TDX33029/BTCMinerControl/Miner/ST/PINOUT_DIAGRAM.html

# STM32F107VCT6 + BM1366 Miner Bridge

BTCMinerControl Pinout Diagram — Corrections applied 2026-07-12

Function | Pin | Dir | Connection | Config
ETH ETH MDC | PC1 | OUT | DP83848 MDC (pin 30) | AF Push-Pull
ETH ETH MDIO | PA2 | I/O | DP83848 MDIO (pin 31, 1.5k pull-up) | AF Push-Pull
ETH ETH REF_CLK | PA1 | IN | DP83848 X1/REF_CLK (50MHz) | Input Floating
ETH ETH CRS_DV | PA7 | IN | DP83848 CRS_DV (pin 40) | Input Floating
ETH ETH RXD0 | PC4 | IN | DP83848 RXD_0 (pin 43) | Input Floating
ETH ETH RXD1 | PC5 | IN | DP83848 RXD_1 (pin 44) | Input Floating
ETH ETH TX_EN | PB11 | OUT | DP83848 TX_EN (pin 2) | AF Push-Pull
ETH ETH TXD0 | PB12 | OUT | DP83848 TXD_0 (pin 3) | AF Push-Pull
ETH ETH TXD1 | PB13 | OUT | DP83848 TXD_1 (pin 4) | AF Push-Pull
ETH ETH RST# | PD2 | OUT | DP83848 RESET_N (pin 29) | Push-Pull
ASIC ASIC TX | PA9 | OUT | BM1366 RX (chain head) | AF Push-Pull
ASIC ASIC RX | PA10 | IN | BM1366 TX | Input Floating
ASIC ASIC RST | PB0 | OUT | BM1366 hardware reset | Push-Pull
ASIC ASIC BOOT | PB1 | OUT | BM1366 BOOT (optional) | Push-Pull
ASIC ASIC CTRL | PB14 | OUT | BM1366 CTRL (optional) | Push-Pull
LED LED STATUS | PC13 | OUT | Onboard LED (low=on) | Push-Pull
LED LED LINK | PD12 | OUT | ETH link indicator | Push-Pull
LED LED ACT | PD13 | OUT | ETH activity indicator | Push-Pull
DBG SWDIO | PA13 | I/O | Debug data | SWD
DBG SWCLK | PA14 | IN | Debug clock | SWD

? Fixes applied (2026-07-12):

1. Clock: PLLMul=9?14, SYSCLK now 70MHz (was 45MHz). SysTick reload fixed.
2. ETH PREDIV2: Added RCC_PREDIV2Config(Div5) ? PLL2 was running at 250MHz instead of 50MHz!
3. RMII mode: AFIO->MAPR MII_RMII_SEL bit was not set ? MAC was in MII mode with wrong pinout.
4. AHB clock: Added RCC_AHBPeriphClockCmd for ETH_MAC/Tx/Rx ? missing entirely.
5. LEDs: PD12 (LINK) and PD13 (ACT) added ? were documented but never initialized.
6. RCC_APB2Periph_ETH: Removed ? not defined in library V3.5; replaced with direct reg access.
