TDX33029/BTCMinerControl/Miner/BM1397-master/BM1397-master/images/Untitled 1.png

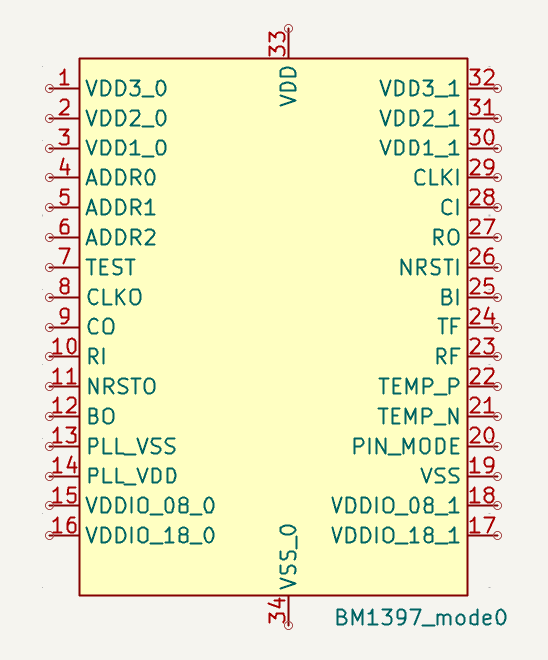
Miner/BM1397-master/BM1397-master/images/Untitled 1.png
