TDX33029/BTCMinerControl/PCB/Original/bitaxeUltra-ultra-205/bitaxeUltra-ultra-205/doc/back.png

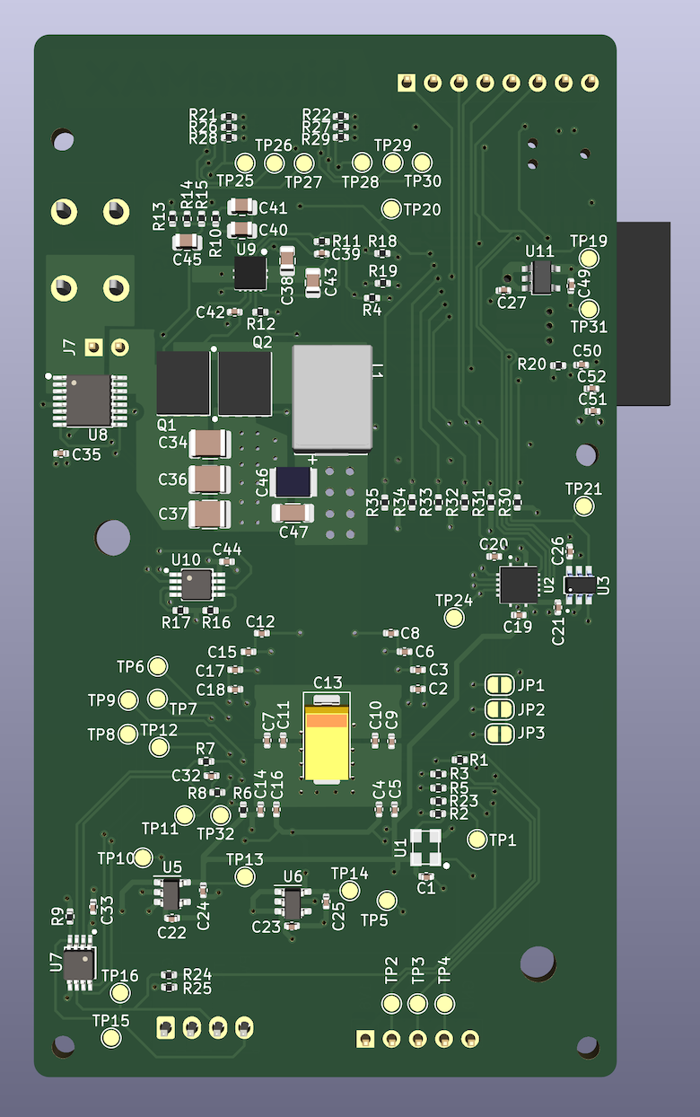
PCB/Original/bitaxeUltra-ultra-205/bitaxeUltra-ultra-205/doc/back.png
