TDX33029/BTCMinerControl/PCB/Original/bitaxeUltra-ultra-205/bitaxeUltra-ultra-205/doc/bitaxe_204.jpg

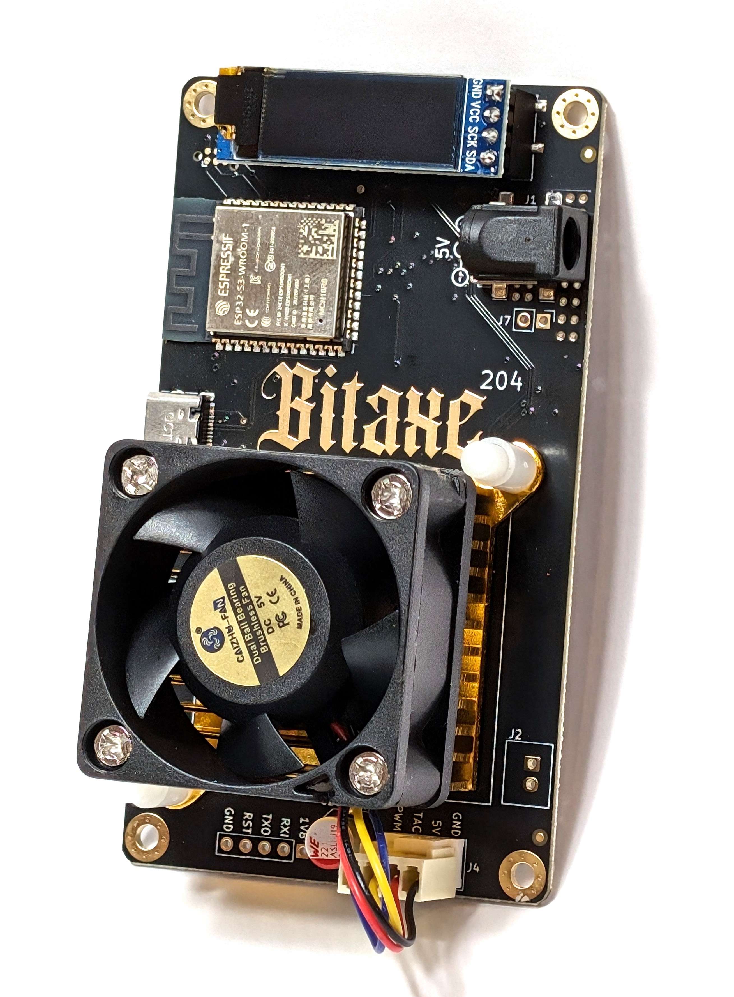
PCB/Original/bitaxeUltra-ultra-205/bitaxeUltra-ultra-205/doc/bitaxe_204.jpg
