TDX33029/BTCMinerControl/PCB/Original/bitaxeUltra-ultra-205/bitaxeUltra-ultra-205/doc/bitaxe_v2.jpg

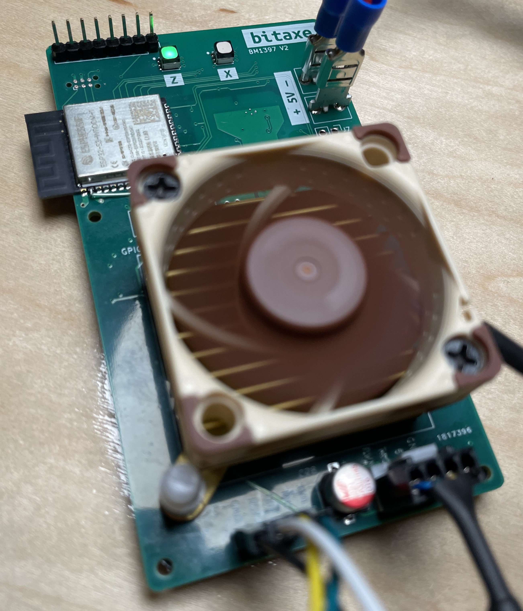
PCB/Original/bitaxeUltra-ultra-205/bitaxeUltra-ultra-205/doc/bitaxe_v2.jpg
