TDX33029/BTCMinerControl/PCB/Original/bitaxeUltra-ultra-205/bitaxeUltra-ultra-205/doc/bm1387.png

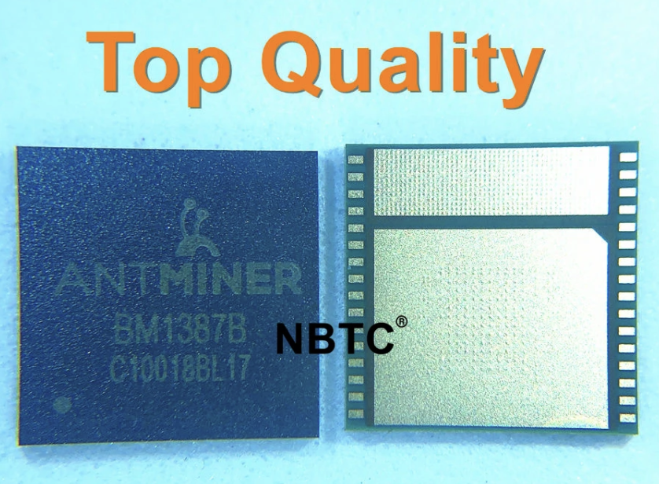
PCB/Original/bitaxeUltra-ultra-205/bitaxeUltra-ultra-205/doc/bm1387.png
