TDX33029/BTCMinerControl/PCB/Original/bitaxeUltra-ultra-205/bitaxeUltra-ultra-205/doc/BM1397.png

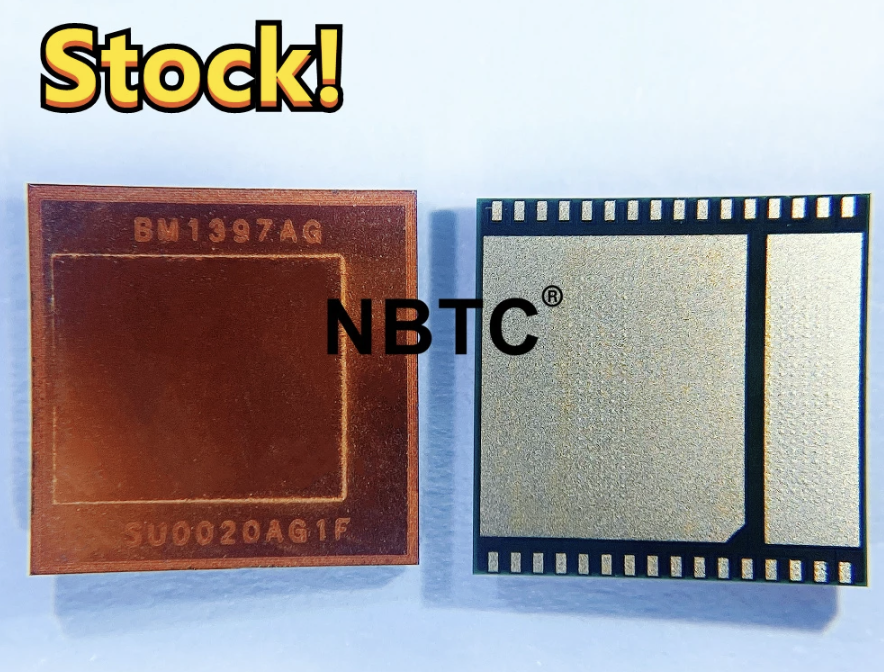
PCB/Original/bitaxeUltra-ultra-205/bitaxeUltra-ultra-205/doc/BM1397.png
