TDX33029/BTCMinerControl/PCB/Original/bitaxeUltra-ultra-205/bitaxeUltra-ultra-205/doc/built.png

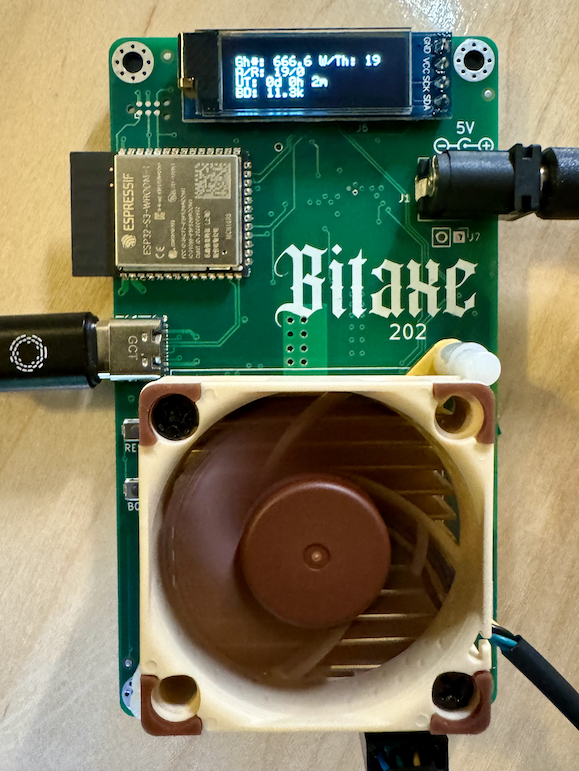
PCB/Original/bitaxeUltra-ultra-205/bitaxeUltra-ultra-205/doc/built.png
