TDX33029/BTCMinerControl/PCB/Original/bitaxeUltra-ultra-205/bitaxeUltra-ultra-205/doc/fan.png

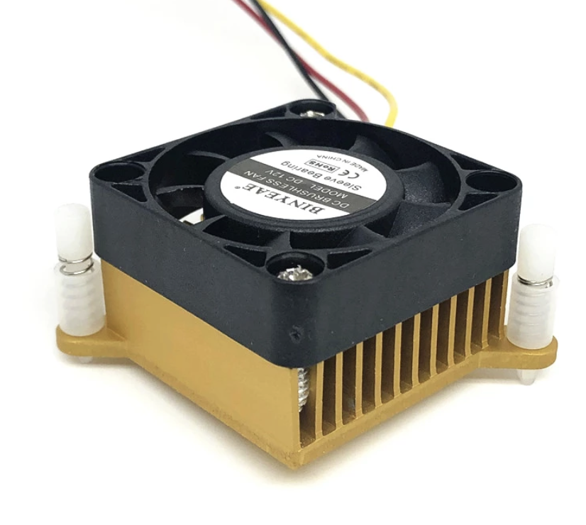
PCB/Original/bitaxeUltra-ultra-205/bitaxeUltra-ultra-205/doc/fan.png
