TDX33029/BTCMinerControl/PCB/Original/bitaxeUltra-ultra-205/bitaxeUltra-ultra-205/doc/front.png

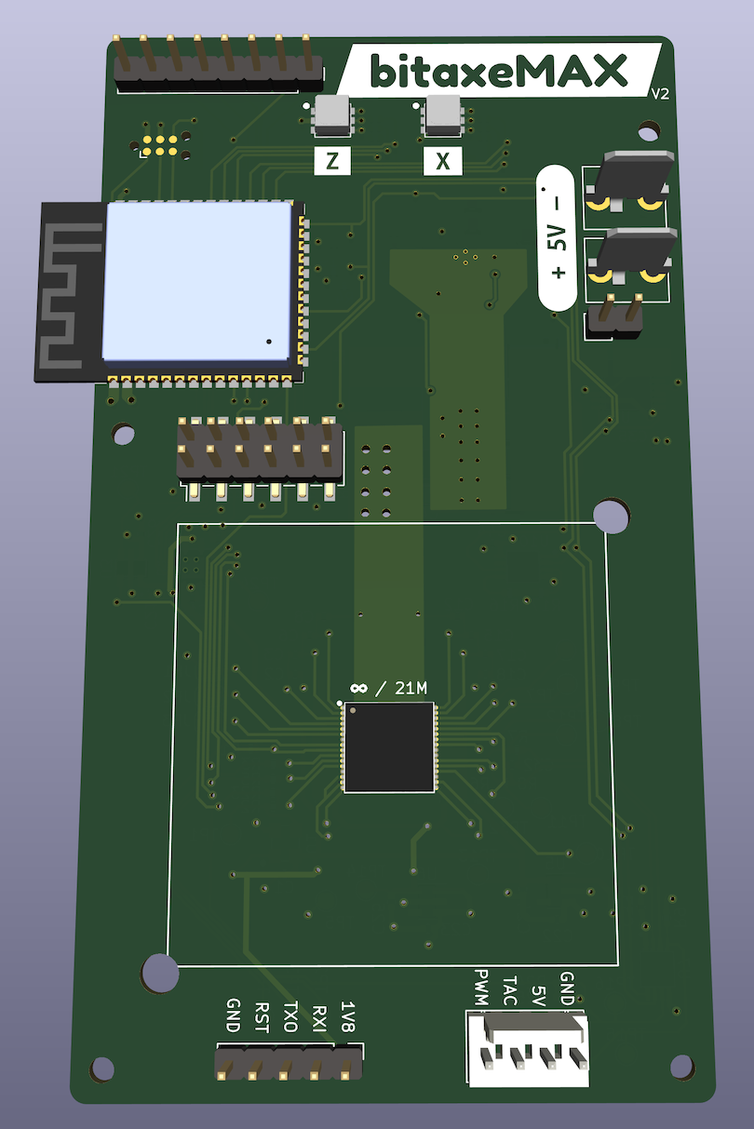
PCB/Original/bitaxeUltra-ultra-205/bitaxeUltra-ultra-205/doc/front.png
