TDX33029/BTCMinerControl/PCB/Original/bitaxeUltra-ultra-205/bitaxeUltra-ultra-205/doc/render.png

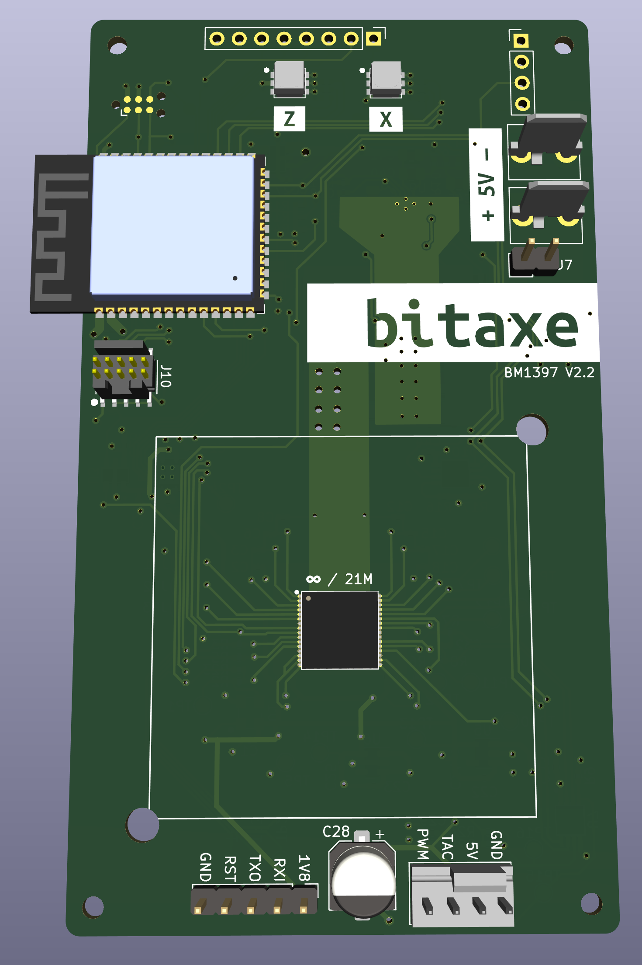
PCB/Original/bitaxeUltra-ultra-205/bitaxeUltra-ultra-205/doc/render.png
