TDX33029/BTCMinerControl/PCB/Original/bitaxeUltra-ultra-205/bitaxeUltra-ultra-205/doc/v2_both_sides.jpg

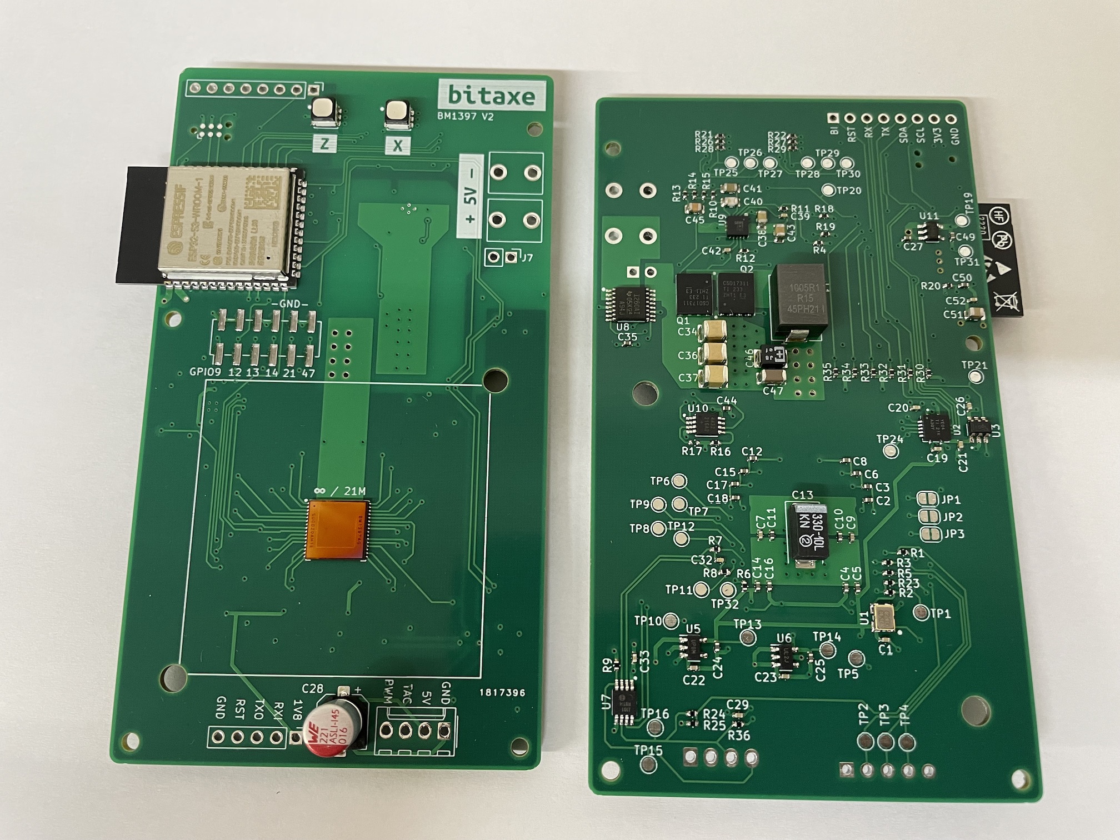
PCB/Original/bitaxeUltra-ultra-205/bitaxeUltra-ultra-205/doc/v2_both_sides.jpg
