TDX33029/BTCMinerControl/PCB/Original/ultraHex-master/ultraHex-master/_restore_backup_2026-07-17T15-32-36-407/doc/hex_render.jpg

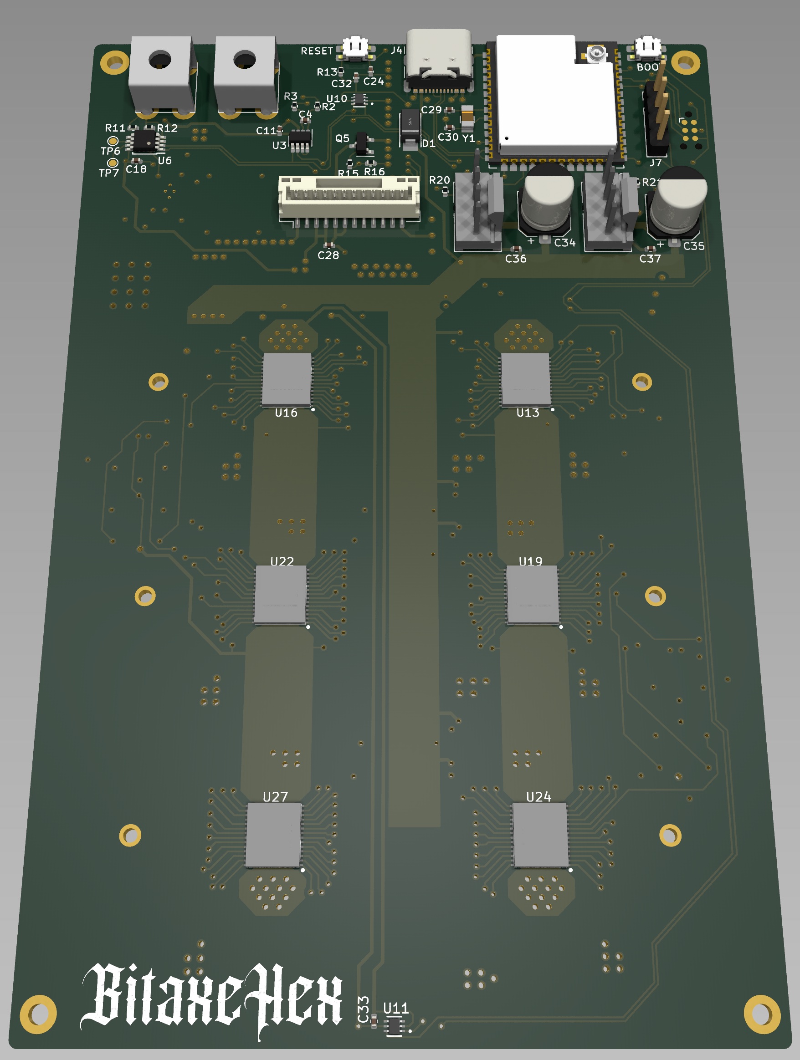
PCB/Original/ultraHex-master/ultraHex-master/_restore_backup_2026-07-17T15-32-36-407/doc/hex_render.jpg
