TDX33029/BTCMinerControl/PCB/v2-77582f2d4b02fbeb5f26dd9624d72930_1440w.webp

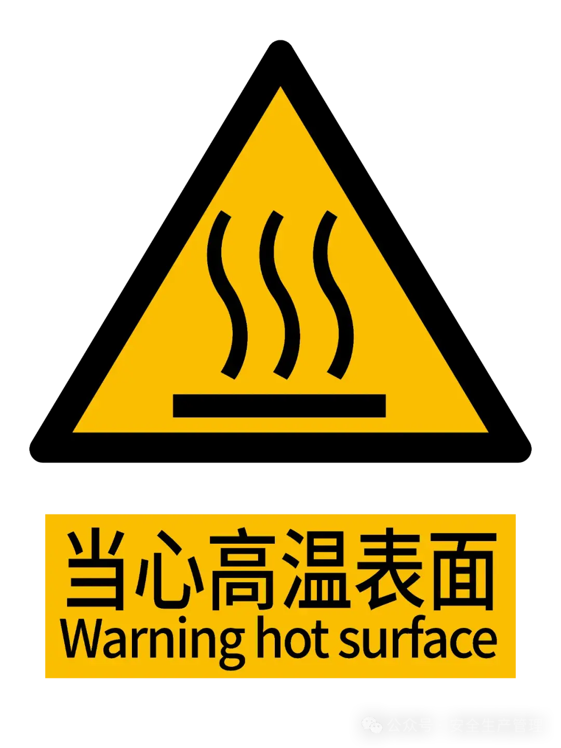
PCB/v2-77582f2d4b02fbeb5f26dd9624d72930_1440w.webp
