TDX33029/BTCMinerControl/PCB/Original/ultraHex-master/ultraHex-master/_restore_backup_2026-07-17T15-32-36-407/Manufacturing Files/bitaxeHex-301-BOM.xlsx

Qty | Reference(s) | Value | Footprint | DNP | DK | PARTNO | Value
4 | C1, C6, C9, C10 | 22uF | Capacitor_SMD:C_1210_3225Metric |  | 1276-3363-1-ND | CL32A106KBJNNNE | C
1 | C2 | 1uF | Capacitor_SMD:C_0805_2012Metric |  | 445-1419-1-ND | C2012X5R1E105K125AA | C
8 | C3, C23, C153, C154, C155, C156, C157, C159 | 10uF | Capacitor_SMD:C_0805_2012Metric |  | 490-18664-1-ND | GRM21BR61H106ME43L | C
1 | C4 | 1uF | Capacitor_SMD:C_0402_1005Metric | DNP |  |  | C
101 | C5, C11, C13, C16, C17, C18, C24, C38, C39, C40, C41, C42, C43, C46, C47, C48, C49, C50, C51, C52, C53, C54, C55, C56, C57, C58, C59, C60, C62, C63, C64, C65, C66, C67, C68, C69, C70, C71, C72, C73, C76, C77, C78, C79, C80, C81, C82, C83, C84, C85, C86, C87, C88, C89, C90, C92, C94, C95, C96, C97, C99, C100, C101, C103, C104, C105, C106, C107, C108, C109, C110, C111, C112, C115, C116, C117, C118, C119, C120, C121, C122, C123, C124, C125, C126, C127, C128, C129, C130, C131, C132, C133, C134, C135, C137, C138, C139, C143, C144, C148, C149 | 1uF | Capacitor_SMD:C_0402_1005Metric |  | 587-5514-1-ND | EMK105BJ105MV-F | C
1 | C7 | 1uF | Capacitor_SMD:C_0603_1608Metric |  | 445-12539-1-ND | CGA3E1X7R1C105K080A | C
1 | C8 | 220nF | Capacitor_SMD:C_0603_1608Metric |  | 445-12448-1-ND | CGA3E2X5R1C224M080AA | C
1 | C12 | 0.1uF | Capacitor_SMD:C_0603_1608Metric |  | 478-KGM15BR71H104KTCT-ND | KGM15BR71H104KT | C
1 | C14 | 27nF | Capacitor_SMD:C_0402_1005Metric |  | 399-C0402C273K9PAC7867CT-ND | C0402C273K9PAC7867 | C
1 | C19 | 1nF | Capacitor_SMD:C_0402_1005Metric |  | 490-3244-1-ND | GRM1555C1H102JA01D | C
1 | C20 | 120pF | Capacitor_SMD:C_0402_1005Metric |  | 13-CC0402JPNPO9BN121CT-ND | CC0402JPNPO9BN121 | C
1 | C21 | 100pF | Capacitor_SMD:C_0402_1005Metric |  | 13-CC0402JRX7R7BB101CT-ND | CC0402JRX7R7BB101 | C
1 | C22 | 220nF | Capacitor_SMD:C_0402_1005Metric |  | 311-1421-1-ND | CC0402KRX5R6BB224 | C
27 | C25, C26, C27, C28, C31, C32, C33, C36, C37, C44, C45, C61, C74, C75, C91, C93, C102, C113, C114, C136, C140, C141, C142, C146, C147, C151, C158 | 0.1uF | Capacitor_SMD:C_0402_1005Metric |  | 1292-1639-1-ND | 0402X104K100CT | 311-3342-1-ND
2 | C29, C30 | 6.8pF | Capacitor_SMD:C_0402_1005Metric |  | 399-C0402C689C5GAC7867CT-ND | C0402C689C5GAC7867 | C
2 | C34, C35 | 220uF | Capacitor_SMD:CP_Elec_6.3x7.7 |  | 732-8422-1-ND | 865080345012 | C_Polarized
3 | C98, C145, C150 | 330uF | Capacitor_Tantalum_SMD:CP_EIA-7343-31_Kemet-D_Pad2.25x2.55mm_HandSolder |  | 718-1028-1-ND | 293D337X9010E2TE3 | C_Polarized
1 | C152 | 150pF | Capacitor_SMD:C_0402_1005Metric |  | 13-CC0402JPNPO9BN151CT-ND | CC0402JPNPO9BN151 | C
1 | D1 | SS310 | Diode_SMD:D_SMA |  | SK310A-LTPMSCT-ND | SK310A-LTP | SS310_C85658
1 | D2 | XBS104S13R-G | Diode_SMD:D_SOD-323 |  | 893-1188-1-ND | XBS104S13R-G | SS310_C85658
1 | J1 | Screw Terminal | bitaxe:7771-screw-terminal |  | 36-7771-ND | 36-7771 | Conn_01x01
1 | J2 | Screw Terminal | bitaxe:7771-screw-terminal |  | 36-7771-ND | 36-7771 | Conn_01x01
1 | J4 | USB_C_Receptacle_USB2.0 | Connector_USB:USB_C_Receptacle_GCT_USB4105-xx-A_16P_TopMnt_Horizontal |  | 2073-USB4105-GF-ACT-ND | USB4105-GF-A | USB_C_Receptacle_USB2.0
2 | J5, J6 | Conn_01x04 | bitaxe:470531000 |  | WM4330-ND | 470531000 | Conn_01x04
1 | J8 | ST7789 176x320 | bitaxe:JST_GH_BM12B-GHS-TBT_1x12-1MP_P1.25mm_Vertical |  | 455-BM12B-GHS-TBTCT-ND | BM12B-GHS-TBT | ST7789 176x320
1 | L1 | 470nH | bitaxe:744373580047 |  | 732-7221-1-ND | 744373580047 | L
1 | L2 | 8.2 uH | bitaxe:74438357082 |  | 732-11745-1-ND | 78438357082 | L
1 | Q1 | CSD17303Q5 | bitaxe:SON-Q5-MOSFET |  | 296-27232-1-ND | CSD17303Q5 | Q_NMOS_CSD16340Q3
1 | Q2 | CSD17573Q5B | bitaxe:SON-Q5-MOSFET |  | 296-39836-1-ND | CSD17573Q5B | Q_NMOS_CSD17573Q5B
1 | Q5 | 2N7002K | Package_TO_SOT_SMD:SOT-323_SC-70 |  | 2N7002KWCT-ND | 2N7002KW | 2N7002K
1 | R1 | 2m | Resistor_SMD:R_1206_3216Metric |  | 13-PA1206FRE7W0R002ZCT-ND | PA1206FRE7W0R002Z | R_US
5 | R2, R3, R36, R43, R70 | 0R | Resistor_SMD:R_0402_1005Metric |  | 311-0.0JRCT-ND | RC0402JR-070RL | R_US
2 | R4, R114 | 11.8K | Resistor_SMD:R_0402_1005Metric |  | YAG2958CT-ND | RC0402FR-0711K8L | R_US
1 | R5 | 2.21R | Resistor_SMD:R_0402_1005Metric |  | 13-RC0402FR-072R21LCT-ND | RC0402FR-072R21L | R_US
1 | R6 | 3.83K | Resistor_SMD:R_0402_1005Metric |  | 311-3.83KLRCT-ND | RC0402FR-073K83L | R_US
21 | R7, R13, R16, R22, R45, R46, R52, R53, R64, R65, R73, R74, R76, R79, R80, R83, R84, R94, R95, R104, R105 | 10k | Resistor_SMD:R_0402_1005Metric |  | 311-10KJRCT-ND | RC0402JR-0710KL | R_US
1 | R8 | 887R | Resistor_SMD:R_0402_1005Metric |  | YAG3252CT-ND | RC0402FR-07887RL | R_US
3 | R9, R10, R85 | 7.87K | Resistor_SMD:R_0402_1005Metric |  | 311-7.87KLRCT-ND | RC0402FR-077K87L | R_US
1 | R11 | 80k | Resistor_SMD:R_0402_1005Metric |  | 311-80.6KLRCT-ND | RC0402FR-0780K6L | R_US
1 | R12 | DNP | Resistor_SMD:R_0402_1005Metric | DNP |  |  | R_US
2 | R14, R107 | 20K | Resistor_SMD:R_0402_1005Metric |  | 311-20.0KLRCT-ND | RC0402FR-0720KL | R_US
19 | R15, R44, R50, R51, R59, R63, R71, R72, R75, R77, R78, R81, R82, R88, R93, R102, R103, R106, R108 | 1k | Resistor_SMD:R_0402_1005Metric |  | 311-1.00KLRCT-ND | RC0402FR-071KL | R_US
20 | R17, R29, R30, R31, R33, R37, R39, R40, R47, R48, R49, R61, R66, R67, R69, R92, R96, R97, R101, R109 | 33R | Resistor_SMD:R_0402_1005Metric |  | 311-33.0LRCT-ND | RC0402FR-0733RL | R_US
6 | R23, R32, R38, R41, R42, R58 | 33R | Resistor_SMD:R_0402_1005Metric | DNP |  |  | R_US
2 | R18, R19 | 5.1k | Resistor_SMD:R_0402_1005Metric |  | 13-RC0402FR-135K1LCT-ND | RC0402FR-135K1L | R_US
2 | R20, R21 | 5.6k | Resistor_SMD:R_0402_1005Metric |  | 13-RC0402FR-135K6LCT-ND | RC0402FR-135K6L | R_US
10 | R24, R25, R27, R54, R55, R56, R86, R87, R89, R112 | 115K | Resistor_SMD:R_0402_1005Metric |  | YAG2956CT-ND | RC0402FR-07115KL | R_US
3 | R28, R57, R90 | 402K | Resistor_SMD:R_0402_1005Metric |  | YAG3015CT-ND | RC0402FR-07182KL | R_US
3 | R26, R60, R91 | 2k | Resistor_SMD:R_0402_1005Metric |  | YAG2303CT-ND | RT0402BRD072KL | R_US
6 | R34, R35, R62, R68, R98, R99 | 1R | Resistor_SMD:R_2512_6332Metric |  | CRM2512-JW-1R0ELFCT-ND | CRM2512-JW-1R0ELF | R_US
1 | R110 | 4.02K | Resistor_SMD:R_0402_1005Metric |  | 311-4.02KLRCT-ND | RC0402FR-074K02L | R_US
1 | R111 | 140R | Resistor_SMD:R_0402_1005Metric |  | 311-140LRCT-ND | RC0402FR-07140RL | R_US
2 | R100, R113 | 22.1K | Resistor_SMD:R_0402_1005Metric |  | 311-22.1KLRCT-ND | RC0402FR-0722K1L | R_US
2 | SW1, SW2 | EVQ-9P701P | bitaxe:EVQ9P701P-switch |  | P19095CT-ND | EVQ-9P701P | GT-TC029B-H025-L1N
1 | U1 | LMR54410 | Package_TO_SOT_SMD:SOT-23-6 |  | 296-LMR54410DBVRCT-ND | LMR54410FDBVR | LMR54410
1 | U2 | RT9080-33GJ5 | bitaxe:RT9080-33GJ5 |  | 1028-1509-1-ND | RT9080-33GJ5 | RT9080-33GJ5
1 | U3 | INA219AID | Package_TO_SOT_SMD:SOT-23-8 |  | 296-33291-5-ND | INA219AID | INA219AIDCNR
1 | U4 | LM27402 | Package_DFN_QFN:WQFN-16-1EP_4x4mm_P0.5mm_EP2.6x2.6mm_ThermalVias |  | LM27402SQ/NOPBCT-ND | LM27402SQ/NOPB | LM27402
1 | U5 | MIC5504 | Package_TO_SOT_SMD:SOT-23-5_HandSoldering |  | 576-4879-1-ND | MIC5504-1.8YM5-TR | MIC5504
1 | U6 | DS4432U+ | Package_SO:TSSOP-8_3x3mm_P0.65mm |  | DS4432U+-ND | DS4432U+ | DS4432U+
1 | U7 | SN74AVC4T774 | Package_SO:TSSOP-16_4.4x5mm_P0.65mm |  | 296-24739-1-ND | SN74AVC4T774PWR | SN74AVC4T774
3 | U8, U17, U28 | 25MHz | bitaxe:O 25,0-JO32-B-1V3-1-T1-LF |  | 1908-O250-JO32-B-1V3-1-T1-LFCT-ND | O 25,0-JO32-B-1V3-1-T1-LF | oscillator
1 | U9 | ESP32-S3-WROOM-1 | bitaxe:ESP32-S3-WROOM-1U |  | 1965-ESP32-S3-WROOM-1U-N16R8CT-ND | ESP32-S3-WROOM-1U-N16R8 | ESP32-S3-WROOM-1
1 | U10 | TMP1075 | bitaxe:SOT5X3-6_DRL_TEX |  | 296-TMP1075NDRLRCT-ND | TMP1075NDRLR | TMP1075
1 | U11 | TMP1075 | bitaxe:SOT5X3-6_DRL_TEX |  | 296-TMP1075NDRLRCT-ND | TMP1075NDRLR | TMP1075
1 | U12 | EMC2302 | Package_SO:MSOP-10_3x3mm_P0.5mm |  | EMC2302-2-AIZL-CT-ND | EMC2302-2-AIZL-TR | EMC2302-2-AIZL-TR
6 | U13, U16, U19, U22, U24, U27 | BM1366_mode1 | bitaxe:BM1366 |  |  |  | BM1366_mode1
6 | U14, U15, U20, U21, U25, U26 | AP7331 | Package_TO_SOT_SMD:TSOT-23-5 |  | AP7331-WG-7DICT-ND | AP7331-WG-7 | AP7331-WG-7
2 | U18, U23 | TLV3544 | Package_SO:TSSOP-14_4.4x5mm_P0.65mm |  | 296-45352-1-ND | TLV3544IPWR | TLV3544
1 | Y1 | 32.768kHz | bitaxe:SC32S-7PF20PPM |  | 728-1074-1-ND | SC32S-7PF20PPM | Crystal
