TDX33029/BTCMinerControl/PCB/Original/ultraHex-master/ultraHex-master/_restore_backup_2026-07-17T15-32-36-407/Manufacturing Files/bitaxeHex-302-BOM.xlsx

Sheet: bitaxeHex
Bitaxe Hex v302 BOM
Qty | Reference(s) | Value | Footprint | DK | PARTNO
1 | R1 | DNP | Resistor_SMD:R_0402_1005Metric
1 | R2 | 17.8K | Resistor_SMD:R_0402_1005Metric | RMCF0402FT17K8TR-ND | RMCF0402FT17K8TR
1 | R3 | DNP | Resistor_SMD:R_0402_1005Metric
1 | R4 | 17.8K | Resistor_SMD:R_0402_1005Metric | RMCF0402FT17K8TR-ND | RMCF0402FT17K8
1 | R5 | 10K | Resistor_SMD:R_0402_1005Metric | RMCF0402FT10K0TR-ND | RMCF0402FT10K0
1 | R6 | 31.6K | Resistor_SMD:R_0402_1005Metric | YAG3115TR-ND | RC0402FR-0731K6L
1 | R7 | DNP | Resistor_SMD:R_0402_1005Metric
1 | R10 | 26.1K | Resistor_SMD:R_0402_1005Metric | 311-26.1KLRTR-ND | RC0402FR-0726K1L
22 | R15, R18, R22, R28, R29, R30, R47, R48, R59, R60, R67, R68, R75, R76, R81, R82, R86, R87, R100, R101, R105, R106 | 10k | Resistor_SMD:R_0402_1005Metric | 311-10KJRCT-ND | RC0402JR-0710KL
1 | R8 | 12.7K | Resistor_SMD:R_0402_1005Metric | YAG2964CT-ND | RC0402FR-0712K7L
2 | R9, R17 | 1.37K | Resistor_SMD:R_0402_1005Metric | YAG3035CT-ND | RC0402FR-071K37L
10 | R11, R31, R32, R33, R54, R55, R57, R88, R89, R90 | 115k | Resistor_SMD:R_0402_1005Metric | YAG2956CT-ND | RC0402FR-07115KL
2 | R12, R20 | 22.1k | Resistor_SMD:R_0402_1005Metric | 311-22.1KLRCT-ND | RC0402FR-0722K1L
1 | R13 | 10R | Resistor_SMD:R_0402_1005Metric | 311-10.0LRCT-ND | RC0402FR-0710RL
1 | R14 | 1R | Resistor_SMD:R_1206_3216Metric | CSR1206FT1R00CT-ND | CSR1206FT1R00
1 | R16 | 49.9R | Resistor_SMD:R_0402_1005Metric | 311-49.9LRCT-ND | RC0402FR-0749R9L
1 | R19 | 7.87k | Resistor_SMD:R_0402_1005Metric | 311-7.87KLRCT-ND | RC0402FR-077K87L
1 | R21 | 20k | Resistor_SMD:R_0402_1005Metric | 311-20.0KLRCT-ND | RC0402FR-0720KL
19 | R23, R46, R52, R58, R62, R66, R71, R74, R77, R79, R80, R84, R85, R94, R99, R102, R104, R107, R108 | 1k | Resistor_SMD:R_0402_1005Metric | 311-1.00KLRCT-ND | RC0402FR-071KL
2 | R24, R25 | 5.1k | Resistor_SMD:R_0402_1005Metric | 13-RC0402FR-135K1LCT-ND | RC0402FR-135K1L
2 | R26, R27 | 5.6k | Resistor_SMD:R_0402_1005Metric | 13-RC0402FR-135K6LCT-ND | RC0402FR-135K6L
3 | R34, R56, R91 | 402K | Resistor_SMD:R_0402_1005Metric | YAG3151CT-ND | RC0402FR-07402KL
20 | R35, R36, R37, R41, R43, R44, R45, R49, R50, R51, R61, R69, R70, R72, R78, R83, R92, R93, R95, R103 | 33 | Resistor_SMD:R_0402_1005Metric | 311-33.0LRCT-ND | RC0402FR-0733RL
6 | R38, R39, R63, R65, R96, R98 | 1 | Resistor_SMD:R_2512_6332Metric | CRM2512-JW-1R0ELFCT-ND | CRM2512-JW-1R0ELF
3 | R40, R64, R97 | 2k | Resistor_SMD:R_0402_1005Metric | YAG2303CT-ND | RT0402BRD072KL
6 | R42, R53, R73, R109, R110, R111 | 0 | Resistor_SMD:R_0402_1005Metric | 311-0.0JRCT-ND | RC0402JR-070RL
1 | C1 | 4.7nF | Capacitor_SMD:C_0402_1005Metric | 490-1309-1-ND | GRM155R71E472KA01D
2 | C2, C29 | 180uF | Capacitor_SMD:CP_Elec_6.3x5.9 | P16479CT-ND | 16SVPF180M
5 | C3, C11, C19, C20, C30 | 10uF | Capacitor_SMD:C_0805_2012Metric | 490-18664-1-ND | GRM21BR61H106ME43L
4 | C4, C7, C8, C10 | 22uF | Capacitor_SMD:C_1210_3225Metric | 490-3889-1-ND | GRM32ER61E226KE15L
1 | C5 | 1uF | Capacitor_SMD:C_0603_1608Metric | 490-1550-1-ND | GRM188R60J105KA01D
1 | C6 | 0.1uF | Capacitor_SMD:C_0603_1608Metric | 478-KGM15BR71H104KTCT-ND | KGM15BR71H104KT
99 | C9, C17, C21, C24, C31, C45, C46, C47, C48, C51, C52, C53, C54, C55, C56, C57, C58, C59, C61, C63, C64, C65, C66, C67, C69, C70, C71, C72, C74, C75, C76, C77, C78, C79, C80, C81, C83, C85, C86, C87, C88, C89, C90, C91, C92, C93, C94, C96, C98, C99, C100, C101, C102, C104, C105, C106, C107, C108, C110, C111, C112, C113, C114, C116, C117, C118, C119, C120, C121, C122, C123, C124, C125, C128, C129, C130, C131, C132, C133, C134, C135, C137, C139, C140, C141, C142, C143, C144, C145, C146, C148, C150, C151, C152, C153, C154, C156, C157, C158 | 1uF | Capacitor_SMD:C_0402_1005Metric | 587-5514-1-ND | EMK105BJ105MV-F
27 | C12, C32, C33, C34, C35, C38, C39, C40, C43, C44, C49, C50, C60, C62, C73, C82, C84, C95, C97, C109, C115, C126, C127, C136, C138, C149, C155 | 0.1uF | Capacitor_SMD:C_0402_1005Metric | 478-KGM05AR71C104KHCT-ND | KGM05AR71C104KH
1 | C13 | 100nF | Capacitor_SMD:C_0402_1005Metric | 490-6321-1-ND | GRM155R71A104KA01D
2 | C14, C15 | 1uF | Capacitor_SMD:C_0805_2012Metric | 587-1291-1-ND | TMK212BJ105KG-T
2 | C16, C26 | 2.2nF | Capacitor_SMD:C_0402_1005Metric | 490-8257-1-ND | GRM155R61H222KA01D
1 | C18 | 4.7uF | Capacitor_SMD:C_0402_1005Metric | 490-14306-1-ND | GRM155R61A475MEAAD
1 | C22 | 1nF | Capacitor_SMD:C_0805_2012Metric | 311-1127-1-ND | CC0805KRX7R9BB102
1 | C23 | 100nF | Capacitor_SMD:C_0805_2012Metric | 478-KGM21NR71E104KTCT-ND | KGM21NR71E104KT
1 | C25 | 100pF | Capacitor_SMD:C_0402_1005Metric | 732-7431-1-ND | 885012005013
2 | C27, C28 | 47uF | Capacitor_SMD:C_1210_3225Metric | 490-6539-1-ND | GRM32ER61C476KE15L
2 | C41, C42 | 220uF | Capacitor_SMD:CP_Elec_6.3x7.7 | 732-8422-1-ND | 865080345012
3 | C68, C103, C147 | 330uF | Capacitor_Tantalum_SMD:CP_EIA-7343-31_Kemet-D_Pad2.25x2.55mm_HandSolder | 718-1028-1-ND | 293D337X9010E2TE3
1 | L1 | 8.2 uH | bitaxe:74438357082 | 732-11745-1-ND | 78438357082
1 | L2 | 680nH | Inductor_SMD:L_Coilcraft_XAL1010-XXX | 2457-XAL1010-681MED-ND | XAL1010-681MED
1 | Q1 | 2N7002K | Package_TO_SOT_SMD:SOT-323_SC-70 | 2N7002KWCT-ND | 2N7002KW
1 | D1 | SS310 | Diode_SMD:D_SMA | SK310A-LTPMSCT-ND | SK310A-LTP
1 | U1 | LMR54410 | Package_TO_SOT_SMD:SOT-23-6 | 296-LMR54410DBVRCT-ND | LMR54410FDBVR
1 | U2 | RT9080-33GJ5 | bitaxe:RT9080-33GJ5 | 1028-1509-1-ND | RT9080-33GJ5
1 | U3 | TPS546D24ARVFR | bitaxe:LQFN40-CLIP | 296-TPS546D24ARVFRCT-ND | TPS546D24ARVFR
1 | U4 | MIC5504 | Package_TO_SOT_SMD:SOT-23-5_HandSoldering | 576-4879-1-ND | MIC5504-1.8YM5-TR
1 | U5 | SN74AVC4T774 | Package_SO:TSSOP-16_4.4x5mm_P0.65mm | 296-24739-1-ND | SN74AVC4T774PWR
1 | U6 | ESP32-S3-WROOM-1 | bitaxe:ESP32-S3-WROOM-1U | 1965-ESP32-S3-WROOM-1U-N16R8CT-ND | ESP32-S3-WROOM-1U-N16R8
2 | U7, U8 | TMP1075 | bitaxe:SOT5X3-6_DRL_TEX | 296-TMP1075NDRLRCT-ND | TMP1075NDRLR
1 | U9 | EMC2302 | Package_SO:MSOP-10_3x3mm_P0.5mm | EMC2302-2-AIZL-CT-ND | EMC2302-2-AIZL-TR
6 | U10, U11, U16, U17, U23, U24 | AP7331 | Package_TO_SOT_SMD:TSOT-23-5 | AP7331-WG-7DICT-ND | AP7331-WG-7
6 | U12, U13, U18, U20, U22, U25 | BM1366 | bitaxe:BM1366
3 | U14, U19, U26 | 25MHz | bitaxe:O 25,0-JO32-B-1V3-1-T1-LF | 1908-O250-JO32-B-1V3-1-T1-LFCT-ND | O 25,0-JO32-B-1V3-1-T1-LF
2 | U15, U21 | TLV3544 | Package_SO:TSSOP-14_4.4x5mm_P0.65mm | 296-45352-1-ND | TLV3544IPWR
2 | SW1, SW2 | SWITCH-SPST | bitaxe:EVQ9P701P-switch | P19095CT-ND | EVQ-9P701P
2 | J1, J2 | Screw Terminal | bitaxe:7771-screw-terminal | 36-7771-ND | 36-7771
1 | J3 | Conn_02x05 | Connector_PinHeader_2.54mm:PinHeader_2x05_P2.54mm_Vertical
1 | J4 | Connector-12x1 | bitaxe:JST_GH_BM12B-GHS-TBT_1x12-1MP_P1.25mm_Vertical | 455-BM12B-GHS-TBTCT-ND | BM12B-GHS-TBT
1 | J7 | USB_C_Receptacle | Connector_USB:USB_C_Receptacle_GCT_USB4105-xx-A_16P_TopMnt_Horizontal | 2073-USB4105-GF-ACT-ND | USB4105-GF-A
2 | J8, J9 | Conn_01x04 | bitaxe:470531000 | WM4330-ND | 470531000

Sheet: Config
Config resistors
Pin |  |  | RefDes | Code | Rvalue
MSEL2 | Rmsel2t | top | R1
 | Rmsel2b | bottom | R5 |  | 0R
VSEL | Rvselt | top | R2 | 10 | 2.05K
 | Rvselb | bottom | R6 | 0 | 4.64K
ADRSEL | Radrt | top | R3 | 6 | 10K
 | Radrb | bottom | R7 | 4 | 10K
MSEL1 | Rmsel1t | top | R4 | 2 | 205.0K
 | Rmsel1b | bottom | R10 | 15 | 82.5K
