TDX33029/BTCMinerControl/PCB/Original/ultraHex-master/ultraHex-master/_restore_backup_2026-07-17T15-32-36-407/Manufacturing Files/bitaxeHex-300-BOM.xlsx

Sheet: BOM
Qty | Ref Des | Value | DK | Manufacturer | PARTNO | DNP
3 | C1, C2, C6 | 22uF | 445-1655-1-ND |  | CKG57NX5R1H226M500JH
1 | C3 | 0.33uF | 490-GRM155R61J334ME01JCT-ND |  | GRM155R61J334ME01J
1 | C4 | 1uF | 587-5514-1-ND |  | EMK105BJ105MV-F | DNP
101 | C5, C11, C13, C16, C17, C18, C24, C38, C39, C40, C41, C42, C43, C46, C47, C48, C49, C50, C51, C52, C53, C54, C55, C56, C57, C58, C59, C60, C62, C63, C64, C65, C66, C67, C68, C69, C70, C71, C72, C73, C76, C77, C78, C79, C80, C81, C82, C83, C84, C85, C86, C87, C88, C89, C90, C92, C94, C95, C96, C97, C99, C100, C101, C103, C104, C105, C106, C107, C108, C109, C110, C111, C112, C115, C116, C117, C118, C119, C120, C121, C122, C123, C124, C125, C126, C127, C128, C129, C130, C131, C132, C133, C134, C135, C137, C138, C139, C143, C144, C148, C149 | 1uF | 587-5514-1-ND |  | EMK105BJ105MV-F
1 | C7 | 270pF | 399-C0805C271J5GAC7800CT-ND |  | C0805C271J5GAC7800
1 | C8 | 1uF | 1276-6471-1-ND |  | CL21B105KOFNNNG
1 | C9 | 5600pF | 445-6944-1-ND |  | CGA4C2C0G1H562J060AA
1 | C10 | 3300pF | 1276-1552-1-ND |  | CL05B332KB5NNNC
28 | C12, C14, C25, C26, C27, C28, C31, C32, C33, C36, C37, C44, C45, C61, C74, C75, C91, C93, C102, C113, C114, C136, C140, C141, C142, C146, C147, C151 | 0.1uF | 1292-1639-1-ND |  | 0402X104K100CT
1 | C15 | 4.7uF | 490-14466-1-ND |  | GRM21BR71C475KE51L
1 | C19 | 680pF | 311-1126-1-ND |  | CC0805KRX7R9BB681
3 | C20, C21, C22 | 10uF | 1276-6641-1-ND |  | CL31B106MOHNNNE
1 | C23 | 10uF | 1276-1096-1-ND |  | CL21A106KOQNNNE
2 | C29, C30 | 6.8pF | 399-C0402C689C5GAC7867CT-ND |  | C0402C689C5GAC7867
2 | C34, C35 | 220uF | 732-8422-1-ND |  | 865080345012
3 | C98, C145, C150 | 330uF | 718-1028-1-ND |  | 293D337X9010E2TE3
1 | D1 | SS310 | SK310A-LTPMSCT-ND |  | SK310A-LTP
1 | J1 | Screw Terminal | 36-7770-ND |  | 36-7770
1 | J2 | Conn_01x01 | A100886CT-ND |  | 63862-1
1 | J4 | USB_C_Receptacle_USB2.0 | 2073-USB4105-GF-ACT-ND |  | USB4105-GF-A
2 | J5, J6 | Conn_01x04 | WM4330-ND |  | 0470531000
1 | J8 | ST7789 176x320 | 455-BM12B-GHS-TBTCT-ND |  | BM12B-GHS-TBT
1 | L1 | 470nH | 732-7221-1-ND |  | 744373580047
2 | Q1, Q3 | NTMFS5C673NLT1G | NTMFS5C673NLT1GOSCT-ND |  | NTMFS5C673NLT1G
2 | Q2, Q4 | CSD17577Q5A | 296-39996-1-ND |  | CSD17577Q5A
1 | Q5 | BSS123 | 4530-BSS123CT-ND |  | BSS123
1 | Q6 | 2N7002K | 2N7002KWCT-ND |  | 2N7002KW
1 | R1 | 2m | 13-PA1206FRE7W0R002ZCT-ND |  | PA1206FRE7W0R002Z
5 | R2, R3, R36, R43, R70 | 0 | 311-0.0JRCT-ND |  | RC0402JR-070RL
1 | R4 | 1.33k | 311-1.33KLRCT-ND |  | RC0402FR-071K33L
1 | R5 | 100k | 311-100KJRCT-ND |  | RC0402JR-07100KL | DNP
1 | R6 | 6.49k | 311-6.49KLRCT-ND |  | RC0402FR-076K49L
20 | R7, R9, R13, R16, R22, R46, R52, R53, R64, R65, R73, R74, R79, R80, R83, R84, R94, R95, R104, R105 | 10k | 311-10KJRCT-ND |  | RC0402JR-0710KL
1 | R8 | 487 | YAG2373CT-ND |  | RC0402FR-07487RL
1 | R10 | 1.54k | YAG3040CT-ND |  | RC0402FR-071K54L
1 | R11 | 80k | 311-80.6KLRCT-ND |  | RC0402FR-0780K6L
1 | R12 | DNP |  |  |  | DNP
1 | R14 | 20K | 311-20.0KLRCT-ND |  | RC0402FR-0720KL
20 | R15, R44, R45, R50, R51, R59, R63, R71, R72, R75, R77, R78, R81, R82, R88, R93, R102, R103, R106, R108 | 1k | 311-1.00KLRCT-ND |  | RC0402FR-071KL
20 | R17, R29, R30, R31, R33, R37, R39, R40, R47, R48, R49, R61, R66, R67, R69, R92, R96, R97, R101, R109 | 33 | 311-33.0LRCT-ND |  | RC0402FR-0733RL
2 | R18, R19 | 5.1k | 13-RC0402FR-135K1LCT-ND |  | RC0402FR-135K1L
2 | R20, R21 | 5.6k | 13-RC0402FR-135K6LCT-ND |  | RC0402FR-135K6L
6 | R23, R32, R38, R41, R42, R58 | 33 | 311-33.0LRCT-ND |  | RC0402FR-0733RL | DNP
3 | R24, R54, R86 | 309k 1% | YAG3108CT-ND |  | RC0402FR-07309KL
3 | R25, R55, R87 | 69.8k 1% | YAG3216CT-ND |  | RC0402FR-0769K8L
3 | R26, R60, R91 | 2k | YAG2303CT-ND |  | RT0402BRD072KL
6 | R27, R28, R56, R57, R89, R90 | 182k 1% | YAG3015CT-ND |  | RC0402FR-07182KL
6 | R34, R35, R62, R68, R98, R99 | 1R 2W | CRM2512-JW-1R0ELFCT-ND |  | CRM2512-JW-1R0ELF
2 | SW1, SW2 | EVQ-9P701P | P19095CT-ND | G-Switch(品赞) | EVQ-9P701P
1 | U1 | uA7805 | 296-20796-1-ND |  | UA7805CKTTR
1 | U2 | RT9080-33GJ5 | 1028-1509-1-ND |  | RT9080-33GJ5
1 | U3 | INA219AID | 296-33291-5-ND | TI(德州仪器) | INA219AID
1 | U4 | TPS40305 | 296-37445-1-ND |  | TPS40305DRCR
1 | U5 | MIC5504 | 576-4879-1-ND |  | MIC5504-1.8YM5-TR
1 | U6 | DS4432U+ | DS4432U+-ND |  | DS4432U+
1 | U7 | SN74AVC4T774 | 296-24739-1-ND |  | SN74AVC4T774PWR
3 | U8, U17, U28 | 25MHz | 1908-O250-JO32-B-1V3-1-T1-LFCT-ND |  | O 25,0-JO32-B-1V3-1-T1-LF
1 | U9 | ESP32-S3-WROOM-1 | 1965-ESP32-S3-WROOM-1U-N16R8CT-ND |  | ESP32-S3-WROOM-1U-N16R8
1 | U10 | TMP1075 | 296-TMP1075NDRLRCT-ND |  | TMP1075NDRLR
1 | U11 | TMP1075 | 296-TMP1075NDRLRCT-ND |  | TMP1075NDRLR
1 | U12 | EMC2302 | EMC2302-2-AIZL-CT-ND |  | EMC2302-2-AIZL-TR
2 | U13, U24 | BM1366_mode1
6 | U14, U15, U20, U21, U25, U26 | ADP171AUJ-R7 | 505-ADP171AUJZ-R7CT-ND |  | ADP171AUJZ-R7
2 | U16, U27 | BM1366_mode1
2 | U18, U23 | TLV3544 | 296-45352-1-ND |  | TLV3544IPWR
1 | U19 | BM1366_mode0
1 | U22 | BM1366_mode0
1 | Y1 | 32.768kHz | 728-1074-1-ND |  | SC32S-7PF20PPM

Sheet: DK Order
Qty | Ref Des | DK
3 | C1, C2, C6 | 445-1655-1-ND
1 | C3 | 490-GRM155R61J334ME01JCT-ND
101 | C5, C11, C13, C16, C17, C18, C24, C38, C39, C40, C41, C42, C43, C46, C47, C48, C49, C50, C51, C52, C53, C54, C55, C56, C57, C58, C59, C60, C62, C63, C64, C65, C66, C67, C68, C69, C70, C71, C72, C73, C76, C77, C78, C79, C80, C81, C82, C83, C84, C85, C86, C87, C88, C89, C90, C92, C94, C95, C96, C97, C99, C100, C101, C103, C104, C105, C106, C107, C108, C109, C110, C111, C112, C115, C116, C117, C118, C119, C120, C121, C122, C123, C124, C125, C126, C127, C128, C129, C130, C131, C132, C133, C134, C135, C137, C138, C139, C143, C144, C148, C149 | 587-5514-1-ND
1 | C7 | 399-C0805C271J5GAC7800CT-ND
1 | C8 | 1276-6471-1-ND
1 | C9 | 445-6944-1-ND
1 | C10 | 1276-1552-1-ND
28 | C12, C14, C25, C26, C27, C28, C31, C32, C33, C36, C37, C44, C45, C61, C74, C75, C91, C93, C102, C113, C114, C136, C140, C141, C142, C146, C147, C151 | 1292-1639-1-ND
1 | C15 | 490-14306-1-ND
1 | C19 | 311-1126-1-ND
3 | C20, C21, C22 | 445-7592-1-ND
1 | C23 | 1276-1096-1-ND
2 | C29, C30 | 399-C0402C689C5GAC7867CT-ND
2 | C34, C35 | 732-8422-1-ND
3 | C98, C145, C150 | 718-1028-1-ND
1 | D1 | SK310A-LTPMSCT-ND
1 | J1 | 36-7770-ND
1 | J2 | A100886CT-ND
1 | J4 | 2073-USB4105-GF-ACT-ND
2 | J5, J6 | WM4330-ND
1 | J8 | 455-BM12B-GHS-TBTCT-ND
1 | L1 | 732-7221-1-ND
2 | Q1, Q3 | NTMFS5C673NLT1GOSCT-ND
2 | Q2, Q4 | 296-39996-1-ND
1 | Q5 | 4530-BSS123CT-ND
1 | Q6 | 2N7002KWCT-ND
1 | R1 | 13-PA1206FRE7W0R002ZCT-ND
5 | R2, R3, R36, R43, R70 | 311-0.0JRCT-ND
1 | R4 | 311-1.33KLRCT-ND
1 | R5 | 311-100KJRCT-ND
1 | R6 | 311-6.49KLRCT-ND
20 | R7, R9, R13, R16, R22, R46, R52, R53, R64, R65, R73, R74, R79, R80, R83, R84, R94, R95, R104, R105 | 311-10KJRCT-ND
1 | R8 | YAG2373CT-ND
1 | R10 | YAG3040CT-ND
1 | R11 | 311-80.6KLRCT-ND
1 | R14 | 311-20.0KLRCT-ND
20 | R15, R44, R45, R50, R51, R59, R63, R71, R72, R75, R77, R78, R81, R82, R88, R93, R102, R103, R106, R108 | 311-1.00KLRCT-ND
20 | R17, R29, R30, R31, R33, R37, R39, R40, R47, R48, R49, R61, R66, R67, R69, R92, R96, R97, R101, R109 | 311-33.0LRCT-ND
2 | R18, R19 | 13-RC0402FR-135K1LCT-ND
2 | R20, R21 | 13-RC0402FR-135K6LCT-ND
3 | R24, R54, R86 | YAG3108CT-ND
3 | R25, R55, R87 | YAG3216CT-ND
3 | R26, R60, R91 | YAG2303CT-ND
6 | R27, R28, R56, R57, R89, R90 | YAG3015CT-ND
6 | R34, R35, R62, R68, R98, R99 | 118-CR2512-F/-1R00ELFCT-ND
2 | SW1, SW2 | P19095CT-ND
1 | U1 | 296-20796-1-ND
1 | U2 | 1028-1509-1-ND
1 | U3 | 296-33291-5-ND
1 | U4 | 296-37445-1-ND
1 | U5 | 576-4879-1-ND
1 | U6 | DS4432U+-ND
1 | U7 | 296-24739-1-ND
3 | U8, U17, U28 | 1908-O250-JO32-B-1V3-1-T1-LFCT-ND
1 | U9 | 1965-ESP32-S3-WROOM-1U-N16R8CT-ND
1 | U10 | 296-TMP1075NDRLRCT-ND
1 | U11 | 296-TMP1075NDRLRCT-ND
1 | U12 | EMC2302-2-AIZL-CT-ND
2 | U13, U24
6 | U14, U15, U20, U21, U25, U26 | 505-ADP171AUJZ-R7CT-ND
2 | U16, U27
2 | U18, U23 | 296-45352-1-ND
1 | U19
1 | U22
1 | Y1 | 728-1074-1-ND
