TDX33029/BTCMinerControl/Miner/BM1397-master/BM1397-master/cad/QFN-44-1EP_8x8mm_P0.65mm_EP6.6x6.6mm.step

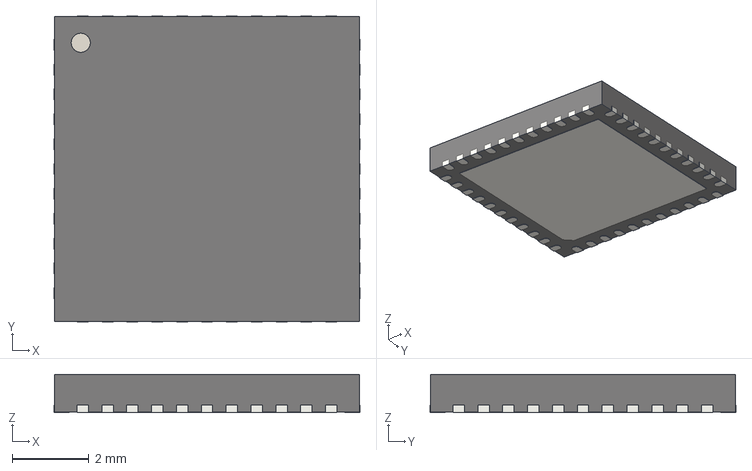
[picture p25: CAD file, 2026-08-08]
Miner/BM1397-master/BM1397-master/cad/QFN-44-1EP_8x8mm_P0.65mm_EP6.6x6.6mm.step
8.00 x 8.00 x 1.00 mm
