TDX33029/BTCMinerControl/PCB/Original/bitaxeUltra-ultra-205/bitaxeUltra-ultra-205/3d/Bitaxe_Heatsink.step

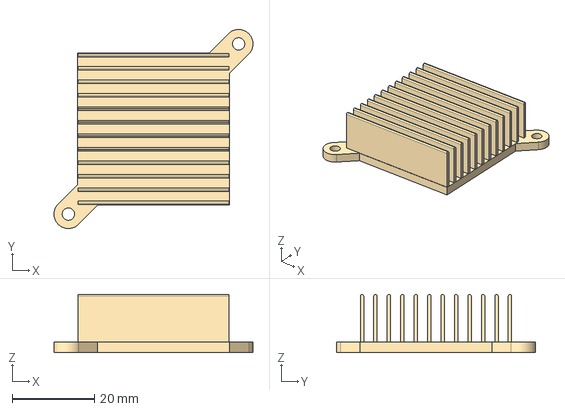
[picture p26: CAD file, 2026-07-11]
PCB/Original/bitaxeUltra-ultra-205/bitaxeUltra-ultra-205/3d/Bitaxe_Heatsink.step
48.4 x 48.4 x 14.1 mm
