TDX33029/BTCMinerControl/PCB/Original/ultraHex-master/ultraHex-master/_restore_backup_2026-07-17T15-32-36-407/3d/SOT-23-5_M5_MCH.step

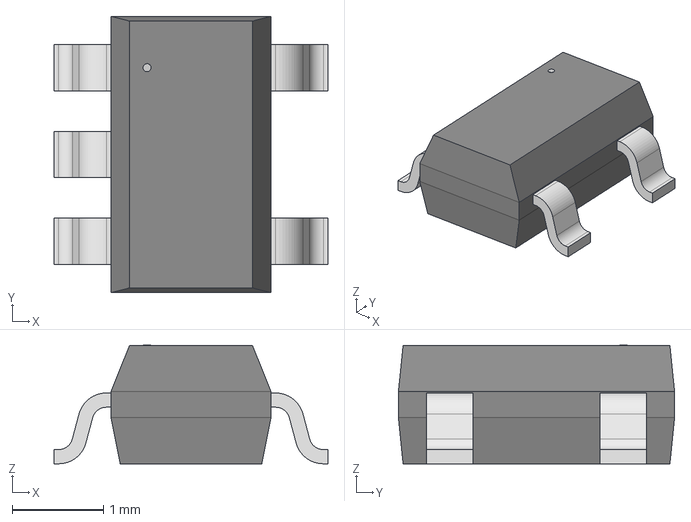
[picture p27: CAD file, 2026-07-11]
PCB/Original/ultraHex-master/ultraHex-master/_restore_backup_2026-07-17T15-32-36-407/3d/SOT-23-5_M5_MCH.step
3.00 x 3.02 x 1.30 mm
