TDX33029/BTCMinerControl/PCB/Original/bitaxeUltra-ultra-205/bitaxeUltra-ultra-205/3d/DISST7789-176x320.STEP

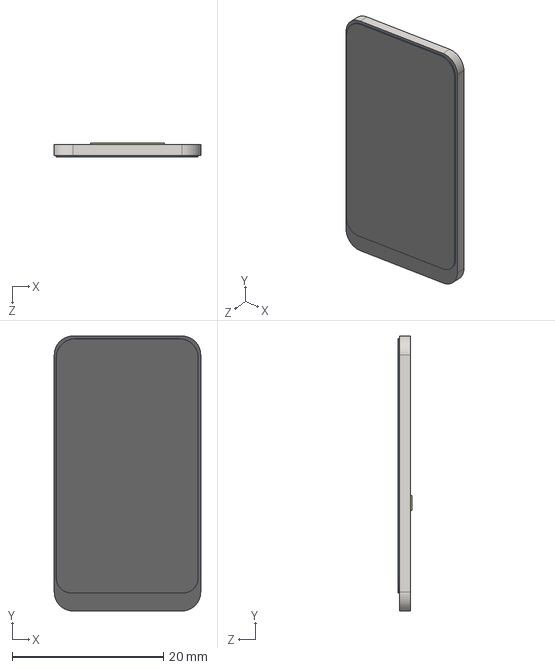
[picture p28: CAD file, 2026-07-11]
PCB/Original/bitaxeUltra-ultra-205/bitaxeUltra-ultra-205/3d/DISST7789-176x320.STEP
19.4 x 36.4 x 1.86 mm
