TDX33029/BTCMinerControl/PCB/Original/bitaxeUltra-ultra-205/bitaxeUltra-ultra-205/3d/USB_10118193-0001LF.STEP

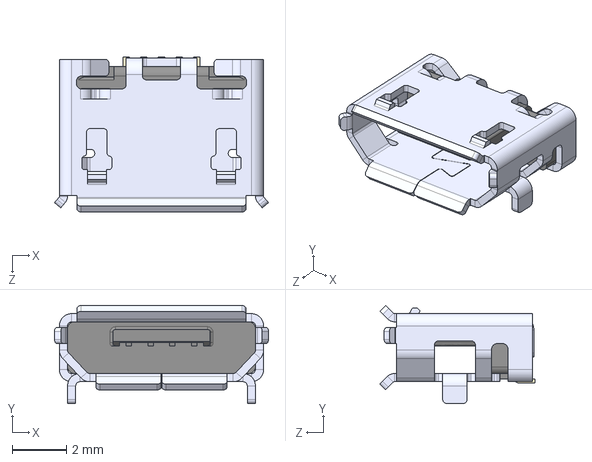
[picture p30: CAD file, 2026-07-11]
PCB/Original/bitaxeUltra-ultra-205/bitaxeUltra-ultra-205/3d/USB_10118193-0001LF.STEP
7.86 x 3.60 x 5.71 mm
