TDX33029/BTCMinerControl/PCB/Original/bitaxeUltra-ultra-205/bitaxeUltra-ultra-205/3d/CUI_DEVICES_PJ-036AH-SMT-TR.step

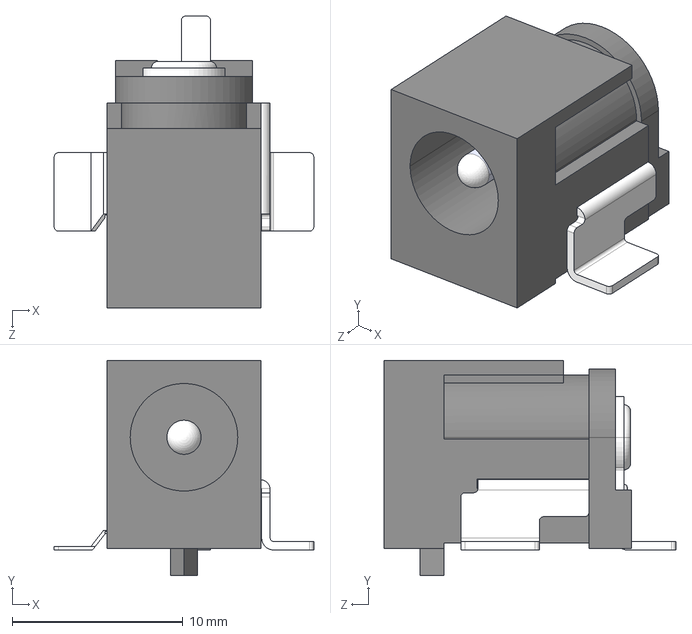
[picture p32: CAD file, 2026-07-11]
PCB/Original/bitaxeUltra-ultra-205/bitaxeUltra-ultra-205/3d/CUI_DEVICES_PJ-036AH-SMT-TR.step
15.2 x 12.6 x 17.1 mm
