TDX33029/BTCMinerControl/PCB/Original/ultraHex-master/ultraHex-master/_restore_backup_2026-07-17T15-32-36-407/3d/bm1366.STP

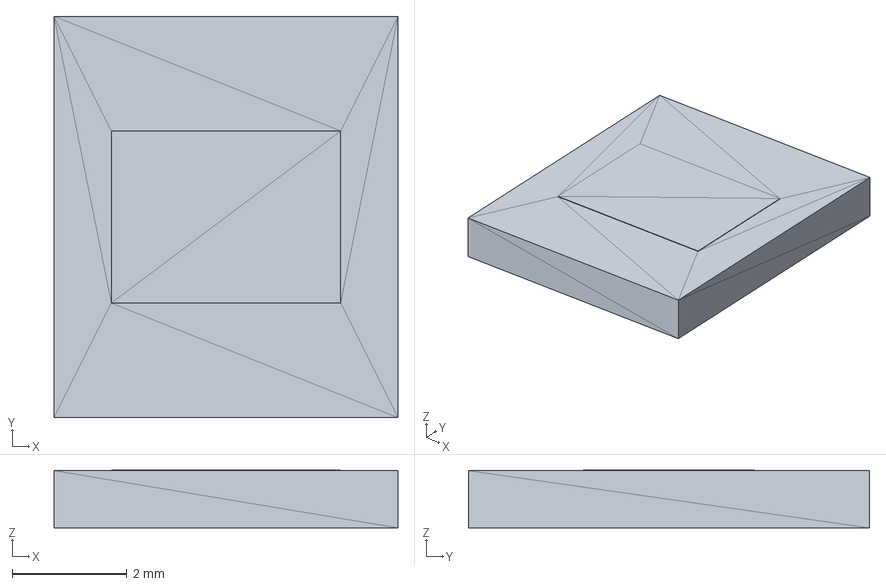
[picture p33: CAD file, 2026-07-11]
PCB/Original/ultraHex-master/ultraHex-master/_restore_backup_2026-07-17T15-32-36-407/3d/bm1366.STP
6.00 x 7.00 x 1.01 mm
