TDX33029/BTCMinerControl/PCB/Original/bitaxeUltra-ultra-205/bitaxeUltra-ultra-205/3d/OLED_0.91_128x32.stp

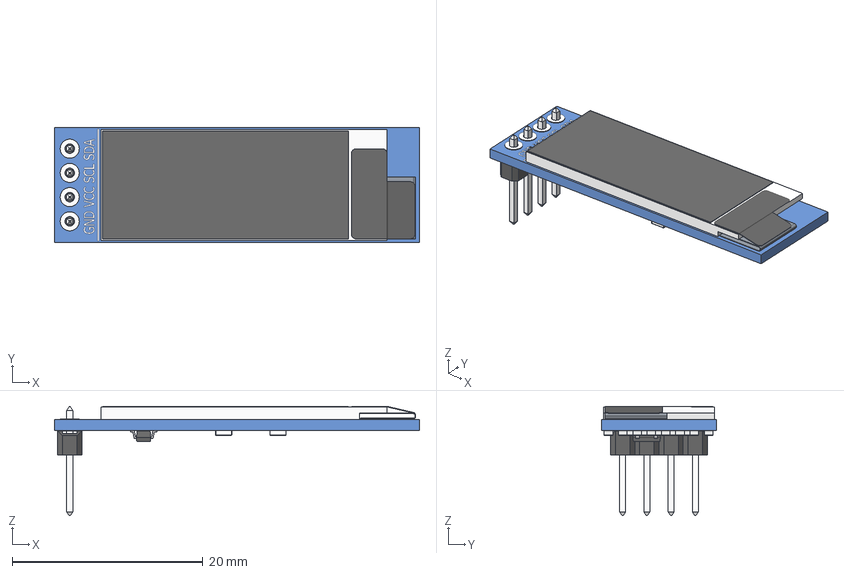
[picture p34: CAD file, 2026-07-11]
PCB/Original/bitaxeUltra-ultra-205/bitaxeUltra-ultra-205/3d/OLED_0.91_128x32.stp
38.3 x 12.1 x 11.5 mm
OLED_0.91_128x32
Pin Header 4 x 1 TH 2.54mm Pitch
RESC-0603 x 13
2SD0601A
