TDX33029/BTCMinerControl/PCB/Original/ultraHex-master/ultraHex-master/_restore_backup_2026-07-17T15-32-36-407/3d/EVQ-9P701P.stp

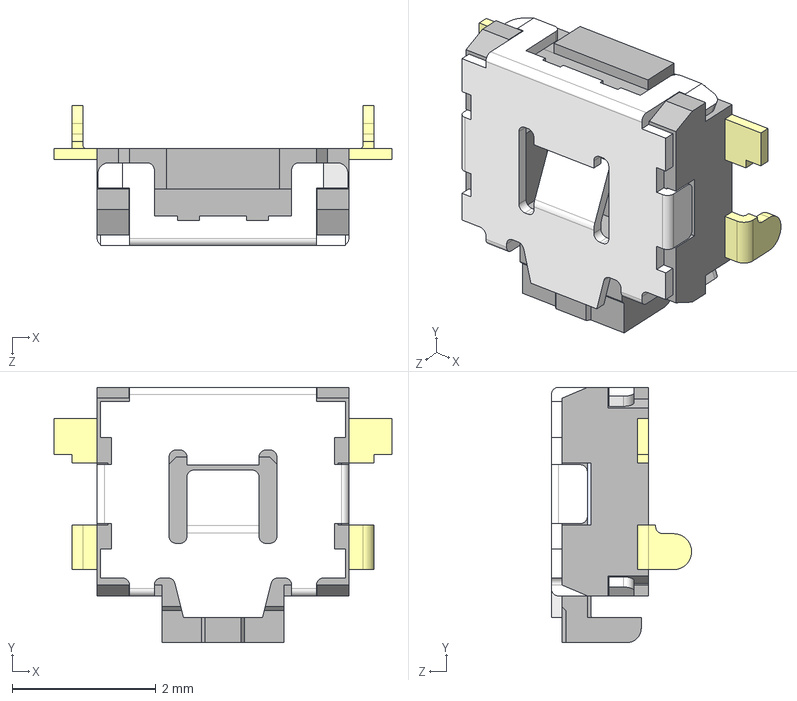
[picture p35: CAD file, 2026-07-11]
PCB/Original/ultraHex-master/ultraHex-master/_restore_backup_2026-07-17T15-32-36-407/3d/EVQ-9P701P.stp
4.70 x 3.55 x 1.95 mm
