TDX33029/BTCMinerControl/PCB/Original/bitaxeUltra-ultra-205/bitaxeUltra-ultra-205/3d/CUI_DEVICES_PJ-002AH.step

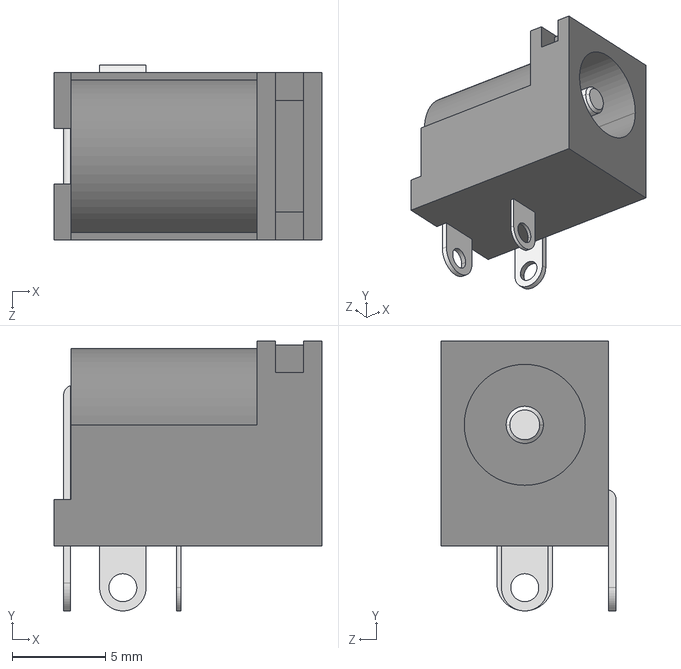
[picture p36: CAD file, 2026-07-11]
PCB/Original/bitaxeUltra-ultra-205/bitaxeUltra-ultra-205/3d/CUI_DEVICES_PJ-002AH.step
14.4 x 14.5 x 9.40 mm
