TDX33029/BTCMinerControl/PCB/Original/ultraHex-master/ultraHex-master/_restore_backup_2026-07-17T15-32-36-407/3d/TSOT-23-5_RIT.step

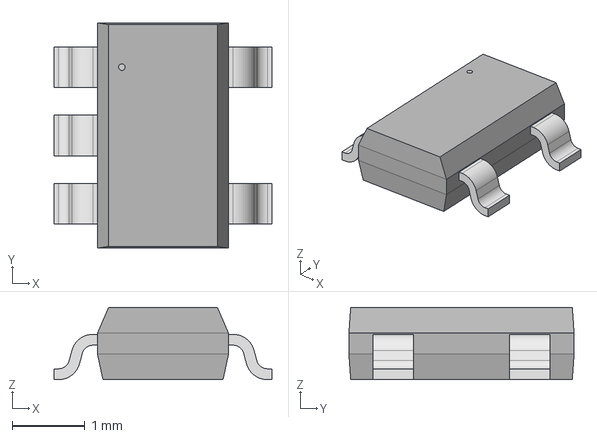
[picture p37: CAD file, 2026-07-11]
PCB/Original/ultraHex-master/ultraHex-master/_restore_backup_2026-07-17T15-32-36-407/3d/TSOT-23-5_RIT.step
3.00 x 3.10 x 0.993 mm
