TDX33029/BTCMinerControl/PCB/Original/bitaxeUltra-ultra-205/bitaxeUltra-ultra-205/3d/oscillator3.2x2.5.step

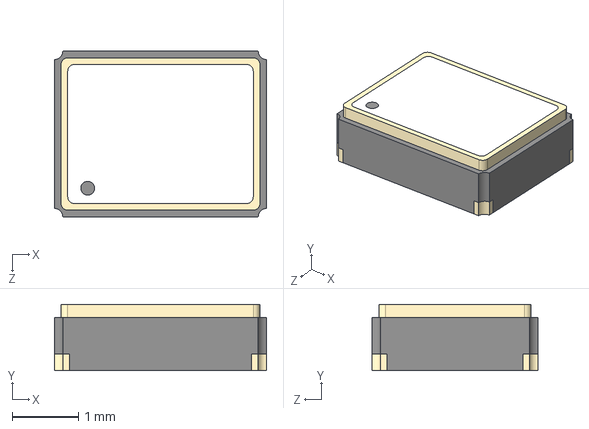
[picture p40: CAD file, 2026-07-11]
PCB/Original/bitaxeUltra-ultra-205/bitaxeUltra-ultra-205/3d/oscillator3.2x2.5.step
3.20 x 1.00 x 2.50 mm
