TDX33029/BTCMinerControl/PCB/Original/bitaxeUltra-ultra-205/bitaxeUltra-ultra-205/3d/CS1213AG-tr.stp

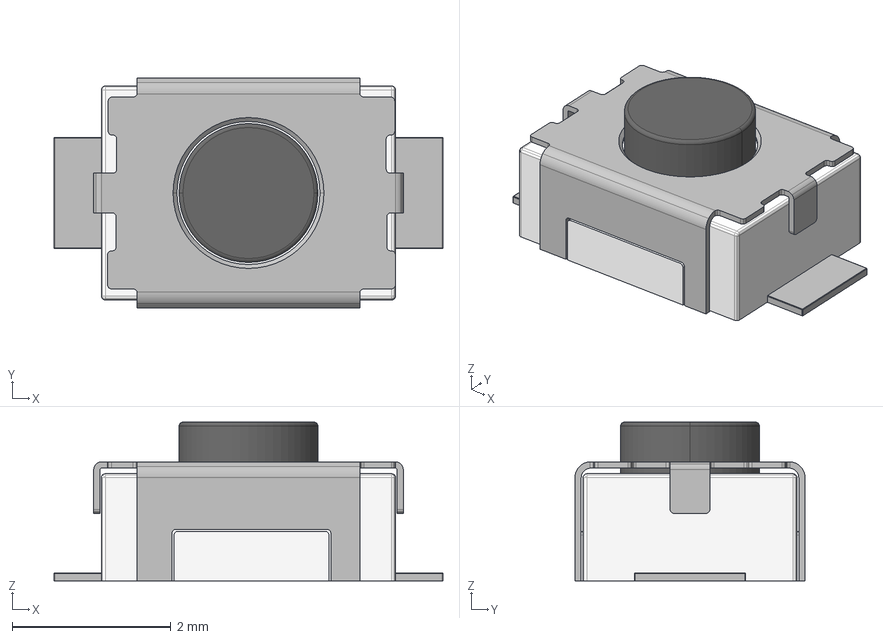
[picture p42: CAD file, 2026-07-11]
PCB/Original/bitaxeUltra-ultra-205/bitaxeUltra-ultra-205/3d/CS1213AG-tr.stp
4.90 x 2.90 x 2.00 mm
