TDX33029/BTCMinerControl/PCB/Original/bitaxeUltra-ultra-205/bitaxeUltra-ultra-205/3d/CUI_DEVICES_PJ-037AH.step

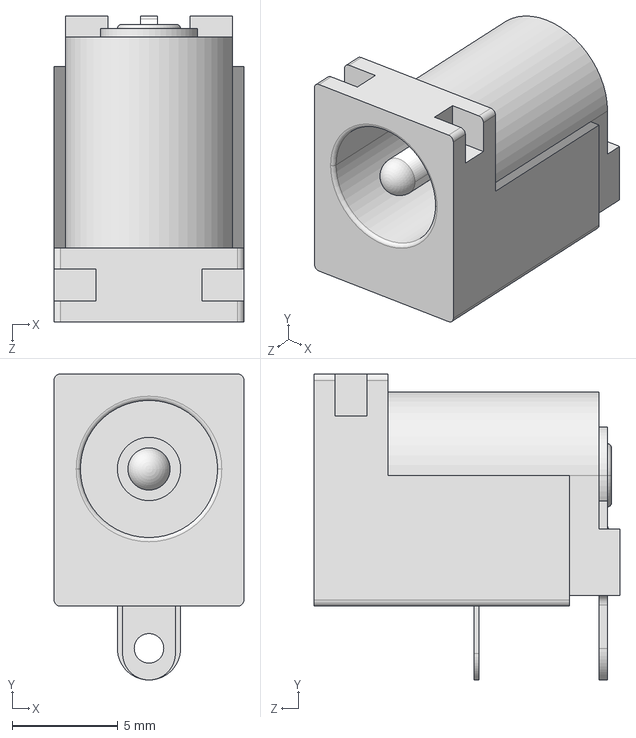
[picture p44: CAD file, 2026-07-11]
PCB/Original/bitaxeUltra-ultra-205/bitaxeUltra-ultra-205/3d/CUI_DEVICES_PJ-037AH.step
9.00 x 14.5 x 14.5 mm
