TDX33029/BTCMinerControl/PCB/Original/bitaxeUltra-ultra-205/bitaxeUltra-ultra-205/3d/SW_CS1213AGF260_CRS.step

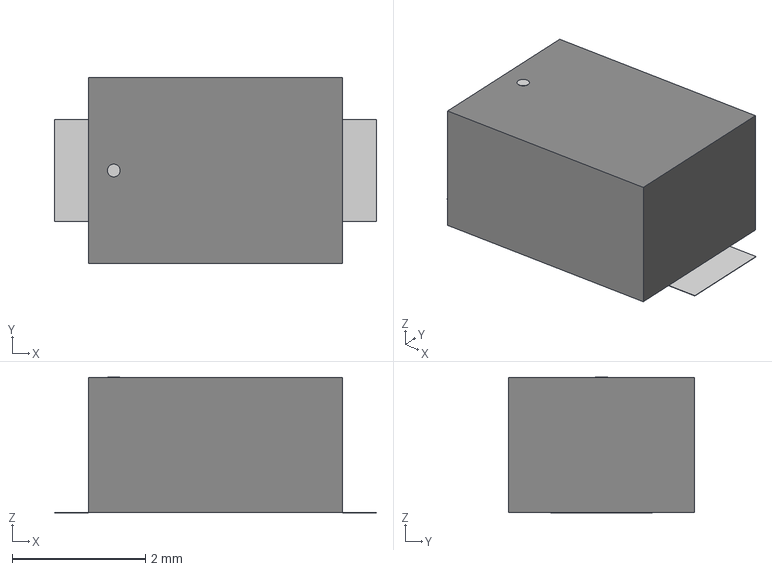
[picture p45: CAD file, 2026-07-11]
PCB/Original/bitaxeUltra-ultra-205/bitaxeUltra-ultra-205/3d/SW_CS1213AGF260_CRS.step
4.83 x 2.79 x 2.04 mm
