TDX33029/BTCMinerControl/PCB/Original/ultraHex-master/ultraHex-master/_restore_backup_2026-07-17T15-32-36-407/3d/NTMFS5C673NLT1G.STEP

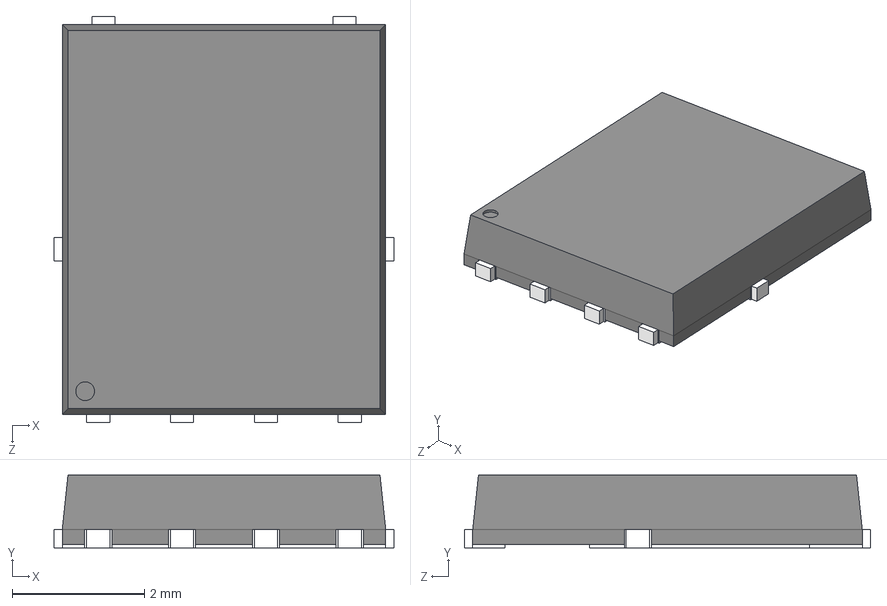
[picture p47: CAD file, 2026-07-11]
PCB/Original/ultraHex-master/ultraHex-master/_restore_backup_2026-07-17T15-32-36-407/3d/NTMFS5C673NLT1G.STEP
5.15 x 1.10 x 6.15 mm
