TDX33029/BTCMinerControl/PCB/Original/ultraHex-master/ultraHex-master/_restore_backup_2026-07-17T15-32-36-407/3d/RUM0016A.stp

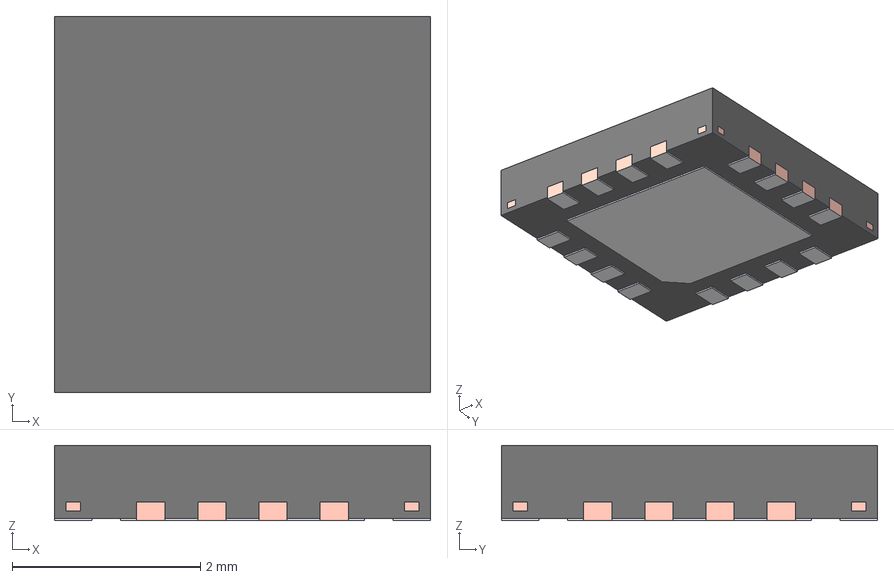
[picture p50: CAD file, 2026-07-11]
PCB/Original/ultraHex-master/ultraHex-master/_restore_backup_2026-07-17T15-32-36-407/3d/RUM0016A.stp
4.00 x 4.00 x 0.8 mm
FRAME
PIN1_AREA
