TDX33029/BTCMinerControl/PCB/Original/ultraHex-master/ultraHex-master/_restore_backup_2026-07-17T15-32-36-407/3d/CX3225SB16000H0FLJCC.STEP

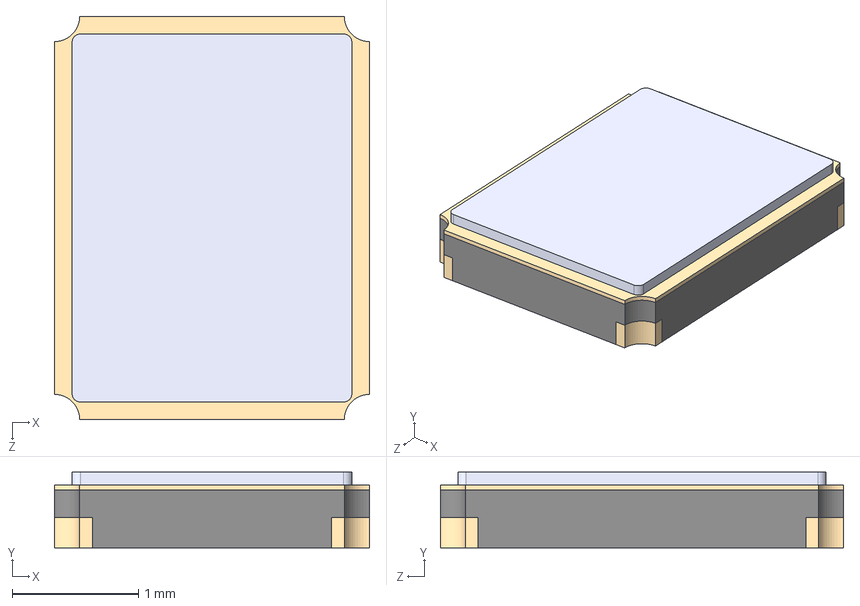
[picture p51: CAD file, 2026-07-11]
PCB/Original/ultraHex-master/ultraHex-master/_restore_backup_2026-07-17T15-32-36-407/3d/CX3225SB16000H0FLJCC.STEP
2.50 x 0.6 x 3.20 mm
