TDX33029/BTCMinerControl/PCB/Original/ultraHex-master/ultraHex-master/_restore_backup_2026-07-17T15-32-36-407/3d/RVF0040A.stp

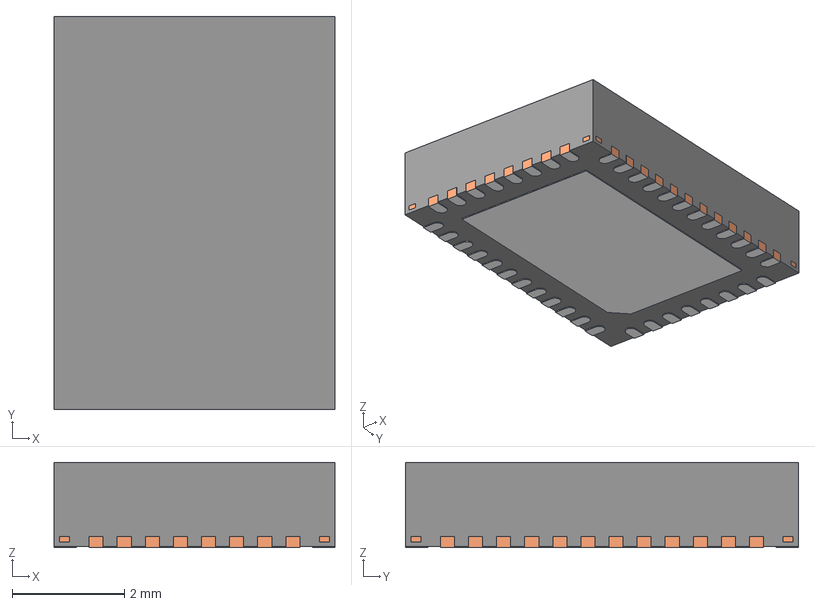
[picture p54: CAD file, 2026-07-11]
PCB/Original/ultraHex-master/ultraHex-master/_restore_backup_2026-07-17T15-32-36-407/3d/RVF0040A.stp
5.00 x 7.00 x 1.52 mm
BODY-QFN
FRAME-RVF0040A
PIN1-ID
