TDX33029/BTCMinerControl/PCB/Original/ultraHex-master/ultraHex-master/_restore_backup_2026-07-17T15-32-36-407/3d/IND_4030-WE-MAPI_WRE.step

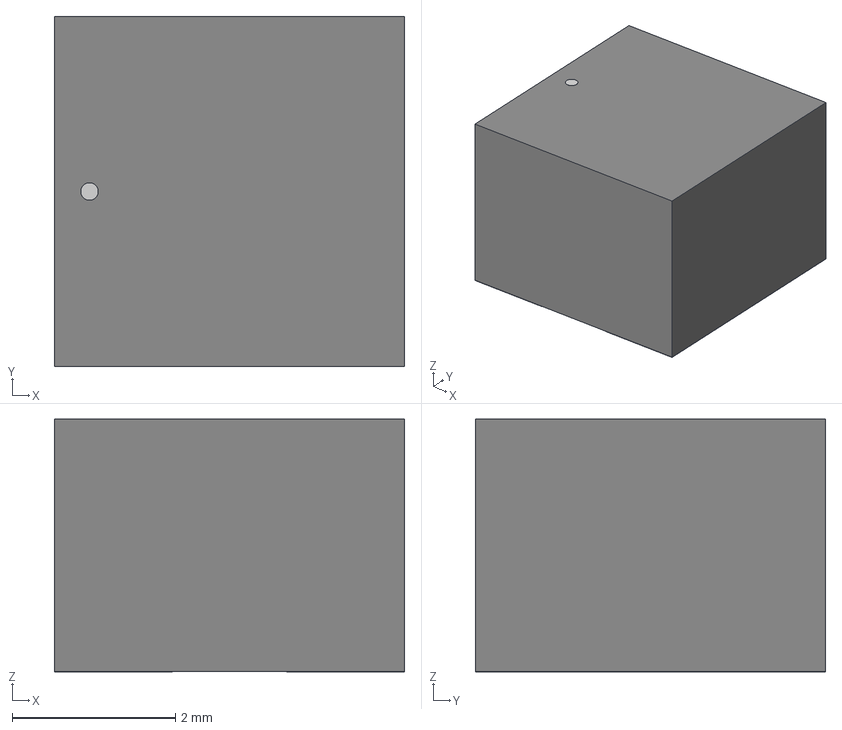
[picture p56: CAD file, 2026-07-11]
PCB/Original/ultraHex-master/ultraHex-master/_restore_backup_2026-07-17T15-32-36-407/3d/IND_4030-WE-MAPI_WRE.step
4.29 x 4.29 x 3.10 mm
