TDX33029/BTCMinerControl/PCB/Original/ultraHex-master/ultraHex-master/_restore_backup_2026-07-17T15-32-36-407/3d/XRCGB27M120F3M10R0_MUR.step

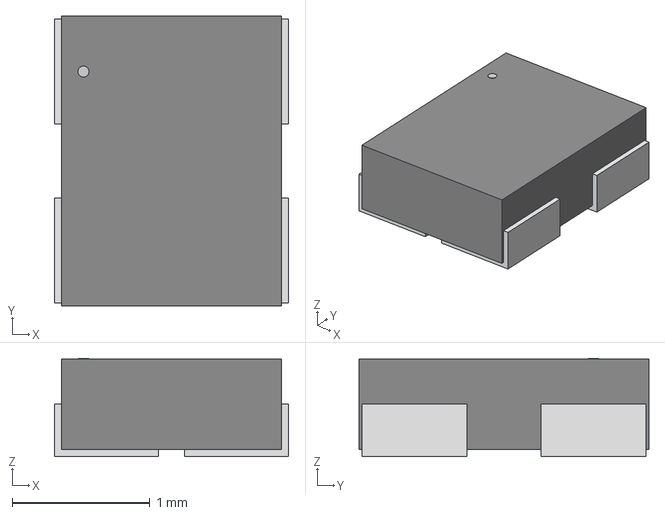
[picture p57: CAD file, 2026-07-11]
PCB/Original/ultraHex-master/ultraHex-master/_restore_backup_2026-07-17T15-32-36-407/3d/XRCGB27M120F3M10R0_MUR.step
1.70 x 2.11 x 0.714 mm
