TDX33029/BTCMinerControl/PCB/Original/ultraHex-master/ultraHex-master/_restore_backup_2026-07-17T15-32-36-407/3d/21-0164B_L622-1_MXM.step

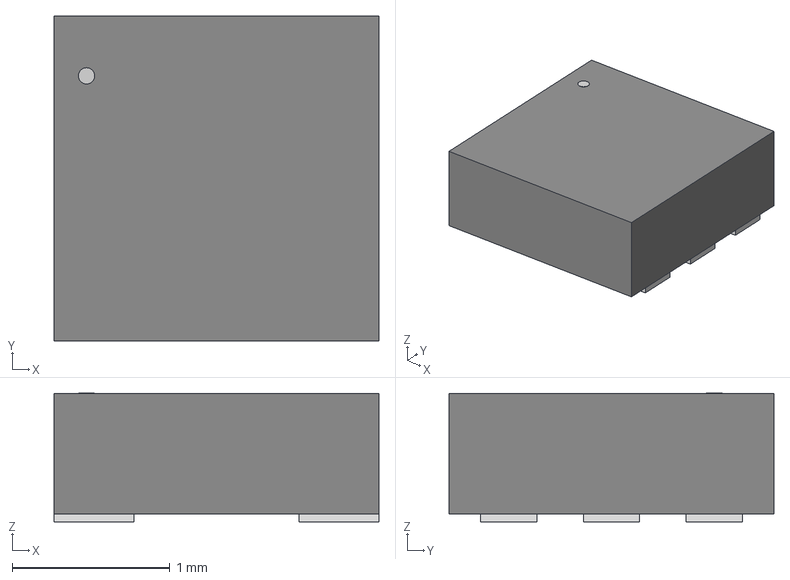
[picture p58: CAD file, 2026-07-11]
PCB/Original/ultraHex-master/ultraHex-master/_restore_backup_2026-07-17T15-32-36-407/3d/21-0164B_L622-1_MXM.step
2.06 x 2.06 x 0.815 mm
