TDX33029/BTCMinerControl/PCB/Original/ultraHex-master/ultraHex-master/_restore_backup_2026-07-17T15-32-36-407/3d/c-63862-1-r-3d.stp

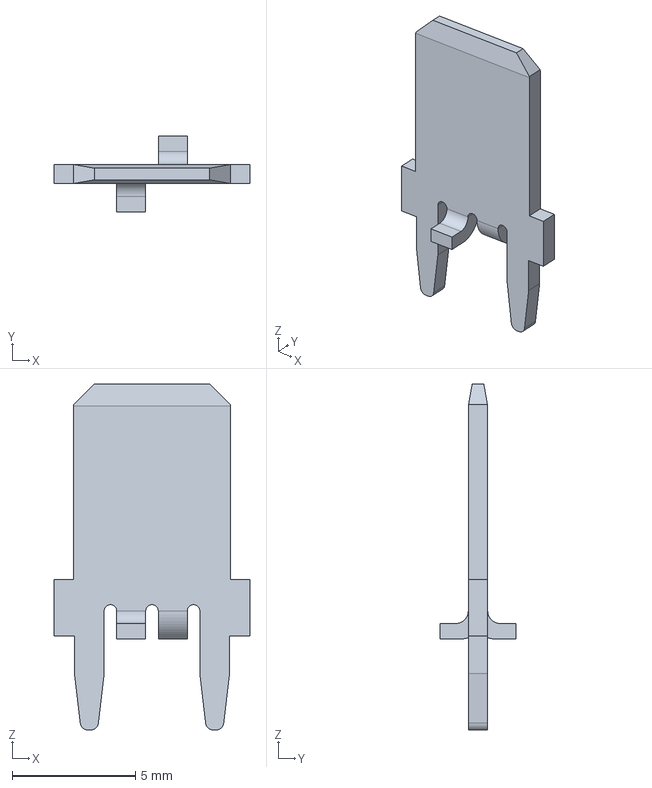
[picture p60: CAD file, 2026-07-11]
PCB/Original/ultraHex-master/ultraHex-master/_restore_backup_2026-07-17T15-32-36-407/3d/c-63862-1-r-3d.stp
7.92 x 3.07 x 14.0 mm
