TDX33029/BTCMinerControl/PCB/Original/ultraHex-master/ultraHex-master/_restore_backup_2026-07-17T15-32-36-407/3d/SN74AXC1T45DBVR.STEP

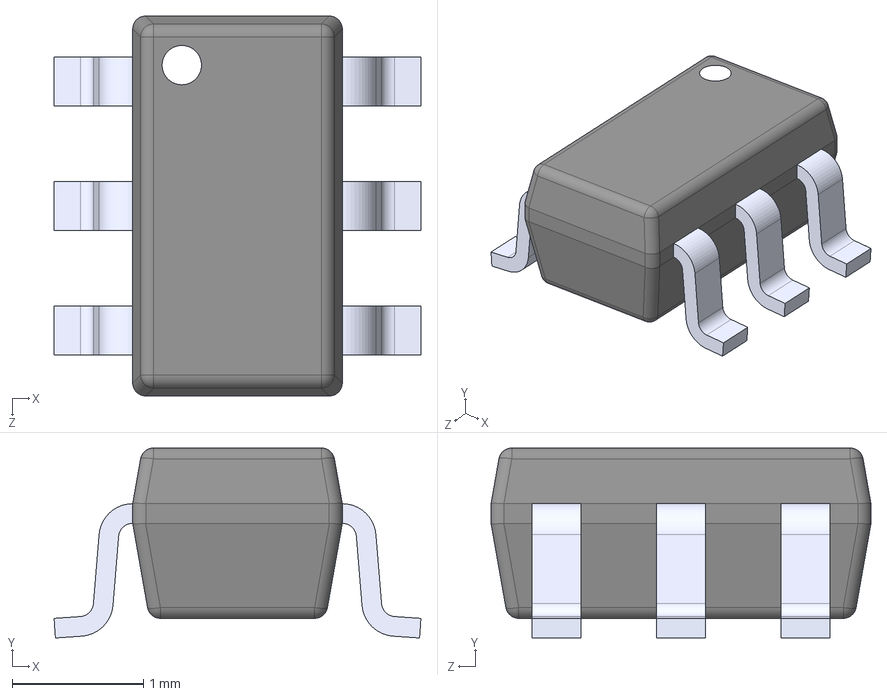
[picture p63: CAD file, 2026-07-11]
PCB/Original/ultraHex-master/ultraHex-master/_restore_backup_2026-07-17T15-32-36-407/3d/SN74AXC1T45DBVR.STEP
2.80 x 1.45 x 2.90 mm
