TDX33029/BTCMinerControl/Miner/BM1397-master/BM1397-master/archived_webpages/BM1397 AD-AF-AG-AH-AI - Antminer 17 Series Chip Replacement Guide - D-Central.pdf

# BM1397 AD/AF/AG/AH/AI – ANTMINER 17 SERIES CHIP REPLACEMENT GUIDE

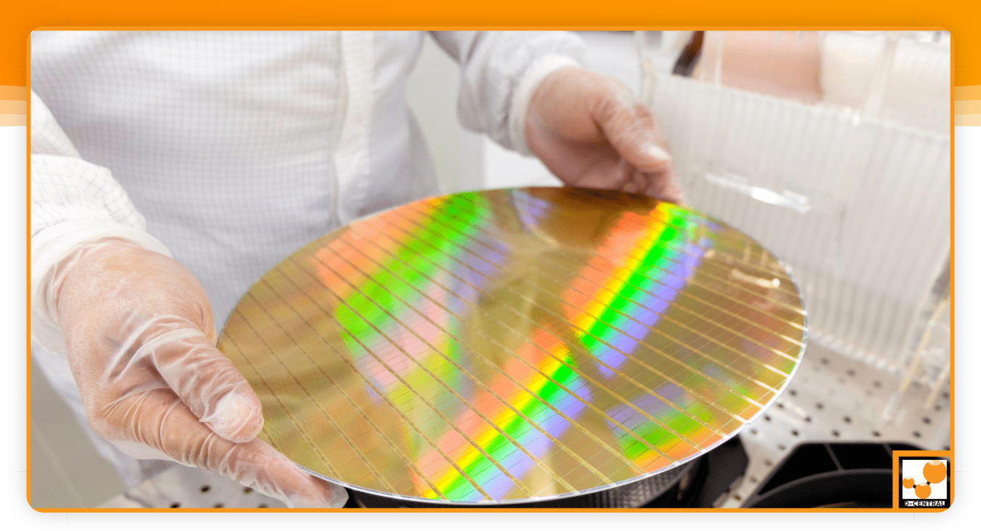
[picture p92: figure]

### Share This Post

ASIC miners have become the leading cryptocurrency mining tools with high hashrates and power consumption ratios. This hardware concentrates many ASIC chips on a printed circuit board. Its name is “Hashboard.” Depending on the model, a hashboard will contain dozens of ASIC chips. They are similar to those of a computer. A mining machine typically has three hashboards (https://d-central.tech/what-is-the-hash-rate-in-bitcoin-and-how-does-it-affect-the-mining-process/) and dozens or hundreds of ASICs. Depending on the miner’s model, the ASIC (https://d-central.tech/gpu-mining-vs-asic-mining%e2%80%8a-%e2%80%8awhats-the-difference/) chip will also be different, and many repairers will doubt which chip model to use. We will take Bitmain’s Antminer 17 series as an example to introduce some issues related to ASIC (https://d-central.tech/identifying-your-asic-miners-issues-and-how-to-fix-them/) chip classification.

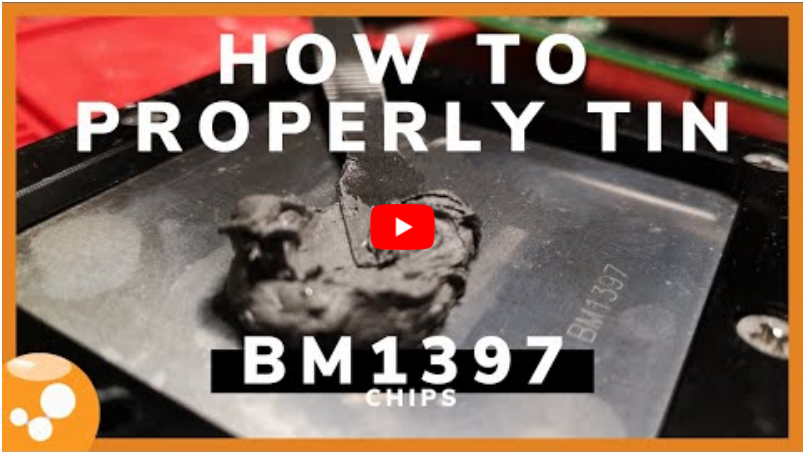
[picture p93: figure]

# Why you need replacement BM1397 chips

As you may know, the chip will generate a lot of heat during its operation. With long-term and uninterrupted operations, the temperature will increase. Excessive temperature will quickly lead to chip failure or damage. This is why Bitmain opted for tin between heatsinks and chips in the Antminer 17 series. (https://d-central.tech/antminer-17-series/) However, this has brought a new set of drawbacks that weigh heavily on balance. In particular, the temperature differential of your cooling and the chip causes crumbling in the tin, which will create the formation of small balls of tin that will get lodged in the legs of your chips to turn into shorts and potentially do permanent damage.

When people order spare parts, they may not correctly distinguish the corresponding ASIC chip models, and the inventory of some models is already minimal. You may have noticed that a sticker on the back of your hashboards will tell you which BM1397 chip model is being used. Indeed, several models have been designed, which can be somewhat confusing. However, the market can be out of stock for a given model at anytime. Therefore, sometimes we have to use other ASIC revisions instead of the one currently used on the hashboard you are looking to fix. Here is a comparison made by the D-Central team to help you better understand which chips can meet your repair needs.

# How to choose your BM1397 chips

After testing and verifying thousands of hashboards, we have found that different types of ASIC (https://d-central.tech/main-differences-between-asic-and-gpu-mining/) chips can replace the original chips of your hashboard. For example, the Antminer T17, (https://d-central.tech/mining-repairs/antminer-t17-repair/) S17 and S17 Pro can share all four kinds of ASIC BM1397 chips. Next, we tested the Antminer T17+ (https://d-central.tech/mining-repairs/antminer-t17plus-repair/) and S17+ hashboards, respectively. We have found that these hashboards can mix the following two types of ASIC chips: BM1397AG (https://d-central.tech/product/bm1397ag/) and BM1397AI. (https://d-central.tech/product/bm1397ai/) This is very useful when the ASIC chips of a specific model are out of stock! But what about the explanations behind each ASIC chip?

BM1397AD

This type of chip is the original model of Bitmain’s BM1397 design. It is strictly found on the Antminer T17, Antminer S17 (https://d-central.tech/minehodl-case-study-1-antminer-s17/) and Antminer S17 Pro. The first cards with this type of chip won’t mention the chip type, so if you can’t see the information on your hashboard, this is probably one of the very first BM1397AD!

Buy new BM1397AD chips here!

Buy recycled BM1397AD chips here! (https://d-central.tech/product/bm1397-recycled-chips/)

BM1397AG

The introduction of this revision allows greater resilience at high temperatures. This is what allowed the T17+ and S17+ variants to make their debut. The BM1397AG (https://d-central.tech/product/bm1397ag/) chip is also found on the T17, S17 and S17 Pro models. Since it is located on many hashboards and includes all models, the BM1397AG (https://d-central.tech/product/bm1397ag/) is an asset in an ASIC repairer’s inventory.

Buy BM1397AG chips here! (https://d-central.tech/product/bm1397ag/)

Buy recycled BM1397AG chips here! (https://d-central.tech/product/bm1397-recycled-chips/)

BM1397AH

This review addresses some of the issues encountered with previous revisions on the T17, S17, and S17 Pro. It is not found on other Antminer 17 series (https://d-central.tech/antminer-19-series/) models. It is unknown what fix this revision made, but BM1397AH (https://d-central.tech/product/bm1397ah/) hashboards tend to have stable hashrate even when the voltage is insufficient.

Buy BM1397AH chips here! (https://d-central.tech/product/bm1397ah/)

Buy recycled BM1397AH chips here! (https://d-central.tech/product/bm1397-recycled-chips/)

BM1397AI

The latest overhaul, the BM1397AI, (https://d-central.tech/product/bm1397ai/) is the ASIC repairer’s ultimate weapon. It fits all 17 series models (except T17e and S17e). The BM1397AI (https://d-central.tech/product/bm1397ai/) is found on the T17, S17, S17 Pro, T17+ and S17+. It stands out for its signal clarity, backward compatibility and significantly increased stability. In addition, we have noticed better performance for hashboards with this type of chip, allowing great flexibility in configurations.

Buy BM1397AI chips here! (https://d-central.tech/product/bm1397ai/)

Buy recycled BM1397AI chips here! (https://d-central.tech/product/bm1397-recycled-chips/)

# What about BIN and hashboard levels?

You will find a sticker on the hashboards that designates the BIN number of the chips installed on this board. The theory goes that you should only use BIN1 chips on a BIN1 hashboard, although our results show you can easily match different BINs for up to 5 chips on a board without issue. BINs are the other stems of BM1397 chips. There are no additional BM1397AD chips produced, for example. They all have the same design, the Y09BM1397310.

What happens, though, is that in the manufacture of chips, there are imperfections and those imperfections at the microscopic level ripple through to a chip’s power, i.e., its efficiency. Some chips of better power can then be configured differently at the software level. The only chips that differ are the different revisions, such as BM1397AG or Y09BM1397610. Then there is also the “level” of the hashboard. Similarly, the level refers to the general stress that the hashboard must be able to withstand. So you can apply a configuration to the chips that won’t put too much strain on the hashboard and its chips in general.

If you recycle chips, try to use hashboards with a similar pattern and level; this is designated by the sticker “L1, L2, …”. We find better results in chip mixing if you use the chips on a compatible or later chip design. For example, you want to install AI, AH or AG chips on an AG hashboard. The logic is AI > AH > AG > AF > AD. We have in this table reproduced all the EEPROMs and the bins corresponding to the manufacturer. This table should give you a complete understanding of the manufacturer’s intended differences between the different BINs and levels. You can also use our VNish firmware (https://d-central.tech/downloads/firmwares/) build to see a full chip map and see the optimized performance of each of your hashboards.

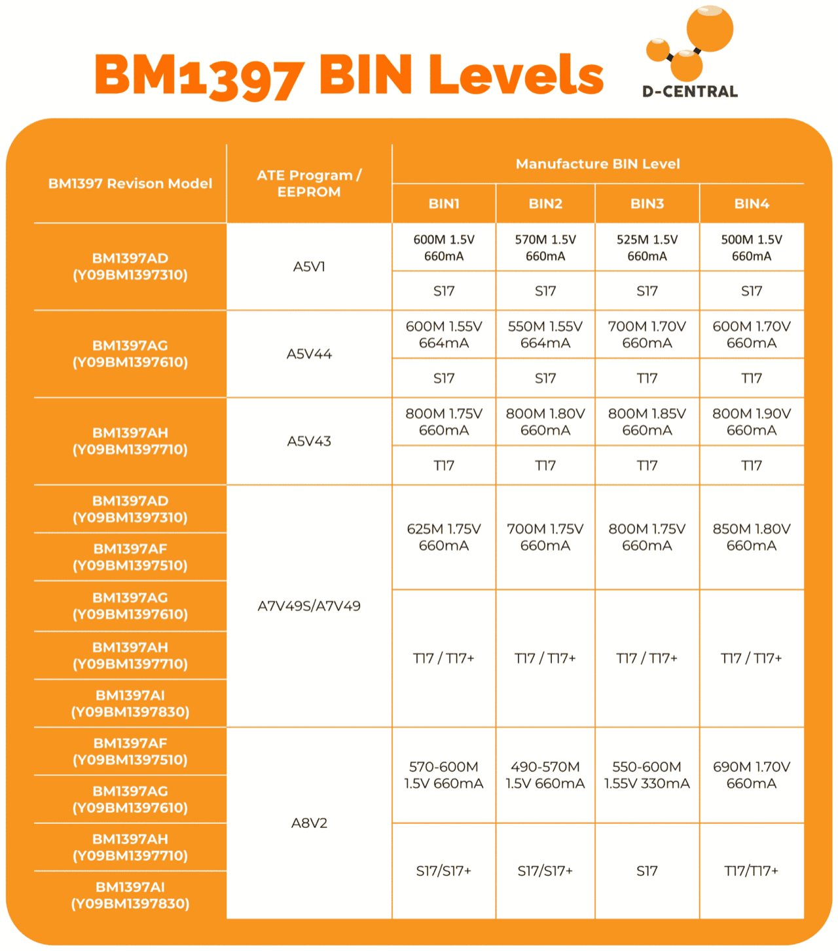
[picture p94: figure]

# You can now fix your 17 Series hashboards

You now have more explicit information than what the manufacturers give us. Our article is based on our experience, having worked on several thousand functional and non-functional hashboards. D-Central Technologies and D-Central Labs are companies operating in the mining world, producing several pieces of research related to Bitcoin mining. (https://d-central.tech/the-new-race-for-bitcoin-mining-hardware/) To continue to see more of our research results, visit our blog (https://d-central.tech/blog/) section and subscribe to the weekly.

PREVIOUS
How long does bitcoin take to send (https://d-central.tech/how-long-does-bitcoin-take-to-send/)

NEXT
Bitcoin is a currency for everyone (https://d-central.tech/bitcoin-is-a-currency-for-everyone/) ! (https://d-central.tech/how-long-does-bitcoin-take-to-send/) | " (https://d-central.tech/bitcoin-is-a-currency-for-everyone/)

## More To Explore

What Bitcoin Mining What Bitcoin Mining Entails Entails (https://d-central.tech/what-bitcoin-mining-entails/)

What rings in your
mind whenever you
hear people talk

Uncategorized

What Is Bitcoin’s What Is Bitcoin’s Decentralized Decentralized Consensus? Consensus? (https://d-central.tech/what-is-bitcoins-decentralized-consensus/)

The world of
cryptocurrency has
grown quickly and the
leader

Uncategorized

Custom Mining Custom Mining Firmware: Antminer Firmware: Antminer Aftermarket Aftermarket
Firmware Overview Firmware Overview (https://d-central.tech/custom-mining-firmware-antminer-aftermarket-firmware-overview/)

While most of the
attention usually goes
to overclocking, a

ASIC Maintenance

## Do You Need Help With Your Bitcoin Business?

We are more than a mining facility; we are your mining partners. Whether you're an amateur or a professional miner, our goal is to make your mining more profitable by offering the latest and most efficient ASIC mining solutions.

Contact Us

4479 Dst. Nord Autoroute
440 W., Laval, QC, H7P 6E2 (https://goo.gl/maps/jWArz8HRPUTpDF8n9)

support@d-central.tech

1-855-753-9997

## GETTING STARTED

Accept Bitcoin (https://d-central.tech/accept-bitcoin/)

Buy/Sell Bitcoin (https://d-central.tech/buy-sell-bitcoin/)

Bitcoin mining (https://d-central.tech/mining/)

Bitcoin privacy (https://d-central.tech/bitcoin-privacy/)

Bitcoin Security (https://d-central.tech/bitcoin-security/)

## MINING SERVICES

Mining Consulting (https://d-central.tech/mining-consulting/)

Mining Hardware (https://d-central.tech/mining-brokerage/)

Mining Hosting (https://d-central.tech/mining-hosting/)

Mining Repairs (https://d-central.tech/mining-repairs/)

Mining Support (https://d-central.tech/mining-support/)

## USEFUL LINKS

Blog (https://d-central.tech/blog/)

Firmwares (https://d-central.tech/downloads/firmwares/)

Manuals (https://d-central.tech/downloads/manuals/)

Shop (https://d-central.tech/shop/)

BullBitcoin.com (https://bullbitcoin.com/signup?referralcode=a87c1d12b909c7a34ea2622a36587a63ebbe4d66b6)

Supported Payment : | Terms (https://d-central.tech/return-and-refund-policy/) Privacy (https://d-central.tech/privacy-policy/) Help (https://support.d-central.tech/support/home)

Copyright © 2022 D-Central

support@d-central.tech | 1-855-753-9997 | Mon - Fri: 8:30 - 17:00 | 4479 Desserte Nord Autoroute 440, Laval, QC H7P 6E2 (https://goo.gl/maps/jWArz8HRPUTpDF8n9) | Discord (https://discord.gg/Zn5y2dkDkh) | Twitter (https://twitter.com/DCentralTech) | Facebook (https://www.facebook.com/DCentralTech) | YouTube (https://www.youtube.com/channel/UCOHwX81mrgVpi41EjYPobiw)
HOME | RESOURCES | SERVICES | HELP | SHOP | FRANÇAIS
