TDX33029/BTCMinerControl/PCB/Original/ultraHex-master/ultraHex-master/_restore_backup_2026-07-17T15-32-36-407/bitaxeHex.kicad_pcb

## KiCad design PCB/Original/ultraHex-master/ultraHex-master/_restore_backup_2026-07-17T15-32-36-407/bitaxeHex.kicad_pcb (2026-07-11)

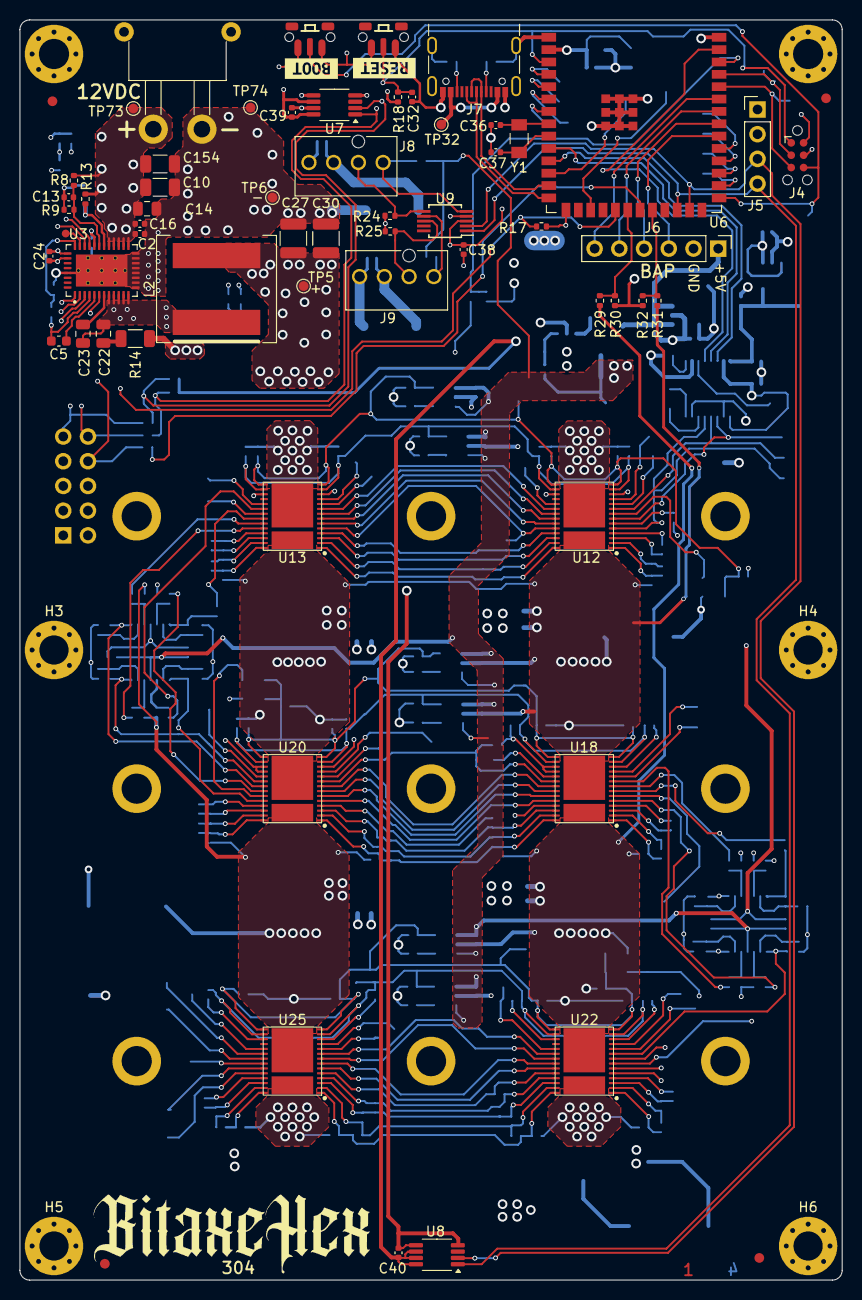
[picture p108: board bitaxeHex.kicad_pcb from above]

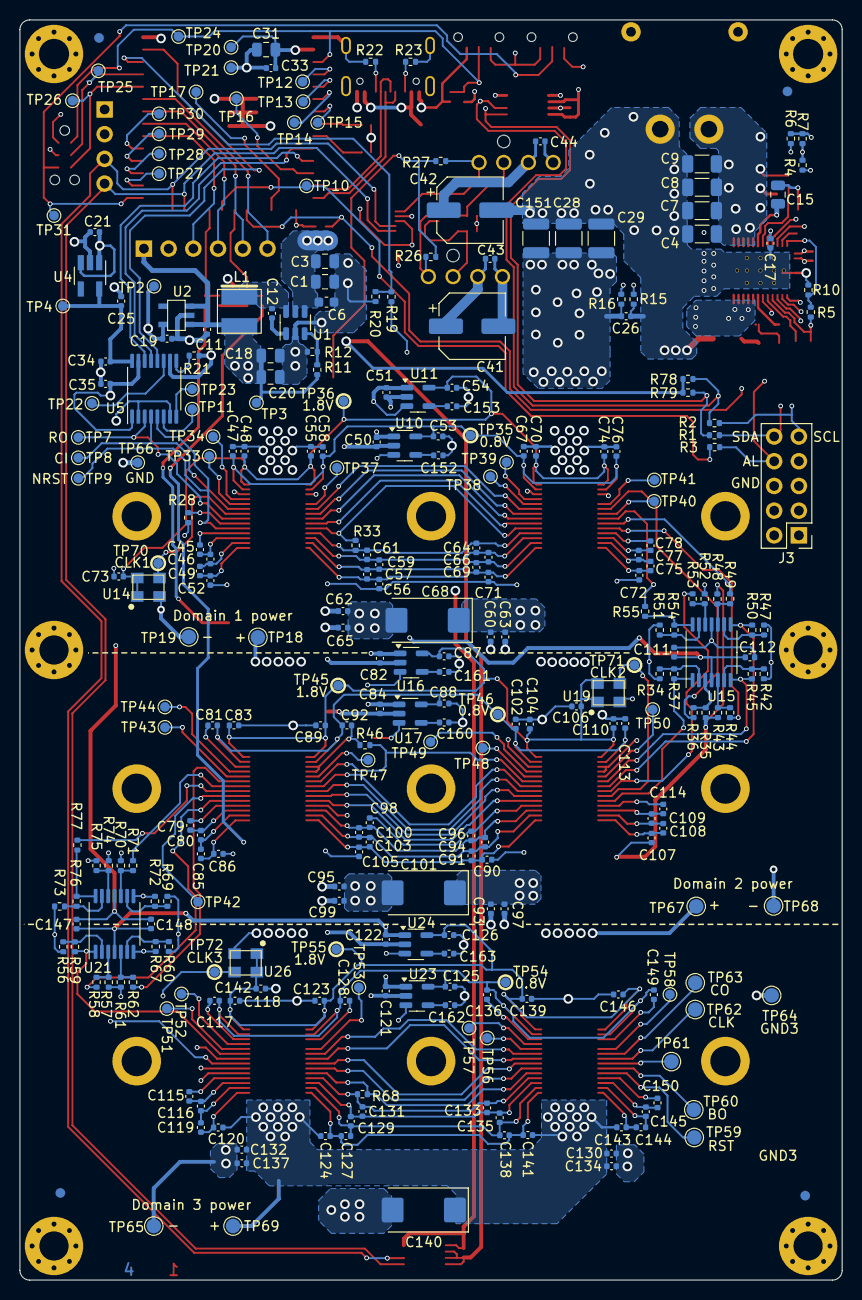
[picture p109: board bitaxeHex.kicad_pcb from below]

Board: 4 copper layers, 84.5 x 129.5 mm, 368 parts (288 on the bottom side), 192 nets.

Parts:
C1, C3, C18, C20, C31: 10uF; C_0805_2012Metric
C2: 4.7nF; C_0402_1005Metric
C4, C7, C8, C10: 22uF; C_1206_3216Metric
C5: 1uF; C_0603_1608Metric
C6: 0.1uF; C_0603_1608Metric
C9, C154: 47uF; C_1206_3216Metric
C11, C19, C21, C25, C32, C45, C46, C47, C48, C49, C52, C53, C54, C55, C56, C57, C58, C59, C61, C63, C64, C65, C66, C67, C69, C70, C71, C72, C74, C75, C76, C77, C78, C79, C80, C81, C83, C85, C86, C87, C88, C89, C90, C91, C92, C94, C96, C97, C98, C99, C100, C102, C103, C104, C105, C107, C108, C109, C110, C112, C113, C114, C115, C116, C117, C118, C119, C120, C123, C124, C125, C126, C127, C128, C129, C131, C133, C134, C135, C136, C137, C138, C139, C141, C143, C144, C145, C146, C148, C149, C150: 1uF; C_0402_1005Metric
C12, C33, C50, C51, C60, C62, C73, C82, C84, C93, C95, C106, C111, C121, C122, C130, C132, C142, C147: 0.1uF; C_0402_1005Metric
C13: 100nF; C_0402_1005Metric
C14, C15: 1uF; C_0805_2012Metric
C16, C26: 2.2nF; C_0402_1005Metric
C17: 4.7uF; C_0402_1005Metric
C22: 1nF; C_0805_2012Metric
C23: 100nF; C_0805_2012Metric
C24: 100pF; C_0402_1005Metric
C27, C28, C29: 47uF; C_1210_3225Metric
C30, C151: 100uF; C_1210_3225Metric
C34, C35, C38, C39, C40, C43, C44: 311-3342-1-ND; C_0402_1005Metric
C36, C37: 6.8pF; C_0402_1005Metric
C41, C42: 220uF; CP_Elec_6.3x7.7
C68, C101, C140: 330uF; CP_EIA-7343-31_Kemet-D_Pad2.25x2.55mm_HandSolder
C152, C153, C160, C161, C162, C163: 0.01uF; C_0402_1005Metric
FID1, FID2, FID3, FID4, FID5, FID6, FID7, FID8: Fiducial; Fiducial_1mm_Mask2mm
H1, H2, H3, H4, H5, H6: MountingHole; MountingHole_3mm_Pad_Via
H7, H8, H9, H10, H11, H12, H13, H14, H15: HeatsinkMountingHole; 3.1mm_mounting
HS1: Heatsink; hex-heatsink
J1: XT30; XT30PW-M
J3: Conn_02x05_Odd_Even; PinHeader_2x05_P2.54mm_Vertical
J4: TC2030-IDC; Tag-Connect_TC2030-IDC-NL_2x03_P1.27mm_Vertical
J5: Conn_01x04; PinHeader_1x04_P2.54mm_Vertical
J6: Conn_01x06; PinHeader_1x06_P2.54mm_Vertical
J7: USB_C_Receptacle_USB2.0; USB_C_Receptacle_GCT_USB4105-xx-A_16P_TopMnt_Horizontal
J8, J9: Conn_01x04; 470531000
L1: 8.2 uH; 74438357082
L2: 680nH; L_Coilcraft_XAL1010-XXX
R1, R2, R3: 0R; R_0402_1005Metric
R4, R5: 17.8K; R_0402_1005Metric
R6, R17, R18, R26, R27, R28, R35, R36, R43, R44, R48, R49, R52, R53, R57, R58, R61, R62, R70, R71, R74, R75: 10k; R_0402_1005Metric
R7: 31.6K; R_0402_1005Metric
R8: 12.7K; R_0402_1005Metric
R9, R16: 1.37K; R_0402_1005Metric
R10: 26.1K; R_0402_1005Metric
R11: 115k; R_0402_1005Metric
R12, R20, R30, R32: 22.1k; R_0402_1005Metric
R13: 10R; R_0402_1005Metric
R14: 1R; R_1206_3216Metric
R15: 49.9R; R_0402_1005Metric
R19, R29, R31: 7.87k; R_0402_1005Metric
R21: 20k; R_0402_1005Metric
R22, R23, R78, R79: 5.1k; R_0402_1005Metric
R24, R25: 5.6k; R_0402_1005Metric
R33, R46, R68: 2k; R_0402_1005Metric
R34, R37, R42, R45, R47, R50, R51, R54, R55, R56, R59, R60, R67, R69, R72, R73, R76, R77: 1k; R_0402_1005Metric
SW1, SW2: SWITCH-SPST; TL3340-switch
TP1: TestPoint; TestPoint_Pad_D0.8mm
TP2, TP3, TP4, TP5, TP6, TP7, TP8, TP9, TP10, TP11, TP12, TP13, TP14, TP15, TP16, TP17, TP20, TP21, TP22, TP23, TP24, TP25, TP26, TP27, TP28, TP29, TP30, TP31, TP32, TP33, TP34, TP37, TP38, TP39, TP40, TP41, TP42, TP43, TP44, TP47, TP48, TP49, TP50, TP51, TP52, TP53, TP56, TP57, TP58, TP66, TP73, TP74: TestPoint; TestPoint_Pad_D1.0mm
TP18, TP67, TP69: +; TestPoint_Pad_D1.5mm
TP19, TP65, TP68: -; TestPoint_Pad_D1.5mm
TP35, TP36, TP45, TP46, TP54, TP55, TP70, TP71, TP72: TestPoint; TestPoint_Pad_D1.0mm_highlight
TP59, TP60, TP61, TP62, TP63, TP64: TestPoint; TestPoint_Pad_D1.5mm
U1: LMR54410; SOT-23-6
U2: RT9080-33GJ5
U3: TPS546D24ARVFR; LQFN40-CLIP
U4: MIC5504; SOT-23-5_HandSoldering
U5: SN74AVC4T774; TSSOP-16_4.4x5mm_P0.65mm
U6: ESP32-S3-WROOM-1; ESP32-S3-WROOM-1U
U7, U8: TMP1075; HVSSOP-8_3x3mm_P0.65mm
U9: EMC2302; MSOP-10_3x3mm_P0.5mm
U10, U17, U23: SGM2036-0v8; TSOT-23-5
U11, U16, U24: SGM2036-1v8; TSOT-23-5
U12, U13, U22, U25: BM1366_mode1; BM1366
U14, U19, U26: 25MHz; O 25,0-JO32-B-1V3-1-T1-LF
U15, U21: TLV3544; TSSOP-14_4.4x5mm_P0.65mm
U18, U20: BM1366_mode0; BM1366
Y1: 32.768kHz; SC32S-7PF20PPM
kibuzzard-65356D4E: G***; kibuzzard-65356D4E
kibuzzard-65356D5C: G***; kibuzzard-65356D5C

Connections:
/1V8: C25.1, C34.2, TP4.1, U4.5 (VOUT), U5.16 (VCCA)
/3V3: C19.1, C21.1, C31.1, C33.1, C35.1, C38.1, C39.1, C40.1, J4.2, J5.2, R17.2, R18.1, R24.2, R25.2, R78.2, R79.1, TP2.1, TP20.1, U2.5 (VOUT), U4.1 (VIN), U4.3 (EN), U5.1 (DIR1), U5.15 (VCCB), U6.2 (3V3), U6.15 (GPIO3/TOUCH3/ADC1_CH2*), U7.6 (A1), U7.8 (V+), U8.6 (A1), U8.7 (A0), U8.8 (V+), U9.3 (VDD)
/5V: C11.1, C18.1, C20.1, C50.2, C51.2, C82.2, C84.2, C111.2, C112.2, C121.2, C122.2, C147.2, C148.2, J6.1, L1.2, R11.1, R26.2, R27.2, TP3.1, U2.1 (VIN), U2.3 (EN), U10.1 (VIN), U10.3 (EN), U11.1 (VIN), U11.3 (EN), U15.4 (V+), U16.1 (VIN), U16.3 (EN), U17.1 (VIN), U17.3 (EN), U21.4 (V+), U23.1 (VIN), U23.3 (EN), U24.1 (VIN), U24.3 (EN)
/BM1366-1/0V8: C47.1, C53.1, C58.1, C67.1, C76.1, TP35.1, U10.5 (VOUT), U12.13 (VDDIO_08_0), U12.16 (VDDIO_08_1), U13.13 (VDDIO_08_0), U13.16 (VDDIO_08_1)
/BM1366-1/1V8: C48.1, C54.1, C55.1, C70.1, C73.1, C74.1, TP36.1, U11.5 (VOUT), U12.14 (VDDIO_18_0), U12.15 (VDDIO_18_1), U13.14 (VDDIO_18_0), U13.15 (VDDIO_18_1), U14.1 (EN), U14.4 (VIN)
/BM1366-1/BI1: R28.2, U12.6 (BI)
/BM1366-1/BO: R49.1, U13.23 (BO)
/BM1366-1/CLKI1: TP70.1, U12.8 (CLKI), U14.3 (OUT)
/BM1366-1/CO: R36.1, U13.20 (CO)
/BM1366-1/NRSTO: R44.1, U13.24 (NRSTO)
/BM1366-1/RI: R55.1, U13.22 (RI)
/BM1366-2/0V8: C81.1, C88.1, C92.1, C102.1, C113.1, TP46.1, U17.5 (VOUT), U18.13 (VDDIO_08_0), U18.16 (VDDIO_08_1), U20.13 (VDDIO_08_0), U20.16 (VDDIO_08_1)
/BM1366-2/1V8: C83.1, C87.1, C89.1, C104.1, C106.1, C110.1, TP45.1, U16.5 (VOUT), U18.14 (VDDIO_18_0), U18.15 (VDDIO_18_1), U19.1 (EN), U19.4 (VIN), U20.14 (VDDIO_18_0), U20.15 (VDDIO_18_1)
/BM1366-2/BI2: R50.1, U15.8, U20.21 (BI)
/BM1366-2/BO: R71.1, U18.8 (BO)
/BM1366-2/CI2: R37.1, U15.1, U20.24 (CI)
/BM1366-2/CLKI2: TP71.1, U19.3 (OUT), U20.23 (CLKI)
/BM1366-2/CO: R58.1, U18.5 (CO)
/BM1366-2/NRSTI2: R45.1, U15.7, U20.20 (NRSTI)
/BM1366-2/NRSTO: R62.1, U18.9 (NRSTO)
/BM1366-2/RI: R77.1, U18.7 (RI)
/BM1366-2/RO2: R53.1, U20.22 (RO)
/BM1366-3/0V8: C117.1, C125.1, C128.1, C136.1, C149.1, TP54.1, U22.13 (VDDIO_08_0), U22.16 (VDDIO_08_1), U23.5 (VOUT), U25.13 (VDDIO_08_0), U25.16 (VDDIO_08_1)
/BM1366-3/1V8: C118.1, C123.1, C126.1, C139.1, C142.1, C146.1, TP55.1, U22.14 (VDDIO_18_0), U22.15 (VDDIO_18_1), U24.5 (VOUT), U25.14 (VDDIO_18_0), U25.15 (VDDIO_18_1), U26.1 (EN), U26.4 (VIN)
/BM1366-3/BI3: R72.1, U21.8, U22.6 (BI)
/BM1366-3/BO3: TP60.1, U25.23 (BO)
/BM1366-3/CI3: R59.1, U21.1, U22.9 (CI)
/BM1366-3/CLKI3: TP72.1, U22.8 (CLKI), U26.3 (OUT)
/BM1366-3/CLKO3: TP62.1, U25.21 (CLKO)
/BM1366-3/CO3: TP63.1, U25.20 (CO)
/BM1366-3/NRSTI3: R67.1, U21.7, U22.5 (NRSTI)
/BM1366-3/NRSTO3: TP59.1, U25.24 (NRSTO)
/BM1366-3/RI3: TP61.1, U25.22 (RI)
/BM1366-3/RO3: R75.1, U22.7 (RO)
/CI: TP8.1, U5.4 (A2), U12.9 (CI)
/ESP32/ASIC_RST: U5.12 (B3), U6.39 (GPIO1/TOUCH1/ADC1_CH0)
/ESP32/EN: C32.1, J4.1, R18.2, SW1.2, TP24.1, U6.3 (EN)
/ESP32/ESP32_RX: U5.14 (B1), U6.11 (GPIO18/U1RXD/ADC2_CH7/CLK_OUT3)
/ESP32/ESP32_TX: U5.13 (B2), U6.10 (GPIO17/U1TXD/ADC2_CH6)
/ESP32/IO0: J4.6, SW2.2, TP31.1, U6.27 (GPIO0/BOOT*)
/ESP32/P_RX: J4.5, TP26.1, U6.36 (U0RXD/GPIO44/CLK_OUT2)
/ESP32/P_TX: J4.3, TP25.1, U6.37 (U0TXD/GPIO43/CLK_OUT1)
/ESP32/VDD1_SAMPLE: R31.1, R32.2, U6.22 (GPIO14/TOUCH14/ADC2_CH3/FSPIWP/FSPIDQS/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)
/ESP32/VDD2_SAMPLE: R29.1, R30.2, U6.20 (GPIO12/TOUCH12/ADC2_CH1/FSPICLK/FSPIIO6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)
/ESP32/VDD3_SAMPLE: R19.1, R20.2, U6.38 (GPIO2/TOUCH2/ADC1_CH1)
/ESP32/XIN32: C36.1, U6.8 (GPIO15/U0RTS/ADC2_CH4/XTAL_32K_P), Y1.1
/ESP32/XOUT32: C37.1, U6.9 (GPIO16/U0CTS/ADC2_CH5/XTAL_32K_NH5), Y1.2
/Fan/FAN1_PWM: J8.4, R27.1, U9.5 (PWM1)
/Fan/FAN1_TACH: J8.3, R24.1, U9.6 (TACH1)
/Fan/FAN2_PWM: J9.4, R26.1, U9.7 (PWM2)
/Fan/FAN2_TACH: J9.3, R25.1, U9.8 (TACH2)
/NRSTI: TP9.1, U5.5 (A3), U12.5 (NRSTI)
/Power/AGND: C13.2, C15.1, R6.1, R7.2, R9.2, R10.2, U3.37 (AGND)
/Power/PGOOD: R17.1, U3.1 (PGD), U6.19 (GPIO11/TOUCH11/ADC2_CH0/FSPID/FSPIIO5/S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)
/Power/PMB_ALRT: J3.8, R3.2, U3.6 (SMB_ALRT)
/Power/PMB_SCL: J3.9, R2.2, U3.3 (PMB_CLK)
/Power/PMB_SDA: J3.10, R1.2, U3.2 (PMB_DATA)
/Power/SW: C22.1, C23.2, L2.1, U3.8 (SW), U3.9 (SW), U3.10 (SW), U3.11 (SW), U3.12 (SW)
/RO: TP7.1, U5.3 (A1), U12.7 (RO)
/SCL: J5.3, R2.1, R78.1, U6.25 (GPIO48/SPICLK_N/SUBSPICLK_N_DIFF), U7.2 (SCL), U8.2 (SCL), U9.2 (SMCLK)
/SDA: J5.4, R1.1, R79.2, U6.24 (GPIO47/SPICLK_P/SUBSPICLK_P_DIFF), U7.1 (SDA), U8.1 (SDA), U9.1 (SMDATA)
/SMB_ALRT: R3.1, TP10.1, U6.21 (GPIO13/TOUCH13/ADC2_CH2/FSPIQ/FSPIIO7/S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)
/VDD: C26.1, C27.1, C28.1, C29.1, C30.1, C120.2, C124.1, C130.2, C132.2, C134.1, C137.1, C140.1, C141.2, C143.1, C151.1, L2.2, R16.1, R19.2, R57.1, R61.1, R70.1, TP5.1, TP69.1, U22.29 (VDD), U25.29 (VDD)
/VDD1: C52.2, C56.1, C60.2, C62.2, C63.1, C65.1, C68.1, C71.2, C72.1, C79.1, C81.2, C82.1, C83.2, C84.1, C87.2, C88.2, C89.2, C92.2, C93.1, C95.1, C96.2, C97.2, C98.1, C99.2, C101.2, C102.2, C104.2, C106.2, C110.2, C113.2, C114.2, C160.2, C161.2, R31.2, R34.2, R42.2, R46.1, R47.2, R51.2, R74.1, TP18.1, TP68.1, U12.29 (VDD), U13.29 (VDD), U16.2 (GND), U17.2 (GND), U18.4 (VSS), U18.12 (PLL_VSS), U18.17 (VSS), U18.18 (PIN_MODE), U18.25 (VSS), U18.30 (VSS), U19.2 (GND), U20.4 (VSS), U20.12 (PLL_VSS), U20.17 (VSS), U20.18 (PIN_MODE), U20.25 (VSS), U20.30 (VSS)
/VDD2: C86.2, C90.1, C93.2, C95.2, C97.1, C99.1, C101.1, C105.2, C107.1, C115.1, C117.2, C118.2, C121.1, C122.1, C123.2, C125.2, C126.2, C128.2, C130.1, C131.2, C132.1, C133.1, C134.2, C136.2, C137.2, C139.2, C140.2, C142.2, C146.2, C149.2, C150.2, C162.2, C163.2, R29.2, R35.2, R43.1, R48.1, R56.2, R60.2, R68.1, R69.2, R73.2, TP64.1, TP65.1, TP67.1, U18.29 (VDD), U20.29 (VDD), U22.4 (VSS), U22.12 (PLL_VSS), U22.17 (VSS), U22.25 (VSS), U22.30 (VSS), U23.2 (GND), U24.2 (GND), U25.4 (VSS), U25.12 (PLL_VSS), U25.17 (VSS), U25.25 (VSS), U25.30 (VSS), U26.2 (GND)
/VIN: C1.1, C2.1, C3.1, C4.1, C6.2, C7.1, C8.1, C9.1, C10.1, C14.1, C16.1, C41.1, C42.1, C43.1, C44.1, C154.1, J1.1 (+V), J8.2, J9.2, R8.1, R13.1, TP73.1, U1.4 (EN), U1.5 (VIN), U3.21 (PVIN), U3.22 (PVIN), U3.23 (PVIN), U3.24 (PVIN), U3.25 (PVIN)
GND: C1.2, C2.2, C3.2, C4.2, C6.1, C7.2, C8.2, C9.2, C10.2, C11.2, C14.2, C16.2, C17.2, C18.2, C19.2, C20.2, C21.2, C25.2, C26.2, C27.2, C28.2, C29.2, C30.2, C31.2, C32.2, C33.2, C34.1, C35.2, C36.2, C37.2, C38.2, C39.2, C40.2, C41.2, C42.2, C43.2, C44.2, C45.1, C47.2, C48.2, C50.1, C51.1, C53.2, C54.2, C55.2, C58.2, C60.1, C61.2, C62.1, C63.2, C64.1, C65.2, C67.2, C68.2, C70.2, C73.2, C74.2, C76.2, C78.2, C111.1, C112.1, C147.1, C148.1, C151.2, C152.2, C153.2, C154.2, H1.1, H2.1, J1.2 (GND), J3.6, J4.4, J5.1, J6.2, J7.A1 (GND), J7.A12 (GND), J7.B1 (GND), J7.B12 (GND), J7.S1 (SHIELD), J8.1, J9.1, R12.2, R14.2, R15.2, R20.1, R21.1, R22.1, R23.1, R28.1, R30.1, R32.1, R33.1, R52.1, SW1.1, SW2.1, TP6.1, TP19.1, TP21.1, TP66.1, TP74.1, U1.2 (GND), U2.2 (GND), U3.13 (PGND), U3.14 (PGND), U3.15 (PGND), U3.16 (PGND), U3.17 (PGND), U3.18 (PGND), U3.19 (PGND), U3.20 (PGND), U3.41 (PAD), U4.2 (GND), U5.2 (DIR2), U5.7 (DIR3), U5.10 (GND), U6.1 (GND), U6.40 (GND), U6.41 (GND), U7.4 (GND), U7.5 (A2), U7.7 (A0), U8.4 (GND), U8.5 (A2), U9.4 (GND), U10.2 (GND), U11.2 (GND), U12.4 (VSS), U12.12 (PLL_VSS), U12.17 (VSS), U12.25 (VSS), U12.30 (VSS), U13.4 (VSS), U13.12 (PLL_VSS), U13.17 (VSS), U13.25 (VSS), U13.30 (VSS), U14.2 (GND), U15.11 (V-), U21.11 (V-)
unnamed: C22.2, R14.1
unnamed: J6.3, U6.32 (MTCK/GPIO39/CLK_OUT3/SUBSPICS1)
unnamed: J6.4, U6.33 (MTDO/GPIO40/CLK_OUT2)
unnamed: J6.5, U6.34 (MTDI/GPIO41/CLK_OUT1)
unnamed: J6.6, U6.35 (MTMS/GPIO42)
unnamed: J7.A5 (CC1), R22.2
unnamed: J7.B5 (CC2), R23.2
unnamed: J7.A4 (VBUS), J7.A9 (VBUS), J7.B4 (VBUS), J7.B9 (VBUS), TP32.1
unnamed: R54.1, R55.2, U15.14
unnamed: R76.1, R77.2, U21.14
unnamed: C12.2, U1.1 (CB)
unnamed: R11.2, R12.1, U1.3 (FB)
unnamed: C12.1, L1.1, U1.6 (SW)
unnamed: TP1.1, U3.31 (ADRSEL)
unnamed: C15.2, R13.2, U3.26 (AVIN)
unnamed: C23.1, U3.7 (BOOT)
unnamed: C5.1, R4.1, R5.1, U3.4 (BP1V5)
unnamed: C5.2, U3.5 (DRTN)
unnamed: C13.1, R8.2, R9.1, U3.27 (EN/UVLO)
unnamed: C24.2, R15.1, U3.34 (GOSNS)
unnamed: R5.2, R10.1, U3.32 (MSEL1)
unnamed: R6.2, U3.29 (MSEL2)
unnamed: C17.1, U3.28 (VDD5)
unnamed: C24.1, R16.2, U3.33 (VOSNS)
unnamed: R4.2, R7.1, U3.30 (VSEL)
unnamed: TP11.1, U5.6 (A4)
unnamed: TP22.1, U5.11 (B4)
unnamed: TP23.1, U5.8 (DIR4)
unnamed: R21.2, U5.9 (OE)
unnamed: TP12.1, U6.4 (GPIO4/TOUCH4/ADC1_CH3)
unnamed: TP13.1, U6.5 (GPIO5/TOUCH5/ADC1_CH4)
unnamed: TP14.1, U6.6 (GPIO6/TOUCH6/ADC1_CH5)
unnamed: TP15.1, U6.7 (GPIO7/TOUCH7/ADC1_CH6)
unnamed: TP16.1, U6.12 (GPIO8/TOUCH8/ADC1_CH7/SUBSPICS1)
unnamed: TP17.1, U6.17 (GPIO9/TOUCH9/ADC1_CH8/FSPIHD/SUBSPIHD)
unnamed: J7.A7 (D-), J7.B7 (D-), U6.13 (GPIO19/U1RTS/ADC2_CH8/CLK_OUT2/USB_D-)
unnamed: J7.A6 (D+), J7.B6 (D+), U6.14 (GPIO20/U1CTS/ADC2_CH9/CLK_OUT1/USB_D+)
unnamed: TP30.1, U6.31 (GPIO38/FSPIWP/SUBSPIWP)
unnamed: TP29.1, U6.30 (SPIDQS/GPIO37/FSPIQ/SUBSPIQ)
unnamed: TP27.1, U6.28 (SPIIO6/GPIO35/FSPID/SUBSPID)
unnamed: TP28.1, U6.29 (SPIIO7/GPIO36/FSPICLK/SUBSPICLK)
unnamed: C152.1, U10.4 (BP)
unnamed: C153.1, U11.4 (BP)
unnamed: TP33.1, U12.10 (ADDR0)
unnamed: TP34.1, U12.11 (ADDR1)
unnamed: U12.23 (BO), U13.6 (BI)
unnamed: U12.21 (CLKO), U13.8 (CLKI)
unnamed: U12.20 (CO), U13.9 (CI)
unnamed: TP37.1, U12.19 (INV_CLKO)
unnamed: R33.2, U12.24 (NRSTO), U13.5 (NRSTI)
unnamed: U12.22 (RI), U13.7 (RO)
unnamed: C49.2, C52.1, U12.1 (VDD1_0)
unnamed: C56.2, C57.1, C69.2, C71.1, U12.28 (VDD1_1), U13.1 (VDD1_0)
unnamed: C46.2, C49.1, U12.2 (VDD2_0)
unnamed: C57.2, C59.1, C66.2, C69.1, U12.27 (VDD2_1), U13.2 (VDD2_0)
unnamed: C45.2, C46.1, U12.3 (VDD3_0)
unnamed: C59.2, C61.1, C64.2, C66.1, U12.26 (VDD3_1), U13.3 (VDD3_0)
unnamed: TP38.1, U13.10 (ADDR0)
unnamed: TP39.1, U13.11 (ADDR1)
unnamed: TP40.1, U13.21 (CLKO)
unnamed: TP41.1, U13.19 (INV_CLKO)
unnamed: C72.2, C75.1, U13.28 (VDD1_1)
unnamed: C75.2, C77.1, U13.27 (VDD2_1)
unnamed: C77.2, C78.1, U13.26 (VDD3_1)
unnamed: R35.1, R36.2, U15.3 (+)
unnamed: R34.1, R37.2, U15.2 (-)
unnamed: R43.2, R44.2, U15.5 (+)
unnamed: R42.1, R45.2, U15.6 (-)
unnamed: R48.2, R49.2, U15.10 (+)
unnamed: R47.1, R50.2, U15.9 (-)
unnamed: R52.2, R53.2, U15.12 (+)
unnamed: R51.1, R54.2, U15.13 (-)
unnamed: C161.1, U16.4 (BP)
unnamed: C160.1, U17.4 (BP)
unnamed: TP43.1, U18.10 (ADDR0)
unnamed: TP44.1, U18.11 (ADDR1)
unnamed: U18.21 (BI), U20.8 (BO)
unnamed: U18.24 (CI), U20.5 (CO)
unnamed: U18.23 (CLKI), U20.6 (CLKO)
unnamed: TP42.1, U18.6 (CLKO)
unnamed: TP47.1, U18.19 (INV_CLKO)
unnamed: R46.2, U18.20 (NRSTI), U20.9 (NRSTO)
unnamed: U18.22 (RO), U20.7 (RI)
unnamed: C79.2, C80.1, U18.3 (VDD1_0)
unnamed: C94.2, C96.1, C98.2, C100.1, U18.26 (VDD1_1), U20.3 (VDD1_0)
unnamed: C80.2, C85.1, U18.2 (VDD2_0)
unnamed: C91.2, C94.1, C100.2, C103.1, U18.27 (VDD2_1), U20.2 (VDD2_0)
unnamed: C85.2, C86.1, U18.1 (VDD3_0)
unnamed: C90.2, C91.1, C103.2, C105.1, U18.28 (VDD3_1), U20.1 (VDD3_0)
unnamed: TP48.1, U20.10 (ADDR0)
unnamed: TP49.1, U20.11 (ADDR1)
unnamed: TP50.1, U20.19 (INV_CLKO)
unnamed: C109.2, C114.1, U20.26 (VDD1_1)
unnamed: C108.2, C109.1, U20.27 (VDD2_1)
unnamed: C107.2, C108.1, U20.28 (VDD3_1)
unnamed: R57.2, R58.2, U21.3 (+)
unnamed: R56.1, R59.2, U21.2 (-)
unnamed: R61.2, R62.2, U21.5 (+)
unnamed: R60.1, R67.2, U21.6 (-)
unnamed: R70.2, R71.2, U21.10 (+)
unnamed: R69.1, R72.2, U21.9 (-)
unnamed: R74.2, R75.2, U21.12 (+)
unnamed: R73.1, R76.2, U21.13 (-)
unnamed: TP51.1, U22.10 (ADDR0)
unnamed: TP52.1, U22.11 (ADDR1)
unnamed: U22.23 (BO), U25.6 (BI)
unnamed: U22.21 (CLKO), U25.8 (CLKI)
unnamed: U22.20 (CO), U25.9 (CI)
unnamed: TP53.1, U22.19 (INV_CLKO)
unnamed: R68.2, U22.24 (NRSTO), U25.5 (NRSTI)
unnamed: U22.22 (RI), U25.7 (RO)
unnamed: C119.2, C120.1, U22.1 (VDD1_0)
unnamed: C124.2, C127.1, C138.2, C141.1, U22.28 (VDD1_1), U25.1 (VDD1_0)
unnamed: C116.2, C119.1, U22.2 (VDD2_0)
unnamed: C127.2, C129.1, C135.2, C138.1, U22.27 (VDD2_1), U25.2 (VDD2_0)
unnamed: C115.2, C116.1, U22.3 (VDD3_0)
unnamed: C129.2, C131.1, C133.2, C135.1, U22.26 (VDD3_1), U25.3 (VDD3_0)
unnamed: C162.1, U23.4 (BP)
unnamed: C163.1, U24.4 (BP)
unnamed: TP56.1, U25.10 (ADDR0)
unnamed: TP57.1, U25.11 (ADDR1)
unnamed: TP58.1, U25.19 (INV_CLKO)
unnamed: C143.2, C144.1, U25.28 (VDD1_1)
unnamed: C144.2, C145.1, U25.27 (VDD2_1)
unnamed: C145.2, C150.1, U25.26 (VDD3_1)
