TDX33029/BTCMinerControl/PCB/Original/ultraHex-master/ultraHex-master/_restore_backup_2026-07-17T15-32-36-407/hex-display/hex-display.kicad_pcb

## KiCad design PCB/Original/ultraHex-master/ultraHex-master/_restore_backup_2026-07-17T15-32-36-407/hex-display/hex-display.kicad_pcb (2026-07-11)

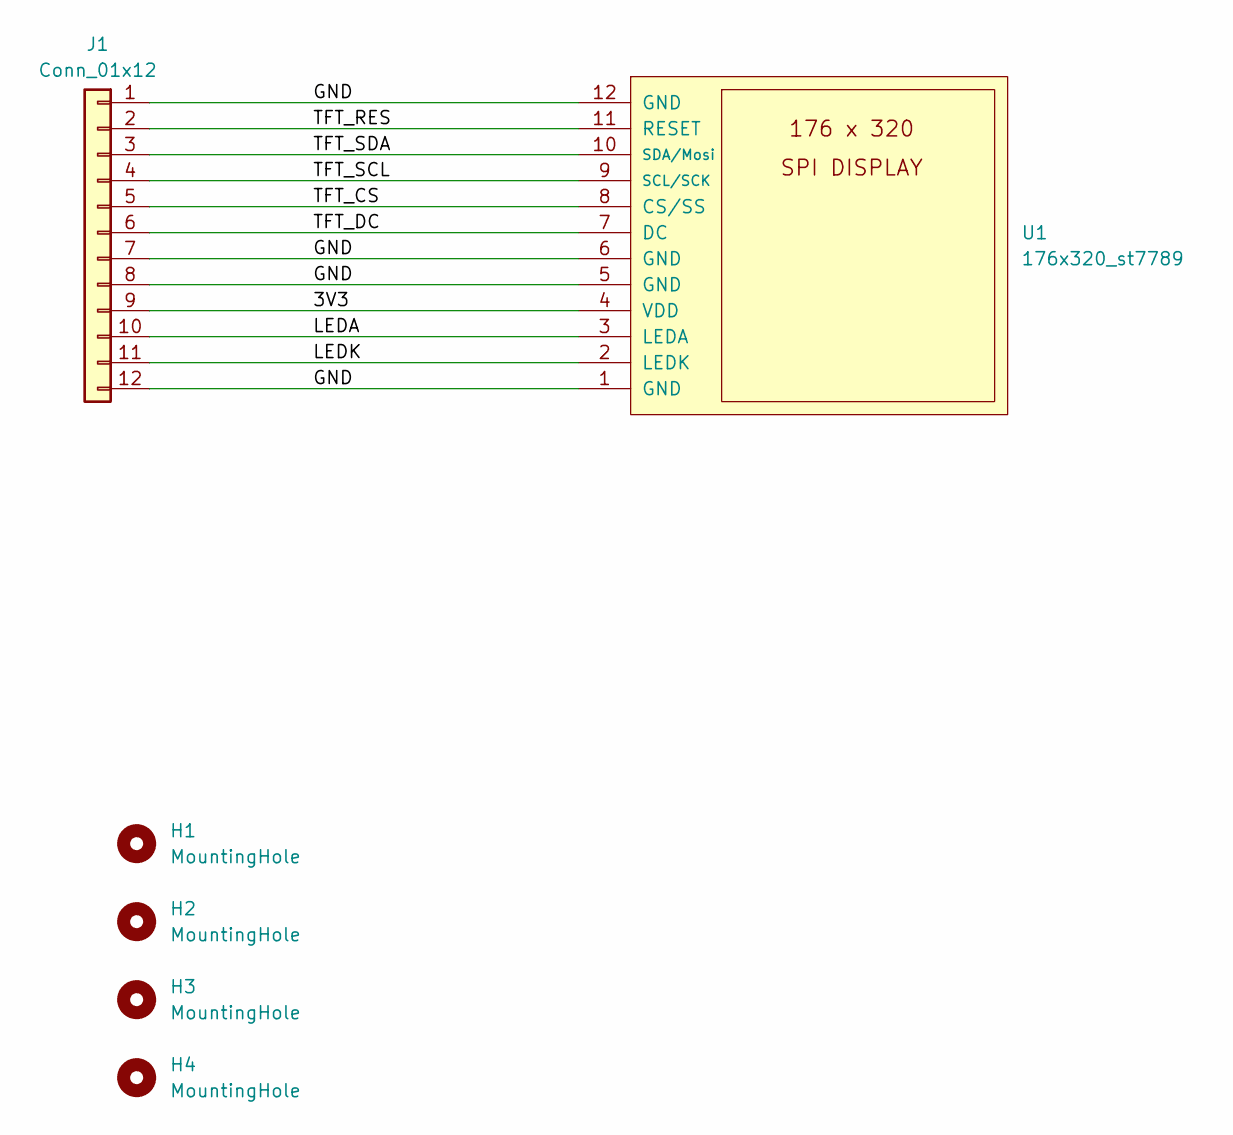
[picture p110: schematic hex-display.kicad_sch]

Parts:
H1, H2, H3, H4: MountingHole; 4mm_mounting
J1: Conn_01x12; JST_GH_BM12B-GHS-TBT_1x12-1MP_P1.25mm_Vertical
U1: 176x320_st7789; ST7789-176x320

Connections:
/3V3: J1.9, U1.4 (VDD)
/GND: J1.1, J1.7, J1.8, J1.12, U1.1 (GND), U1.5 (GND), U1.6 (GND), U1.12 (GND)
/LEDA: J1.10, U1.3 (LEDA)
/LEDK: J1.11, U1.2 (LEDK)
/TFT_CS: J1.5, U1.8 (CS/SS)
/TFT_DC: J1.6, U1.7 (DC)
/TFT_RES: J1.2, U1.11 (RESET)
/TFT_SCL: J1.4, U1.9 (SCL/SCK)
/TFT_SDA: J1.3, U1.10 (SDA/Mosi)

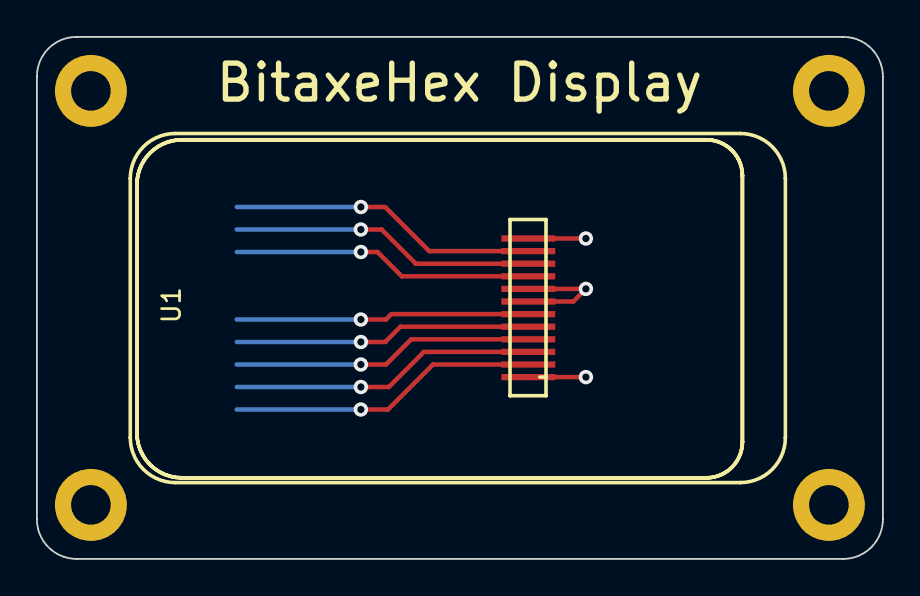
[picture p111: board hex-display.kicad_pcb from above]

Board: 2 copper layers, 47.0 x 29.0 mm, 6 parts (1 on the bottom side), 9 nets.
