TDX33029/BTCMinerControl/PCB/Original/bitaxeUltra-ultra-205/bitaxeUltra-ultra-205/bitaxeUltra.kicad_pcb

## KiCad design PCB/Original/bitaxeUltra-ultra-205/bitaxeUltra-ultra-205/bitaxeUltra.kicad_pcb (2026-07-11)

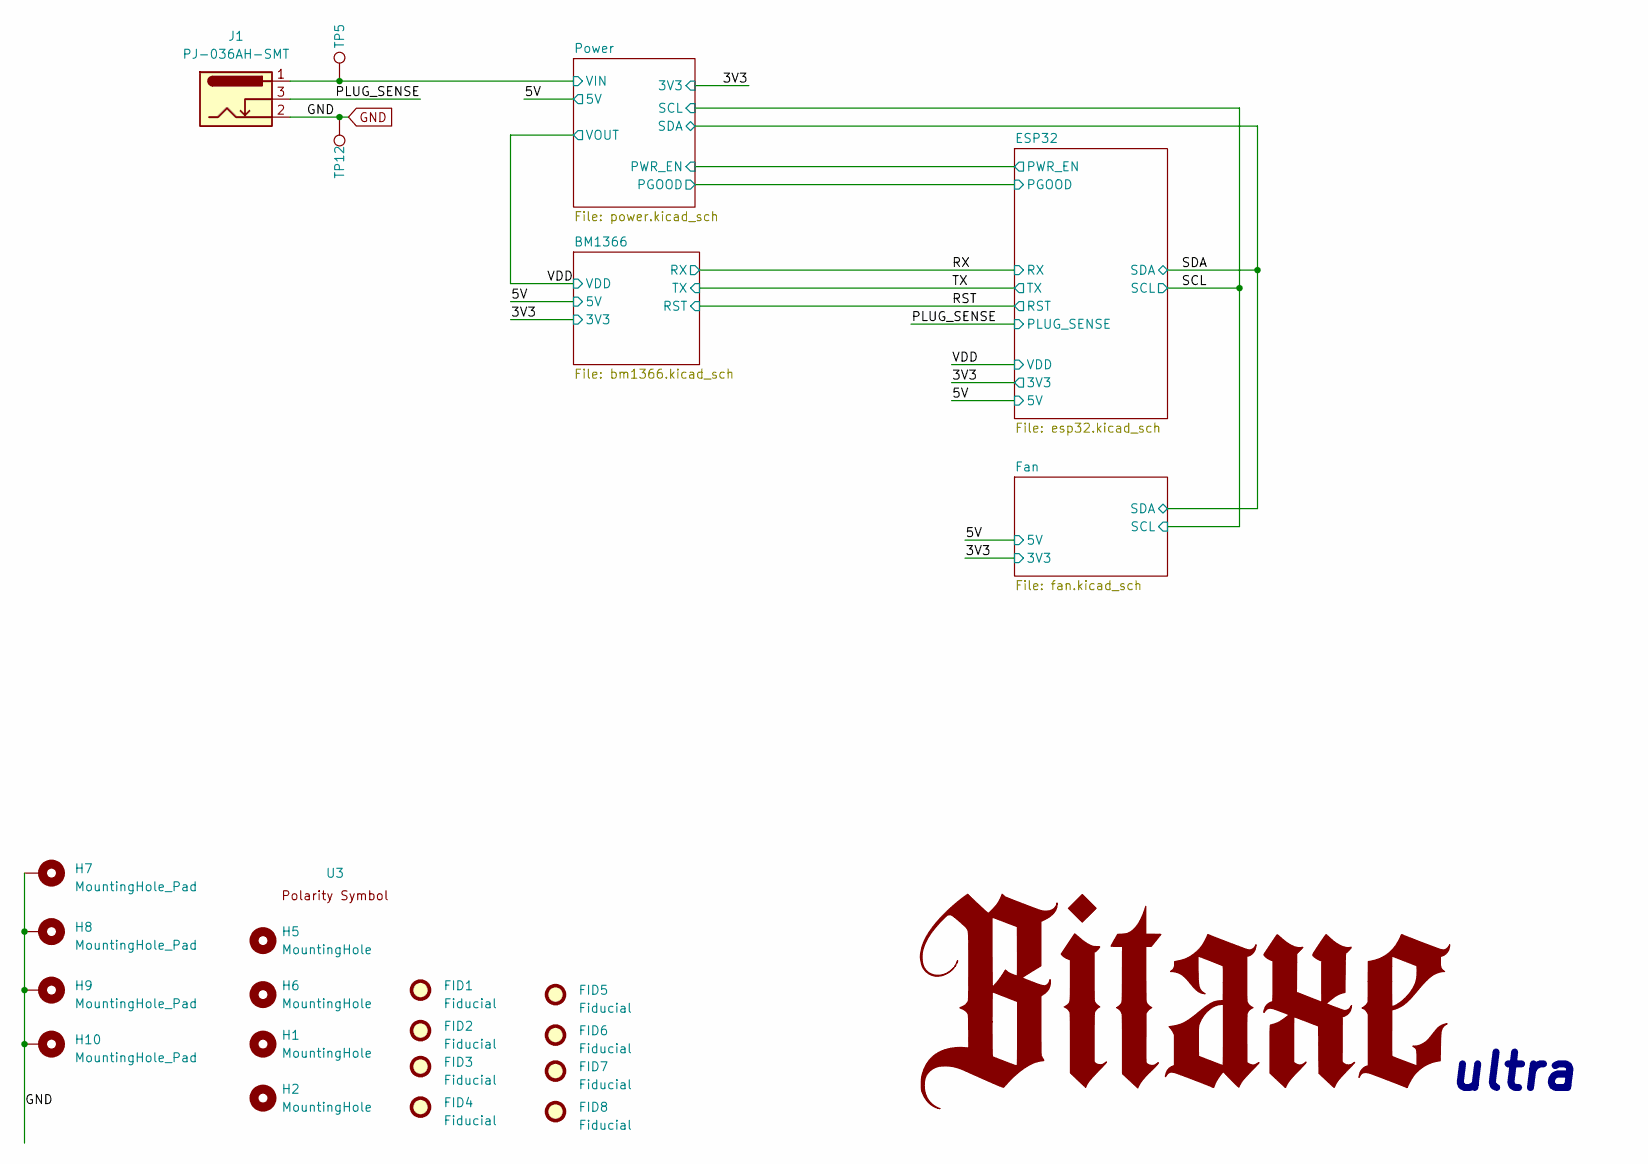
[picture p112: schematic bitaxeUltra.kicad_sch, Bitaxe Ultra]

Parts:
FID1, FID2, FID3, FID4, FID5, FID6, FID7, FID8: Fiducial; Fiducial_1mm_Mask2mm
H1, H2, H5, H6: MountingHole; MountingHole_3.5mm
H7, H8, H9, H10: MountingHole_Pad; MountingHole_3mm_Pad_Via
J1: PJ-036AH-SMT; BarrelJack_CUI_PJ-036AH-SMT_Horizontal; PARTNO PJ-036AH-SMT
TP5, TP12: TestPoint; TestPoint_Pad_D3.0mm
U3: polarity

Connections:
/PLUG_SENSE: J1.3; also elsewhere on the board
/Power/VIN: J1.1, TP5.1; also elsewhere on the board
GND: H7.1, H8.1, H9.1, H10.1, J1.2, TP12.1; also elsewhere on the board

Notes on the sheet:
ultra

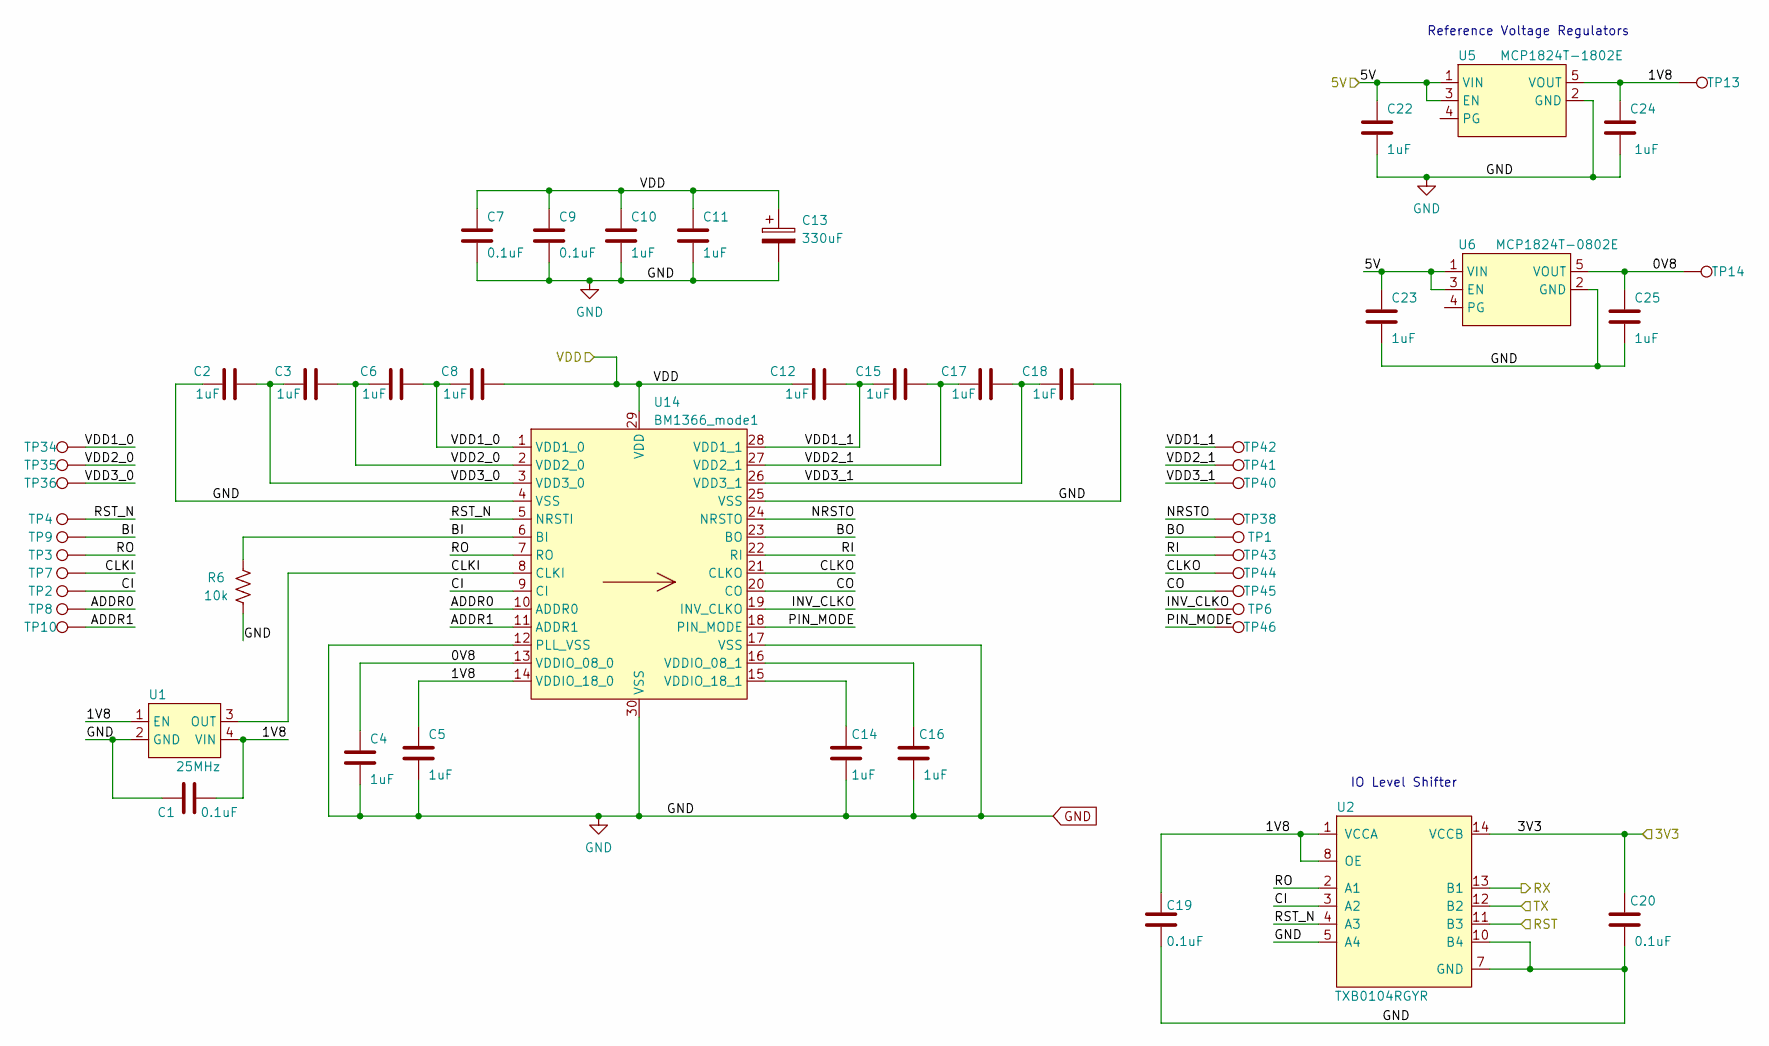
[picture p113: schematic bm1366.kicad_sch, Bitaxe Ultra]

Parts:
C1, C7, C9, C19, C20: 0.1uF; C_0402_1005Metric; PARTNO 0402X104K100CT
C2, C3, C4, C5, C6, C8, C10, C11, C12, C14, C15, C16, C17, C18, C22, C23, C24, C25: 1uF; C_0402_1005Metric; PARTNO EMK105BJ105MV-F
C13: 330uF; CP_EIA-7343-31_Kemet-D_Pad2.25x2.55mm_HandSolder; PARTNO 293D337X9010E2TE3
R6: 10k; R_0402_1005Metric; PARTNO RC0402JR-0710KL
TP1, TP2, TP3, TP4, TP6, TP7, TP8, TP9, TP10, TP13, TP14, TP34, TP35, TP36, TP38, TP40, TP41, TP42, TP43, TP44, TP45, TP46: TestPoint; TestPoint_Pad_D1.5mm
U1: 25MHz; O 25,0-JO32-B-1V3-1-T1-LF; PARTNO O 25,0-JO32-B-1V3-1-T1-LF
U2: TXB0104RGYR; TXB0104; PARTNO TXB0104RGYR
U5: MCP1824T-1802E; SOT-23-5; PARTNO MCP1824T-1802E/OT
U6: MCP1824T-0802E; SOT-23-5; PARTNO MCP1824T-0802E/OT
U14: BM1366_mode1; BM1366

Connections:
/3V3: C20.1, U2.14 (VCCB); also elsewhere on the board
/5V: C22.1, C23.1, U5.1 (VIN), U5.3 (EN), U6.1 (VIN), U6.3 (EN); also elsewhere on the board
/BM1366/0V8: C4.1, C25.1, TP14.1, U6.5 (VOUT), U14.13 (VDDIO_08_0)
/BM1366/1V8: C1.2, C5.1, C19.1, C24.1, TP13.1, U1.1 (EN), U1.4 (VIN), U2.1 (VCCA), U2.8 (OE), U5.5 (VOUT), U14.14 (VDDIO_18_0)
/BM1366/ADDR0: TP8.1, U14.10 (ADDR0)
/BM1366/ADDR1: TP10.1, U14.11 (ADDR1)
/BM1366/BI: R6.2, TP9.1, U14.6 (BI)
/BM1366/BO: TP1.1, U14.23 (BO)
/BM1366/CI: TP2.1, U2.3 (A2), U14.9 (CI)
/BM1366/CLKI: TP7.1, U1.3 (OUT), U14.8 (CLKI)
/BM1366/CLKO: TP44.1, U14.21 (CLKO)
/BM1366/CO: TP45.1, U14.20 (CO)
/BM1366/INV_CLKO: TP6.1, U14.19 (INV_CLKO)
/BM1366/NRSTO: TP38.1, U14.24 (NRSTO)
/BM1366/PIN_MODE: TP46.1, U14.18 (PIN_MODE)
/BM1366/RI: TP43.1, U14.22 (RI)
/BM1366/RO: TP3.1, U2.2 (A1), U14.7 (RO)
/BM1366/RST_N: TP4.1, U2.4 (A3), U14.5 (NRSTI)
/BM1366/VDD1_0: C6.2, C8.1, TP34.1, U14.1 (VDD1_0)
/BM1366/VDD1_1: C12.2, C15.1, TP42.1, U14.28 (VDD1_1)
/BM1366/VDD2_0: C3.2, C6.1, TP35.1, U14.2 (VDD2_0)
/BM1366/VDD2_1: C15.2, C17.1, TP41.1, U14.27 (VDD2_1)
/BM1366/VDD3_0: C2.2, C3.1, TP36.1, U14.3 (VDD3_0)
/BM1366/VDD3_1: C17.2, C18.1, TP40.1, U14.26 (VDD3_1)
/RST: U2.11 (B3); also elsewhere on the board
/RX: U2.13 (B1); also elsewhere on the board
/TX: U2.12 (B2); also elsewhere on the board
/VDD: C7.1, C8.2, C9.1, C10.1, C11.1, C12.1, C13.1, U14.29 (VDD); also elsewhere on the board
GND: C1.1, C2.1, C4.2, C5.2, C7.2, C9.2, C10.2, C11.2, C13.2, C14.2, C16.2, C18.2, C19.2, C20.2, C22.2, C23.2, C24.2, C25.2, R6.1, U1.2 (GND), U2.5 (A4), U2.7 (GND), U2.10 (B4), U2.15 (GND), U2.16 (GND), U2.17 (GND), U2.18 (GND), U2.19 (GND), U5.2 (GND), U6.2 (GND), U14.4 (VSS), U14.12 (PLL_VSS), U14.17 (VSS), U14.25 (VSS), U14.30 (VSS); also elsewhere on the board
unnamed: C16.1, U14.16 (VDDIO_08_1)
unnamed: C14.1, U14.15 (VDDIO_18_1)

Notes on the sheet:
Reference Voltage Regulators
IO Level Shifter

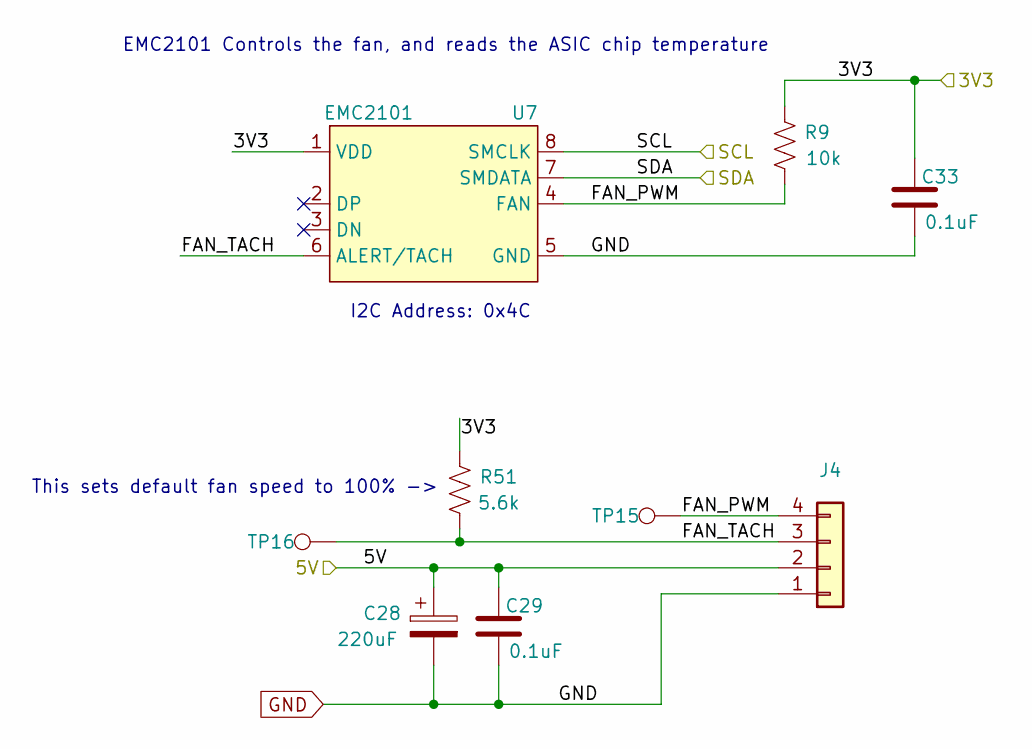
[picture p114: schematic fan.kicad_sch, Bitaxe Ultra]

Parts:
C28: 220uF; CP_Elec_6.3x7.7; PARTNO 865080345012
C29, C33: 0.1uF; C_0402_1005Metric; PARTNO 0402X104K100CT
J4: Conn_01x04; 470531000; PARTNO 0470531000
R9: 10k; R_0402_1005Metric; PARTNO RC0402JR-0710KL
R51: 5.6k; R_0402_1005Metric; PARTNO RC0402FR-135K6L
TP15, TP16: TestPoint; TestPoint_Pad_D1.5mm
U7: EMC2101; TSSOP-8_3x3mm_P0.65mm; PARTNO EMC2101-R-ACZL-TR

Connections:
/3V3: C33.1, R9.2, U7.1 (VDD); also elsewhere on the board
/5V: C28.1, C29.1, J4.2; also elsewhere on the board
/Fan/FAN_PWM: J4.4, R9.1, TP15.1, U7.4 (FAN)
/Fan/FAN_TACH: J4.3, TP16.1, U7.6 (ALERT/TACH); also elsewhere on the board
/SCL: U7.8 (SMCLK); also elsewhere on the board
/SDA: U7.7 (SMDATA); also elsewhere on the board
GND: C28.2, C29.2, C33.2, J4.1, U7.5 (GND); also elsewhere on the board

Notes on the sheet:
EMC2101 Controls the fan, and reads the ASIC chip temperature
This sets default fan speed to 100% ->
I2C Address: 0x4C
