TDX33029/BTCMinerControl/PCB/Original/bitaxeUltra-ultra-205/bitaxeUltra-ultra-205/bitaxeUltra.kicad_pcb

## KiCad design PCB/Original/bitaxeUltra-ultra-205/bitaxeUltra-ultra-205/bitaxeUltra.kicad_pcb (continued)

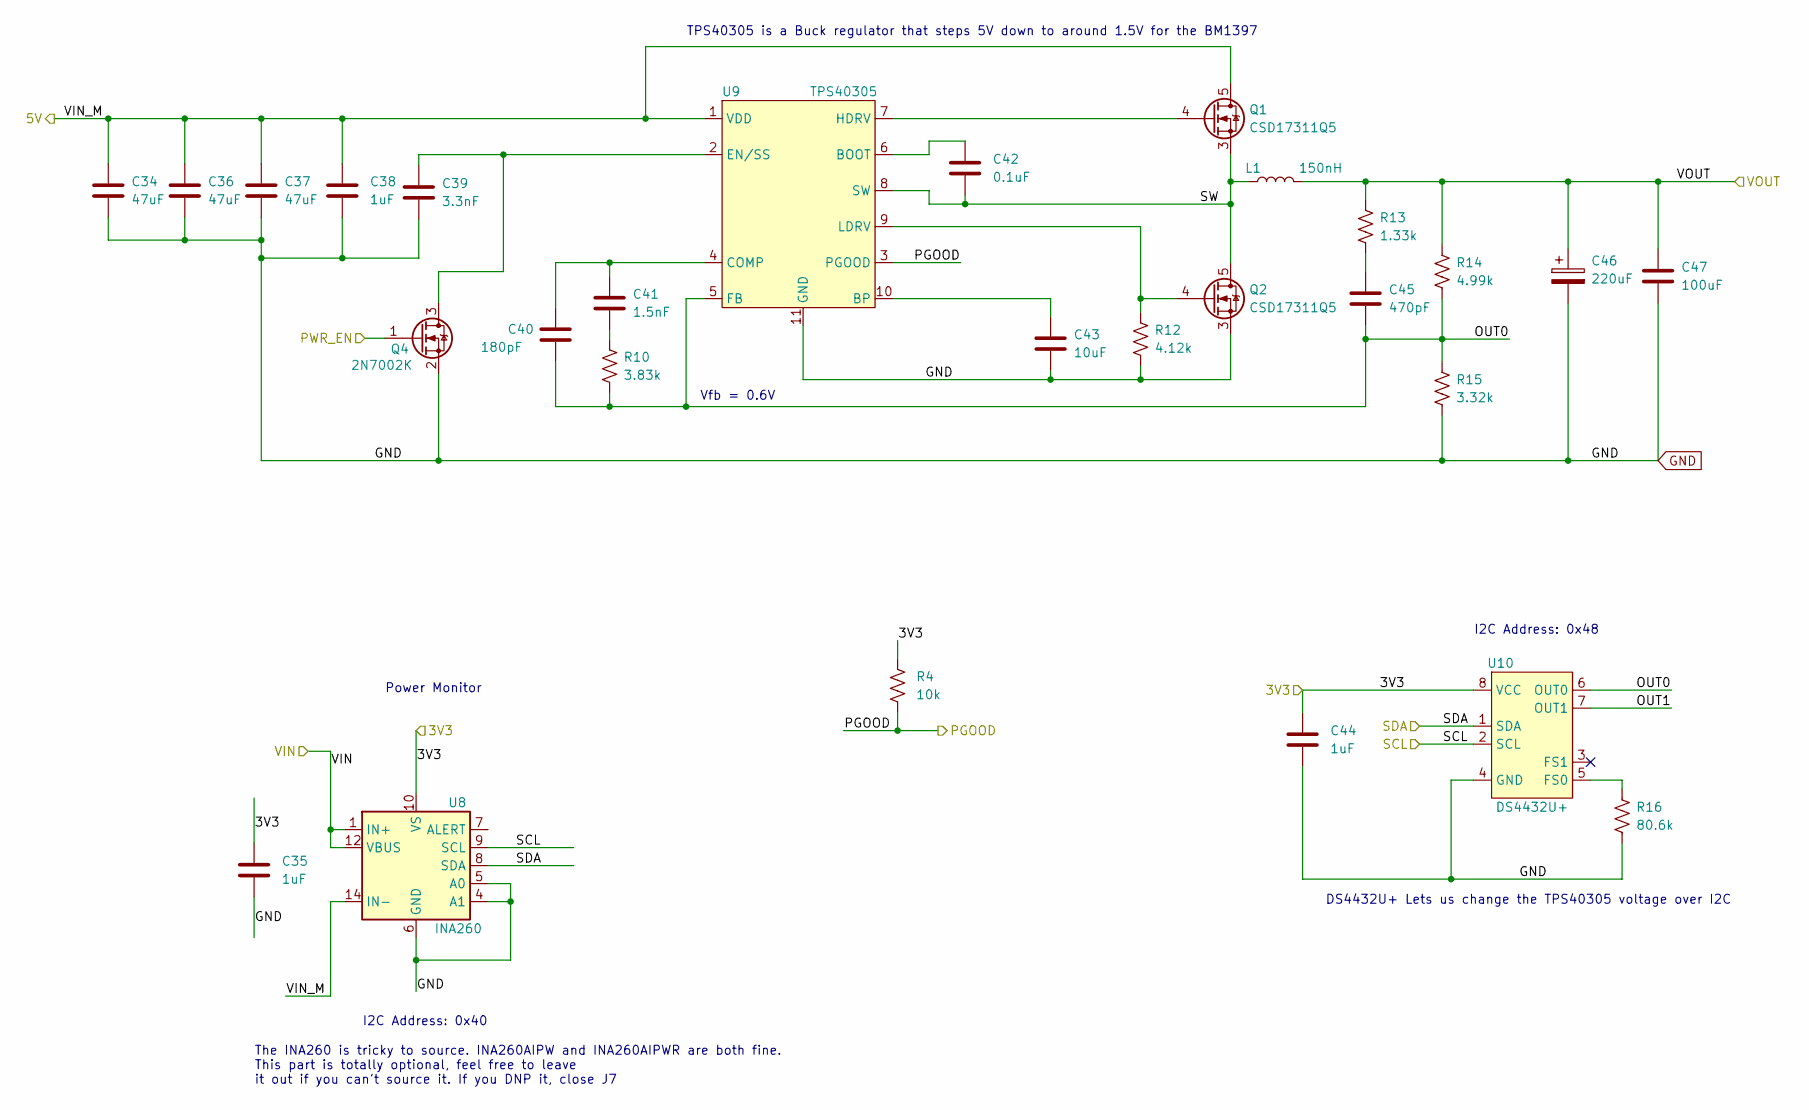
[picture p115: schematic power.kicad_sch, Bitaxe Ultra]

Parts:
C34, C36, C37: 47uF; C_1210_3225Metric; PARTNO GRM32ER61C476KE15L
C35, C44: 1uF; C_0402_1005Metric; PARTNO EMK105BJ105MV-F
C38: 1uF; C_0805_2012Metric; PARTNO CL21B105KOFNNNG
C39: 3.3nF; C_0402_1005Metric; PARTNO CL05B332KB5NNNC
C40: 180pF; C_0805_2012Metric; PARTNO CC0805JRNPO9BN181
C41: 1.5nF; C_0805_2012Metric; PARTNO CC0805KRX7R9BB152
C42: 0.1uF; C_0402_1005Metric; PARTNO 0402X104K100CT
C43: 10uF; C_0805_2012Metric; PARTNO CL21A106KOQNNNE
C45: 470pF; C_0805_2012Metric; PARTNO 0805B471K500CT
C46: 220uF; CAP_2R5TPE220MAFB; PARTNO 2R5TPE220MAFB
C47: 100uF; C_1206_3216Metric; PARTNO C3216X5R0J107M160AB
L1: 150nH; FP1005R1-R15-R; PARTNO FP1005R1-R15-R
Q1, Q2: CSD17311Q5; PARTNO CSD17311Q5
Q4: 2N7002K; SOT-323_SC-70; PARTNO 2N7002KW
R4: 10k; R_0402_1005Metric; PARTNO RC0402JR-0710KL
R10: 3.83k; R_0402_1005Metric; PARTNO RC0402FR-073K83L
R12: 4.12k; R_0402_1005Metric; PARTNO RMCF0402FT4K12
R13: 1.33k; R_0402_1005Metric; PARTNO RC0402FR-071K33L
R14: 4.99k; R_0402_1005Metric; PARTNO RC0402FR-074K99L
R15: 3.32k; R_0402_1005Metric; PARTNO RC0402FR-073K32L
R16: 80.6k; R_0402_1005Metric; PARTNO RC0402FR-0780K6L
U8: INA260; TSSOP-16_4.4x5mm_P0.65mm; PARTNO INA260AIPW
U9: TPS40305; PARTNO TPS40305DRCR
U10: DS4432U+; TSSOP-8_3x3mm_P0.65mm; PARTNO DS4432U+

Connections:
/3V3: C35.1, C44.1, R4.1, U8.10 (VS), U10.8 (VCC); also elsewhere on the board
/5V: C34.1, C36.1, C37.1, C38.1, Q1.5 (D), U8.14 (IN-), U8.15 (IN-), U8.16 (IN-), U9.1 (VDD); also elsewhere on the board
/ESP32/PWR_EN: Q4.1 (G); also elsewhere on the board
/Power/OUT0: C40.2, C45.2, R10.2, R14.2, R15.1, U9.5 (FB), U10.6 (OUT0)
/Power/OUT1: U10.7 (OUT1)
/Power/PGOOD: R4.2, U9.3 (PGOOD); also elsewhere on the board
/Power/SW: C42.2, L1.1, Q1.1, Q1.2, Q1.3 (S), Q2.5 (D), U9.8 (SW)
/Power/VIN: U8.1 (IN+), U8.2 (IN+), U8.3 (IN+), U8.12 (VBUS); also elsewhere on the board
/SCL: U8.9 (SCL), U10.2 (SCL); also elsewhere on the board
/SDA: U8.8 (SDA), U10.1 (SDA); also elsewhere on the board
/VDD: C46.1, C47.1, L1.2, R13.1, R14.1; also elsewhere on the board
GND: C34.2, C35.2, C36.2, C37.2, C38.2, C39.2, C43.2, C44.2, C46.2, C47.2, Q2.1, Q2.2, Q2.3 (S), Q4.2 (S), R12.2, R15.2, R16.2, U8.4 (A1), U8.5 (A0), U8.6 (GND), U8.11 (GND), U9.11 (GND), U10.4 (GND); also elsewhere on the board
unnamed: C41.2, R10.1
unnamed: C45.1, R13.2
unnamed: Q1.4 (G), U9.7 (HDRV)
unnamed: Q2.4 (G), R12.1, U9.9 (LDRV)
unnamed: C39.1, Q4.3 (D), U9.2 (EN/SS)
unnamed: C42.1, U9.6 (BOOT)
unnamed: C43.1, U9.10 (BP)
unnamed: C40.1, C41.1, U9.4 (COMP)
unnamed: R16.1, U10.5 (FS0)

Notes on the sheet:
DS4432U+ Lets us change the TPS40305 voltage over I2C
I2C Address: 0x48
The INA260 is tricky to source. INA260AIPW and INA260AIPWR are both fine. This part is totally optional, feel free to leave it out if you can't source it. If you DNP it, close J7
Power Monitor
TPS40305 is a Buck regulator that steps 5V down to around 1.5V for the BM1397
I2C Address: 0x40
Vfb = 0.6V

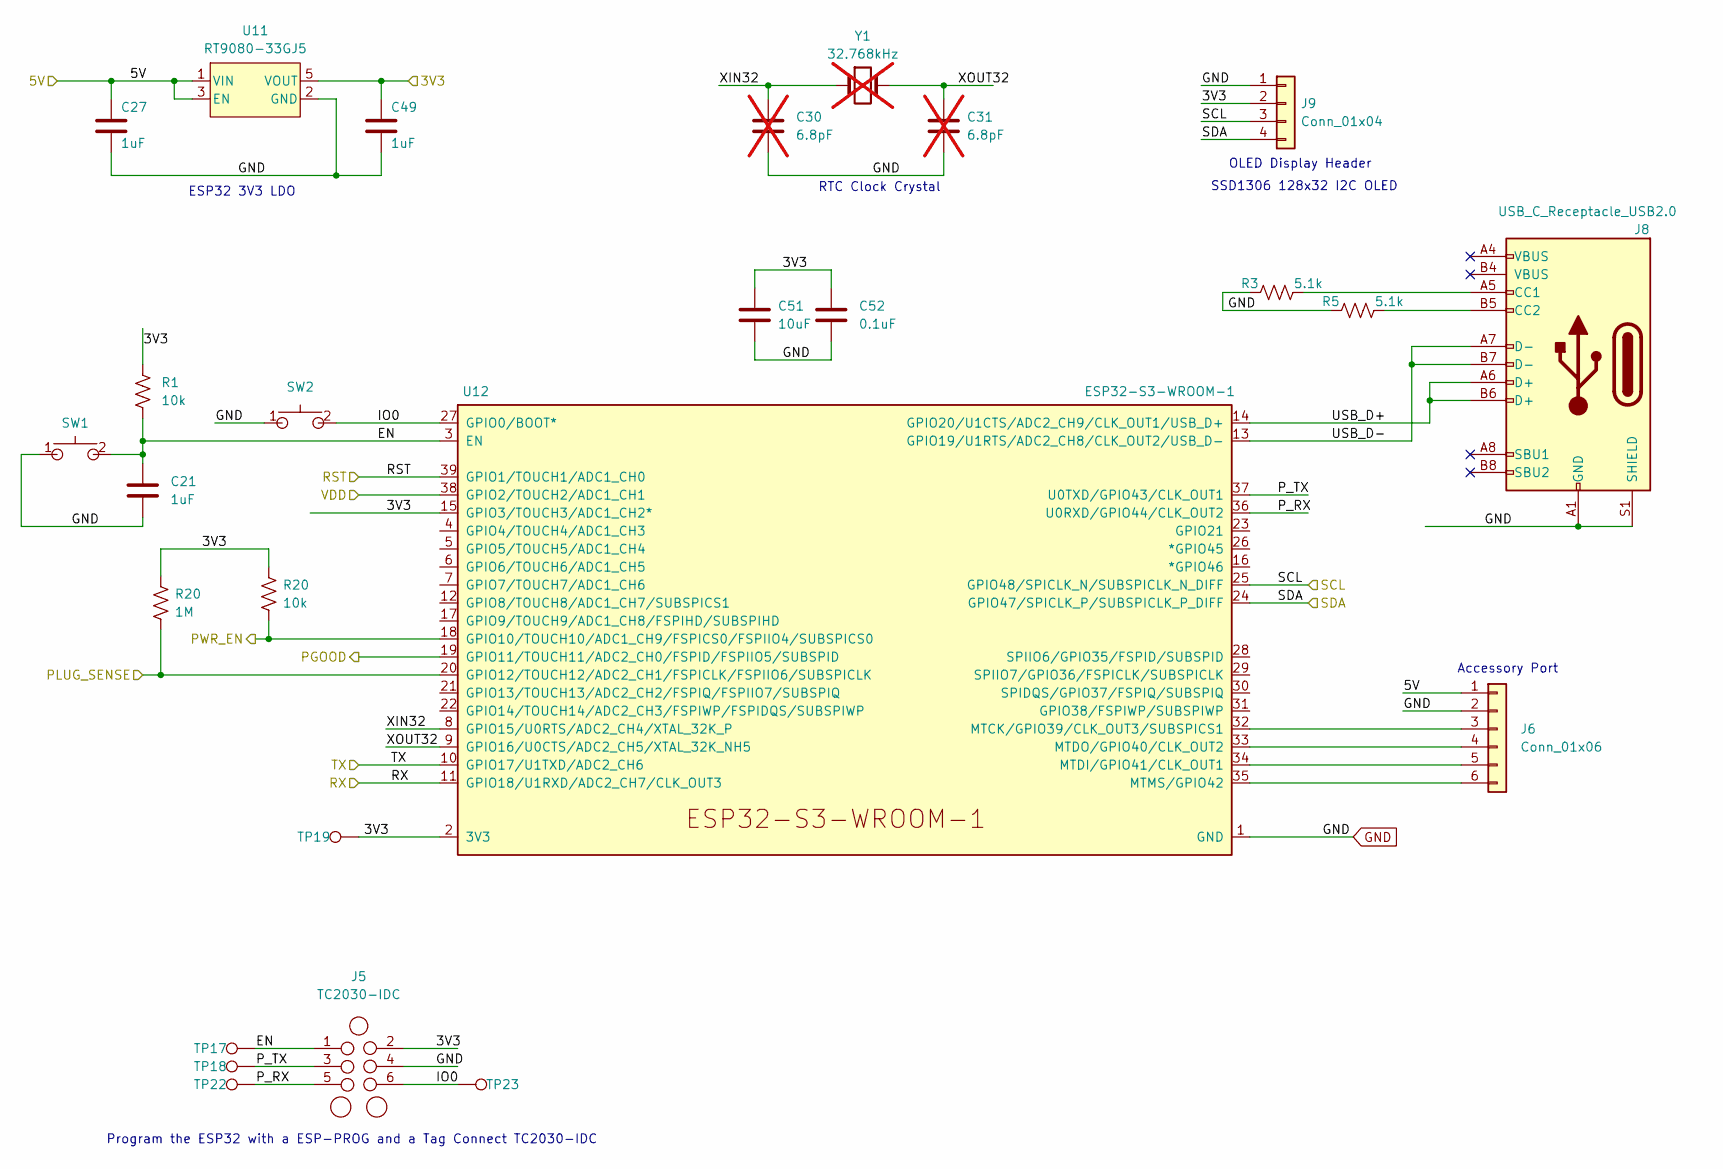
[picture p116: schematic esp32.kicad_sch, Bitaxe Ultra]

Parts:
C21, C27, C49: 1uF; C_0402_1005Metric; PARTNO EMK105BJ105MV-F
C30, C31: 6.8pF; C_0402_1005Metric; PARTNO C0402C689C5GAC7867; not fitted
C51: 10uF; C_0805_2012Metric; PARTNO CL21A106KOQNNNE
C52: 0.1uF; C_0402_1005Metric; PARTNO 0402X104K100CT
J5: TC2030-IDC; Tag-Connect_TC2030-IDC-NL_2x03_P1.27mm_Vertical
J6: Conn_01x06; PinHeader_1x06_P2.54mm_Vertical
J8: USB_C_Receptacle_USB2.0; USB_C_Receptacle_GCT_USB4105-xx-A_16P_TopMnt_Horizontal; PARTNO USB4105-GF-A
J9: Conn_01x04; PinHeader_1x04_P2.54mm_Vertical_shifted; PARTNO NPTC041KFXC-RC
R1: 10k; R_0402_1005Metric; PARTNO RC0402JR-0710KL
R3, R5: 5.1k; R_0402_1005Metric; PARTNO RMCF0402JT5K10
R20: 1M; R_0402_1005Metric; PARTNO RC0402FR-071ML
SW1, SW2: GT-TC029B-H025-L1N; SW_CS1213AGF260_CRS; PARTNO CS1213AGF260
TP17, TP18, TP19, TP22, TP23: TestPoint; TestPoint_Pad_D1.5mm
U11: RT9080-33GJ5; PARTNO RT9080-33GJ5
U12: ESP32-S3-WROOM-1; PARTNO ESP32-S3-WROOM-1-N16R8
Y1: 32.768kHz; SC32S-7PF20PPM; PARTNO SC32S-7PF20PPM; not fitted

Connections:
/3V3: C49.1, C51.1, C52.1, J5.2, J9.2, R1.1, TP19.1, U11.5 (VOUT), U12.2 (3V3), U12.15 (GPIO3/TOUCH3/ADC1_CH2*); also elsewhere on the board
/5V: C27.1, J6.1, U11.1 (VIN), U11.3 (EN); also elsewhere on the board
/ESP32/EN: C21.1, J5.1, R1.2, SW1.2, TP17.1, U12.3 (EN)
/ESP32/IO0: J5.6, SW2.2, TP23.1, U12.27 (GPIO0/BOOT*)
/ESP32/PWR_EN: U12.18 (GPIO10/TOUCH10/ADC1_CH9/FSPICS0/FSPIIO4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); also elsewhere on the board
/ESP32/P_RX: J5.5, TP22.1, U12.36 (U0RXD/GPIO44/CLK_OUT2)
/ESP32/P_TX: J5.3, TP18.1, U12.37 (U0TXD/GPIO43/CLK_OUT1)
/ESP32/USB_D+: J8.A6 (D+), J8.B6 (D+), U12.14 (GPIO20/U1CTS/ADC2_CH9/CLK_OUT1/USB_D+)
/ESP32/USB_D-: J8.A7 (D-), J8.B7 (D-), U12.13 (GPIO19/U1RTS/ADC2_CH8/CLK_OUT2/USB_D-)
/ESP32/XIN32: C30.1, U12.8 (GPIO15/U0RTS/ADC2_CH4/XTAL_32K_P), Y1.1
/ESP32/XOUT32: C31.1, U12.9 (GPIO16/U0CTS/ADC2_CH5/XTAL_32K_NH5), Y1.2
/PLUG_SENSE: U12.20 (GPIO12/TOUCH12/ADC2_CH1/FSPICLK/FSPIIO6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); also elsewhere on the board
/Power/PGOOD: U12.19 (GPIO11/TOUCH11/ADC2_CH0/FSPID/FSPIIO5/S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); also elsewhere on the board
/RST: U12.39 (GPIO1/TOUCH1/ADC1_CH0); also elsewhere on the board
/RX: U12.11 (GPIO18/U1RXD/ADC2_CH7/CLK_OUT3); also elsewhere on the board
/SCL: J9.3, U12.25 (GPIO48/SPICLK_N/SUBSPICLK_N_DIFF); also elsewhere on the board
/SDA: J9.4, U12.24 (GPIO47/SPICLK_P/SUBSPICLK_P_DIFF); also elsewhere on the board
/TX: U12.10 (GPIO17/U1TXD/ADC2_CH6); also elsewhere on the board
/VDD: U12.38 (GPIO2/TOUCH2/ADC1_CH1); also elsewhere on the board
GND: C21.2, C27.2, C30.2, C31.2, C49.2, C51.2, C52.2, J5.4, J6.2, J8.A1 (GND), J8.B1 (GND), J8.S1 (SHIELD), J9.1, R3.1, R5.1, SW1.1, SW2.1, U11.2 (GND), U12.1 (GND), U12.40 (GND), U12.41 (GND); also elsewhere on the board
unnamed: J6.3, U12.32 (MTCK/GPIO39/CLK_OUT3/SUBSPICS1)
unnamed: J6.4, U12.33 (MTDO/GPIO40/CLK_OUT2)
unnamed: J6.5, U12.34 (MTDI/GPIO41/CLK_OUT1)
unnamed: J6.6, U12.35 (MTMS/GPIO42)
unnamed: J8.A5 (CC1), R3.2
unnamed: J8.B5 (CC2), R5.2

Notes on the sheet:
Accessory Port
RTC Clock Crystal
ESP32 3V3 LDO
Program the ESP32 with a ESP-PROG and a Tag Connect TC2030-IDC
SSD1306 128x32 I2C OLED
OLED Display Header

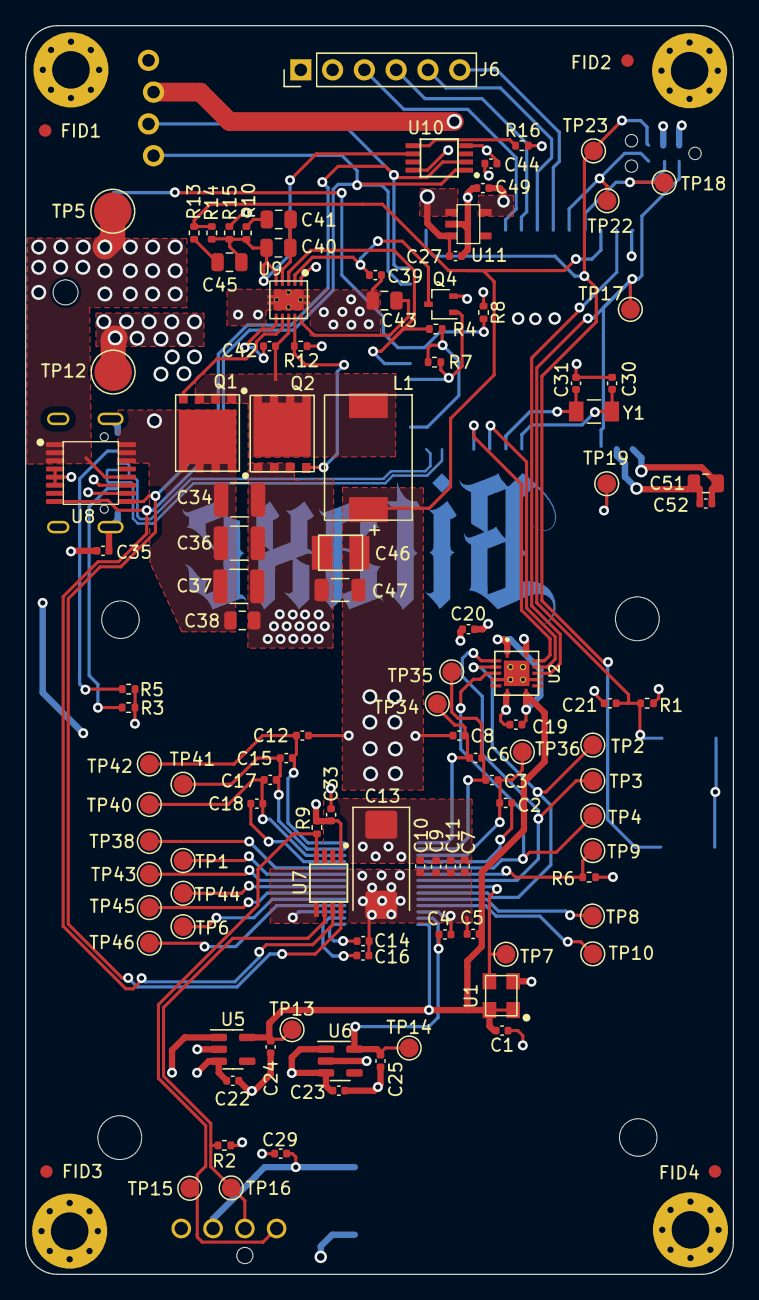
[picture p117: board bitaxeUltra.kicad_pcb from above]

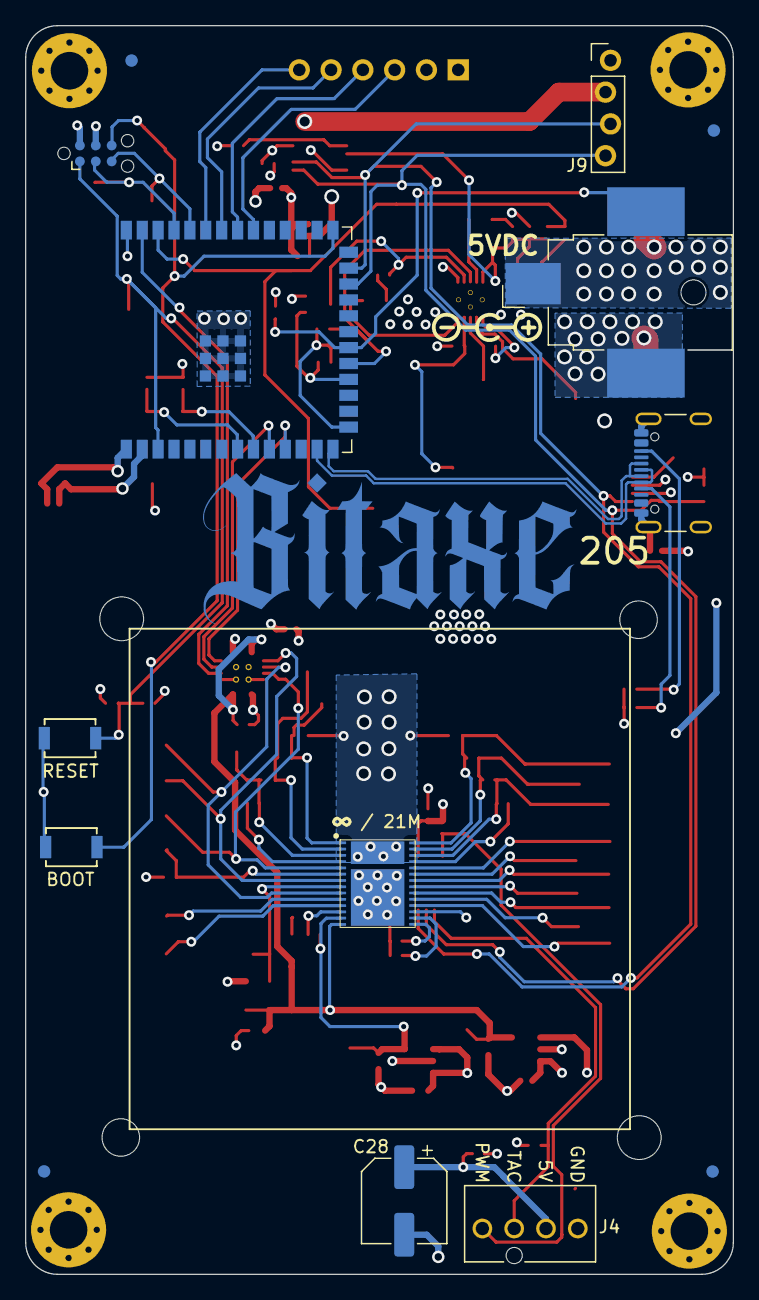
[picture p118: board bitaxeUltra.kicad_pcb from below]

Board: 4 copper layers, 56.5 x 99.8 mm, 135 parts (15 on the bottom side), 64 nets.

Other parts of the board:
R2: 5.6k; R_0402_1005Metric
R7: 10k; R_0402_1005Metric
R8: 1M; R_0402_1005Metric

Their connections:
/3V3: R2.2, R7.1, R8.1; also elsewhere on the board
/ESP32/PWR_EN: R7.2; also elsewhere on the board
/Fan/FAN_TACH: R2.1; also elsewhere on the board
/PLUG_SENSE: R8.2; also elsewhere on the board
