TDX33029/BTCMinerControl/SWAP/BTCMinerMS_MultiASIC/Core/Src/main.c

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
/* Includes ------------------------------------------------------------------*/
#include "main.h"

/* USER CODE BEGIN Includes */
#include "bm1366.h"
#include "protocol.h"
#include "eth_drv.h"
#include "eth_netif.h"
#include "lwip_eth.h"
#include "debug_serial.h"
#include "Delay.h"
#include "tps546d24a.h"
#include "tmp1075.h"
#include <string.h>
#include <stdio.h>
/* USER CODE END Includes */

/* USER CODE BEGIN PD */
#define STATUS_LED_PIN   GPIO_PIN_13
#define STATUS_LED_PORT  GPIOC
#define ASIC_BOOT_PIN    GPIO_PIN_1
#define ASIC_BOOT_PORT   GPIOB
#define ASIC_CTRL_PIN    GPIO_PIN_14
#define ASIC_CTRL_PORT   GPIOB

/* USER CODE END PD */

ETH_HandleTypeDef heth;

I2C_HandleTypeDef hi2c1;

UART_HandleTypeDef huart1;
UART_HandleTypeDef huart2;

/* USER CODE BEGIN PV */

/* ===== Application Config (edit to match your network) ===== */
/* MAC: last 3 bytes are derived at runtime from the board UID (see main()),
   so every board gets a unique MAC for multi-board deployments. The values
   below are just the initial placeholder, overwritten before eth_init(). */
#define CFG_MAC0   0x02   /* locally administered, unicast */
#define CFG_MAC1   0x08
#define CFG_MAC2   0xDC
#define CFG_MAC3   0xAB
#define CFG_MAC4   0xCD
#define CFG_MAC5   0xEF

/* IPv4 address/g+ateway/netmask are obtained via DHCP at runtime
   (see eth_drv.c eth_init -> dhcp_start). The board's own IP is no
   longer statically configured. */

#define CFG_LOCAL_PORT   6000

/* Host PC running BTCMinerControl (HostServices board listener on PC_PORT).
   Board's own IP is obtained via DHCP, so only the server address is static. */
#define PC_IP0     10
#define PC_IP1     8
#define PC_IP2     1
#define PC_IP3     3
#define PC_PORT    4200

#define BM1366_EXPECTED_COUNT  6    /* 最大支持 6 颗 ASIC 链式探测与初始化 */
#define BM1366_TARGET_FREQ_MHZ 100.0f  /* 默认 ASIC 基础安全工作频率 (200MHz) */
/* TPS546D24A 已弃用：供电已更换为独立免配置电源。
   相关 PMBus 配置宏已关闭，保留 TMP1075 板载温度检测。 */
#define TPS546_ENABLED             0
#define BM1366_CORE_VOLTAGE_MV     1200U
/* Bench-test switch: allow a received PC job to reach USART1 even when the
   chip probe finds no BM1366. Disable this on production firmware if desired. */
#define BM1366_UART_TEST_WITHOUT_ASIC  1
/* When 0, parsed PC jobs are logged but NOT forwarded to the ASIC (bring-up:
   detect chips and report the count without hashing). Flip to 1 to start
   dispatching real work. */
#define BM1366_DISPATCH_JOBS  1

/* 开启终端串口 Nonce 结果实时打印输出 */
#define BM1366_LOG_RESULTS    1

#define FW_VERSION_MAJOR  2
#define FW_VERSION_MINOR  6
#define FW_VERSION        ((FW_VERSION_MAJOR << 8) | FW_VERSION_MINOR)
/* Board ID: read at runtime from the STM32F107 96-bit unique device ID (UID)
   at 0x1FFFF7E8. We use the low 64 bits (UID words 0 and 1). */

/* ===== Global Variables ===== */
volatile uint32_t g_ms = 0;
static int  asic_ready    = 0;
static int  connected     = 0;
static uint64_t BOARD_ID  = 0;   /* set from STM32F107 UID at runtime */
static uint32_t active_job_version = 0;  /* base version of current job (for nonce version-rolling) */
static uint32_t active_version_mask = 0x1FFFE000U;  /* chip mask; updated by host command */
static uint32_t job_versions[16] = {0};  /* base version per BM1366 job slot (job_id>>3) */
static protocol_job_t last_job;          /* re-sent after an ASIC frequency change */
static int last_job_valid = 0;

static eth_config_t eth_cfg = {
    .mac = {CFG_MAC0, CFG_MAC1, CFG_MAC2, CFG_MAC3, CFG_MAC4, CFG_MAC5},
    .local_port = CFG_LOCAL_PORT
};

static uint8_t pc_ip_arr[4] = {PC_IP0, PC_IP1, PC_IP2, PC_IP3};
static uint8_t net_rx_buf[2048];
static uint16_t net_rx_buffered = 0;

static uint32_t last_reconnect = 0;
static uint32_t last_hello = 0;
static uint32_t last_sensor_probe = 0;
static uint32_t last_telemetry_sample = 0;
static tps546d24a_t tps546d24a;
static tmp1075_t tmp1075;
static uint8_t tps_detected = 0;
static uint8_t tmp_detected = 0;
static uint8_t tps_reported_state = 0xFFU;
static uint8_t tmp_reported_state = 0xFFU;
static uint8_t tps_desired_enabled = 1;
static protocol_telemetry_t board_telemetry;

/* USER CODE END PV */

void SystemClock_Config(void);
static void MX_GPIO_Init(void);
static void MX_ETH_Init(void);
static void MX_I2C1_Init(void);
static void MX_USART1_UART_Init(void);
static void MX_USART2_UART_Init(void);
/* USER CODE BEGIN PFP */

/* Extra GPIO init for pins not handled by CubeMX */
static void MX_GPIO_Init_Ext(void);

/* Board hello / nonce send / TCP recv helpers */
static void send_board_hello(void);
static void send_board_telemetry(void);
static void probe_i2c_devices(void);
static void sample_i2c_telemetry(void);
static void check_bm1366_results(void);
static void receive_tcp_data(void);

/* USER CODE END PFP */

/**
  * @brief  The application entry point.
  * @retval int
  */
int main(void)
{

  /* MCU Configuration--------------------------------------------------------*/

  /* Reset of all peripherals, Initializes the Flash interface and the Systick. */
  HAL_Init();

  /* Configure the system clock */
  SystemClock_Config();

  /* USER CODE BEGIN SysInit */
  /* Early LED blink: 1 slow blink = clock init OK (before USART2 is ready) */
  {
    __HAL_RCC_GPIOC_CLK_ENABLE();
    GPIO_InitTypeDef early_led = {0};
    early_led.Pin = STATUS_LED_PIN;
    early_led.Mode = GPIO_MODE_OUTPUT_PP;
    early_led.Pull = GPIO_NOPULL;
    early_led.Speed = GPIO_SPEED_FREQ_LOW;
    HAL_GPIO_Init(STATUS_LED_PORT, &early_led);
    HAL_GPIO_WritePin(STATUS_LED_PORT, STATUS_LED_PIN, GPIO_PIN_RESET);
    HAL_Delay(200);
    HAL_GPIO_WritePin(STATUS_LED_PORT, STATUS_LED_PIN, GPIO_PIN_SET);
    HAL_Delay(200);
    HAL_GPIO_WritePin(STATUS_LED_PORT, STATUS_LED_PIN, GPIO_PIN_RESET);
    HAL_Delay(200);
    HAL_GPIO_WritePin(STATUS_LED_PORT, STATUS_LED_PIN, GPIO_PIN_SET);
  }
  /* USER CODE END SysInit */

  /* Initialize all configured peripherals */
  MX_GPIO_Init();
  MX_GPIO_Init_Ext();
  /* ETH and I2C are initialized after the PHY diagnostics below. Calling
     MX_ETH_Init here can hang before diagnostics when REF_CLK is absent. */
  MX_USART1_UART_Init();
  MX_USART2_UART_Init();
  /* USER CODE BEGIN 2 */
  /* ---- Quick diagnostics: USART2 should be alive now ---- */
  /* Raw byte test: write 'U' directly to USART2 DR (bypasses HAL) */
  USART2->DR = 'U';
  while (!(USART2->SR & USART_SR_TC)) {}
  USART2->DR = '\r';
  while (!(USART2->SR & USART_SR_TC)) {}
  USART2->DR = '\n';
  while (!(USART2->SR & USART_SR_TC)) {}

  printf("\r\n===== USART2 OK - DIAG START =====\r\n");

  /* Clock diagnostics */
  printf("[DIAG] HSE_VALUE=%lu Hz\r\n", (unsigned long)HSE_VALUE);
  printf("[DIAG] SystemCoreClock=%lu Hz\r\n", (unsigned long)SystemCoreClock);
  printf("[DIAG] PCLK1=%lu Hz (USART2 clk)\r\n", (unsigned long)HAL_RCC_GetPCLK1Freq());
  printf("[DIAG] PCLK2=%lu Hz (USART1 clk)\r\n", (unsigned long)HAL_RCC_GetPCLK2Freq());
  printf("[DIAG] huart2.gState=%d (expect 0x20=READY)\r\n", (int)huart2.gState);

  /* Board ID = STM32F107 96-bit unique device ID (UID @ 0x1FFFF7E8), low 64 bits */
  BOARD_ID = ((uint64_t)(*(uint32_t*)(UID_BASE + 4U)) << 32) | *(uint32_t*)UID_BASE;
  printf("[DIAG] Board ID (UID): 0x%08lX%08lX\r\n",
         (unsigned long)(BOARD_ID >> 32), (unsigned long)BOARD_ID);

  /* Derive a unique MAC per board from the UID so multiple boards can coexist
     on the same L2 segment (50-board deployment). 0x02 = locally administered,
     unicast; last 3 bytes from the UID -> unique per chip. */
  eth_cfg.mac[0] = 0x02;
  eth_cfg.mac[1] = 0x08;
  eth_cfg.mac[2] = 0xDC;
  eth_cfg.mac[3] = (uint8_t)((BOARD_ID >> 56) & 0xFF);  /* UID word1 (wafer Y coord) */
  eth_cfg.mac[4] = (uint8_t)((BOARD_ID >> 48) & 0xFF);
  eth_cfg.mac[5] = (uint8_t)((BOARD_ID >> 40) & 0xFF);

  /* MCO/PLL3 check: PA8 (MCO) should output 50 MHz from PLL3 -> DP83848.
     If PLL3 isn't locked or MCO source isn't PLL3, PA8 is dead -> no clock
     to PHY/MAC -> MX_ETH_Init hangs on the DMA SWR (link stays DOWN too). */
  {
    uint32_t to = 200000;
    while (!__HAL_RCC_GET_FLAG(RCC_FLAG_PLLI2SRDY) && --to);
    int p3 = __HAL_RCC_GET_FLAG(RCC_FLAG_PLLI2SRDY) ? 1 : 0;
    uint32_t mco = (RCC->CFGR >> 24) & 0x0FU;
    printf("[CLK] PLL3(PLLI2S)ready=%d  RCC_CR=0x%08lX  RCC_CFGR=0x%08lX\r\n",
           p3, (unsigned long)RCC->CR, (unsigned long)RCC->CFGR);
    printf("[CLK] MCO[27:24]=0x%X (0xD=PLL3CLK 50MHz)  CFGR2=0x%08lX "
           "(PREDIV2[7:4]=0x%lX expect 4=div5, PLL3MUL[15:12]=0x%lX expect 8=x10)\r\n",
           (unsigned int)mco, (unsigned long)RCC->CFGR2,
           (unsigned long)((RCC->CFGR2 >> 4) & 0xFU),
           (unsigned long)((RCC->CFGR2 >> 12) & 0xFU));
  }

  /* STATUS LED blink: 3 fast blinks = USART init done */
  for (int i = 0; i < 3; i++) {
    HAL_GPIO_WritePin(STATUS_LED_PORT, STATUS_LED_PIN, GPIO_PIN_RESET);
    HAL_Delay(80);
    HAL_GPIO_WritePin(STATUS_LED_PORT, STATUS_LED_PIN, GPIO_PIN_SET);
    HAL_Delay(80);
  }

  /* ---- Probe PHY via MDIO BEFORE HAL_ETH_Init ----
     On this board PD2 no longer resets the DP83848 (the PHY resets with the
     MCU), so toggling PD2 is a no-op. HAL_ETH_Init's first step is a DMA
     software reset (DMABMR.SWR) that only self-clears while the 50 MHz
     REF_CLK (PHY -> PA1) is present; if REF_CLK is absent the SWR times out
     (HAL_TIMEOUT) and MX_ETH_Init -> Error_Handler hangs. MDIO (MDC/MDIO)
     does NOT need REF_CLK -- only the ETH peripheral clock -- so we can talk
     to the PHY here, before the DMA-SWR gate, to see whether it's alive and
     what mode it's strapped into. */
  printf("[DIAG] MDIO probe of PHY @0x01...\r\n");
  {
    __HAL_RCC_ETH_CLK_ENABLE();
    GPIO_InitTypeDef gi = {0};
    gi.Mode = GPIO_MODE_AF_PP; gi.Speed = GPIO_SPEED_FREQ_HIGH;
    gi.Pin = GPIO_PIN_1;  HAL_GPIO_Init(GPIOC, &gi);   /* MDC  = PC1 */
    gi.Pin = GPIO_PIN_2;  HAL_GPIO_Init(GPIOA, &gi);   /* MDIO = PA2 */
    uint16_t bcr  = ETH_ReadPHYRegister(0x01, 0x00);
    uint16_t bsr  = ETH_ReadPHYRegister(0x01, 0x01);
    uint16_t id1  = ETH_ReadPHYRegister(0x01, 0x02);
    uint16_t id2  = ETH_ReadPHYRegister(0x01, 0x03);
    uint16_t phys = ETH_ReadPHYRegister(0x01, 0x10);
    uint16_t s18  = ETH_ReadPHYRegister(0x01, 0x18);
    uint16_t s19  = ETH_ReadPHYRegister(0x01, 0x19);
    printf("[PHYPROBE] BCR=0x%04X BSR=0x%04X ID=0x%04X:0x%04X (exp 0x2000:0x5C90)\r\n",
           bcr, bsr, id1, id2);
    printf("[PHYPROBE] PHYSTS(0x10)=0x%04X STRAP18=0x%04X STRAP19=0x%04X\r\n",
           phys, s18, s19);
    printf("[PHYPROBE] link=%s  (ID=0xFFFF/0x0000 -> PHY not responding; check 25MHz xtal, MDIO wiring, PHY addr)\r\n",
           (bsr & 0x0004) ? "UP" : "DOWN");
  }

  /* Give the PHY time after MCU reset to emit a stable REF_CLK on PA1 */
  HAL_Delay(300);

  /* ---- Now init ETH ---- */
  printf("[DIAG] About to init ETH...\r\n");
  MX_ETH_Init();
  printf("[DIAG] ETH HAL init done\r\n");

  printf("[DIAG] About to init I2C...\r\n");
  MX_I2C1_Init();
  printf("[DIAG] I2C init done\r\n");

  tps546d24a_init(&tps546d24a, &hi2c1);
  tmp1075_init(&tmp1075, &hi2c1);
  probe_i2c_devices();
  sample_i2c_telemetry();
  last_sensor_probe = HAL_GetTick();
  last_telemetry_sample = last_sensor_probe;

  /* ?? network banner */
  printf("[NET] MAC: %02X:%02X:%02X:%02X:%02X:%02X\r\n",
         eth_cfg.mac[0], eth_cfg.mac[1], eth_cfg.mac[2],
         eth_cfg.mac[3], eth_cfg.mac[4], eth_cfg.mac[5]);
  printf("[NET] IP: DHCP (acquired at runtime)\r\n");
  printf("[NET] Server: %d.%d.%d.%d:%d\r\n", PC_IP0, PC_IP1, PC_IP2, PC_IP3, PC_PORT);

  /* SysTick for g_ms (HAL already started SysTick) */
  extern volatile uint32_t g_ms;
  g_ms = HAL_GetTick();

  printf("\r\n========================================\r\n");
  printf("  BTCMinerMS F107VCT6 + DP83848\r\n");
  printf("  FW v%d.%d\r\n", FW_VERSION_MAJOR, FW_VERSION_MINOR);
  printf("========================================\r\n");
  printf("[SYS] ETH init...\r\n");
  if (!eth_init(&eth_cfg)) {
    printf("[ERR] ETH init FAILED!\r\n");
    while (1) { HAL_Delay(300); }
  }
  printf("[SYS] ETH OK\r\n");
  eth_print_phy_status();

#if BM1366_EXPECTED_COUNT > 0
  printf("[SYS] BM1366 init...\r\n");
  bm1366_uart_init();
  HAL_Delay(500);
  int chips = bm1366_init_chips(BM1366_EXPECTED_COUNT, BM1366_TARGET_FREQ_MHZ);
  asic_ready = (chips > 0) ? chips : 0;
  printf("[SYS] BM1366: %d/%d chip(s) detected\r\n", chips, BM1366_EXPECTED_COUNT);
  printf("[SYS] Job dispatch: %s\r\n", BM1366_DISPATCH_JOBS ? "ENABLED" : "DISABLED (bring-up)");
#else
  asic_ready = 0;
  printf("[SYS] BM1366 disabled (ETH test mode)\r\n");
#endif
  /* USER CODE END 2 */

  /* Infinite loop */
  /* USER CODE BEGIN WHILE */
  static uint32_t last_led_toggle = 0;
  static uint32_t last_status     = 0;
  (void)last_reconnect; (void)last_hello;   /* file-scope static */

  while (1) {
    uint32_t now = HAL_GetTick();


    /* Drive the local 'connected' flag off the real TCP state in eth_drv.
       eth_connect() returns 0 right after issuing the (async) connect, and
       the link can drop (tcp_client_err / recv p==NULL) without main ever
       seeing it -- so a separate flag desyncs and we never reconnect. */
    {
      int net_ok = eth_is_connected();
      if (net_ok && !connected) {
        connected = 1;
        net_rx_buffered = 0;
        printf("[NET] TCP OK\r\n");
        send_board_hello();
        send_board_telemetry();
      } else if (!net_ok && connected) {
        connected = 0;
        net_rx_buffered = 0;
        eth_rx_flush();
        printf("[NET] TCP down, will retry\r\n");
      }
    }

    if (!connected && eth_has_ip() && (now - last_reconnect) > 1000) {
      last_reconnect = now;
      printf("[NET] Connecting %d.%d.%d.%d:%d...\r\n",
             PC_IP0, PC_IP1, PC_IP2, PC_IP3, PC_PORT);
      eth_connect(pc_ip_arr, PC_PORT);
    }

    eth_poll();
    receive_tcp_data();
    check_bm1366_results();

    /* Periodic ASIC health poll: alternate reading Chip ID (0x00) and Total Hash Count (0x8C)
       from each chip individually so they never collide on the return path. */
    static uint32_t last_chip_poll = 0;
    if (asic_ready && (now - last_chip_poll) >= 5000U) {
        last_chip_poll = now;
        static uint8_t poll_phase = 0;
        uint8_t count = bm1366_get_chip_count();
        if (count > 0) {
            uint8_t chip_idx = (poll_phase / 2) % count;
            uint8_t reg = (poll_phase % 2 == 0) ? 0x8C : 0x00;
            bm1366_read_chip_register(chip_idx, reg);
            poll_phase++;
        }
    }

    /* TPS/sensor detection poll: every 10 s in every state, so a
       slow-starting or hot-plugged power module is (re)discovered and
       configured within 10 s - not only when nothing was detected. */
    if ((now - last_sensor_probe) >= 10000U) {
      last_sensor_probe = now;
      probe_i2c_devices();
    }

    if ((now - last_telemetry_sample) >= 2000U) {
      last_telemetry_sample = now;
      sample_i2c_telemetry();
      if (connected) send_board_telemetry();
    }

  if (connected && (now - last_hello) > 20000) {   /* 20s keepalive hello (was 60s -- server closed on idle) */
      last_hello = now;
      send_board_hello();
  }

    /* ? 30s ???????? */
    if ((now - last_status) > 10000) {
        uint8_t ip[4];
        last_status = now;
        eth_get_ip(ip);
        printf("\r\n[STATUS] up=%lus  ip=%u.%u.%u.%u  eth=%s  bm1366=%s  chips=%d  link=%s\r\n"
               "         ETH: rx=%lu tx=%lu | UART1: rx_total=%lu bad_pre=%lu bad_crc=%lu FE=%u ORE=%u\r\n",
               (unsigned long)(now / 1000),
               ip[0], ip[1], ip[2], ip[3],
               connected ? "CONN" : "WAIT",
               asic_ready ? "OK" : "OFF",
               asic_ready ? bm1366_get_chip_count() : 0,
               eth_link_status() ? "UP" : "DOWN",
               (unsigned long)eth_netif_get_rx_count(),
               (unsigned long)eth_netif_get_tx_count(),
               (unsigned long)bm1366_get_rx_total(),
               (unsigned long)bm1366_get_bad_preamble(),
               (unsigned long)bm1366_get_bad_crc(),
               (unsigned int)bm1366_get_frame_errors(),
               (unsigned int)bm1366_get_overruns());
        if ((now % 30000) < 1000) eth_netif_reset_counts();  /* reset every 30s */
    }
    if ((now - last_led_toggle) > 500) {
        last_led_toggle = now;
        if (connected) {
            HAL_GPIO_WritePin(STATUS_LED_PORT, STATUS_LED_PIN, GPIO_PIN_RESET);
        } else {
            HAL_GPIO_TogglePin(STATUS_LED_PORT, STATUS_LED_PIN);
        }
    }

    /* Do not delay here. Ethernet RX is polled, so even a 1 ms sleep adds
       directly to ICMP and host-to-board command latency. */
  }  /* while(1) */

  /* Prevent watchdog-like reset */;
    /* USER CODE END WHILE */

}

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
/* USER CODE BEGIN 4 */
/* ===== ?? GPIO ??? (CubeMX ??????) ===== */
static void MX_GPIO_Init_Ext(void)
{
    GPIO_InitTypeDef GPIO_InitStruct = {0};

    /* GPIO ???? MX_GPIO_Init ??? */

    /* PA8 MCO (50MHz) - re-assert 50MHz speed in case CubeMX regeneration
       restores the LOW-speed setting in MX_GPIO_Init. */
    GPIO_InitStruct.Pin = GPIO_PIN_8;
    GPIO_InitStruct.Mode = GPIO_MODE_AF_PP;
    GPIO_InitStruct.Pull = GPIO_NOPULL;
    GPIO_InitStruct.Speed = GPIO_SPEED_FREQ_HIGH;
    HAL_GPIO_Init(GPIOA, &GPIO_InitStruct);

    /* PA0 - 高阻 (浮空输入, 无上拉/下拉) */
    GPIO_InitStruct.Pin = GPIO_PIN_0;
    GPIO_InitStruct.Mode = GPIO_MODE_INPUT;
    GPIO_InitStruct.Pull = GPIO_NOPULL;
    HAL_GPIO_Init(GPIOA, &GPIO_InitStruct);

    /* PC13 - STATUS LED (????) */
    GPIO_InitStruct.Pin = STATUS_LED_PIN;
    GPIO_InitStruct.Mode = GPIO_MODE_OUTPUT_PP;
    GPIO_InitStruct.Pull = GPIO_NOPULL;
    GPIO_InitStruct.Speed = GPIO_SPEED_FREQ_LOW;
    HAL_GPIO_Init(STATUS_LED_PORT, &GPIO_InitStruct);
    HAL_GPIO_WritePin(STATUS_LED_PORT, STATUS_LED_PIN, GPIO_PIN_SET);  /* ??: ? */

    /* PB1 - ASIC_BOOT (??) */
    GPIO_InitStruct.Pin = ASIC_BOOT_PIN;
    GPIO_InitStruct.Mode = GPIO_MODE_OUTPUT_PP;
    GPIO_InitStruct.Pull = GPIO_NOPULL;
    GPIO_InitStruct.Speed = GPIO_SPEED_FREQ_LOW;
    HAL_GPIO_Init(ASIC_BOOT_PORT, &GPIO_InitStruct);
    HAL_GPIO_WritePin(ASIC_BOOT_PORT, ASIC_BOOT_PIN, GPIO_PIN_RESET);

    /* PB14 - ASIC_CTRL (??) */
    GPIO_InitStruct.Pin = ASIC_CTRL_PIN;
    GPIO_InitStruct.Mode = GPIO_MODE_OUTPUT_PP;
    GPIO_InitStruct.Pull = GPIO_NOPULL;
    GPIO_InitStruct.Speed = GPIO_SPEED_FREQ_LOW;
    HAL_GPIO_Init(ASIC_CTRL_PORT, &GPIO_InitStruct);
    HAL_GPIO_WritePin(ASIC_CTRL_PORT, ASIC_CTRL_PIN, GPIO_PIN_RESET);
}

static void send_frequency_status(void) {
    protocol_frequency_status_t freq;
    freq.target_mhz = bm1366_get_target_frequency();
    freq.actual_mhz = bm1366_get_actual_frequency();
    uint8_t buf[16];
    uint16_t len = protocol_encode_frequency_status(&freq, buf);
    if (len > 0) eth_send(buf, len);
}

static void apply_board_frequency(uint16_t target_mhz) {
    /* 暂时忽略上位机下发的频率调节命令，固定在安全可靠的基础频率 (200MHz)，
       防止多芯片在瞬间切到 485MHz 造成过载或失锁。向 host 如实反馈当前频率。 */
    printf("[FREQ] host request %u MHz -> IGNORED (locked at %u MHz for stability)\r\n",
           (unsigned int)target_mhz, (unsigned int)bm1366_get_actual_frequency());
    send_frequency_status();
}

static void send_board_hello(void) {
    protocol_hello_t hello = {
        .board_id = BOARD_ID,
        .fw_version = FW_VERSION,
        .asic_count = (uint8_t)asic_ready,
        .status = 0,
        .target_frequency_mhz = bm1366_get_target_frequency(),
        .actual_frequency_mhz = bm1366_get_actual_frequency()
    };
    uint8_t buf[64];
    uint16_t len = protocol_encode_hello(&hello, buf);
    if (len > 0) {
        /* TEMP: HELLO print silenced
        printf("[HELLO] board_id=0x%08X%08X asic=%d fw=%d.%d len=%d\r\n",
               (uint32_t)(BOARD_ID >> 32), (uint32_t)BOARD_ID,
               hello.asic_count, FW_VERSION_MAJOR, FW_VERSION_MINOR, len); */
        eth_send(buf, len);
    }
}

static void probe_i2c_devices(void) {
#if TPS546_ENABLED
    if (!tps_detected) {
        tps_detected = tps546d24a_probe(&tps546d24a);
        if (tps_detected) {
            tps546d24a_set_enabled(&tps546d24a, tps_desired_enabled);
        }
    }
#endif
    if (!tmp_detected) tmp_detected = tmp1075_probe(&tmp1075);
    if (tmp_reported_state != tmp_detected) {
        if (tmp_detected) {
            printf("[I2C] TMP1075 @0x%02X: detected\r\n", tmp1075.address);
        } else {
            printf("[I2C] TMP1075 @0x48-0x4F: not detected\r\n");
        }
        tmp_reported_state = tmp_detected;
    }
}

static void sample_i2c_telemetry(void) {
    tps546d24a_telemetry_t tps_data;
    int16_t tmp_temperature = 0;
    uint8_t tps_valid = 0;
    uint8_t tmp_valid = 0;

    memset(&board_telemetry, 0, sizeof(board_telemetry));
    if (tps_detected) {
        static uint16_t last_reported_tps_status = 0;
        tps_valid = tps546d24a_read_telemetry(&tps546d24a, &tps_data);
        if (tps_valid) {
            board_telemetry.vout_mv = tps_data.vout_mv;
            board_telemetry.iout_ma = tps_data.iout_ma;
            board_telemetry.power_mw = tps_data.power_mw;
            board_telemetry.tps_temperature_centi_c = tps_data.temperature_centi_c;
            board_telemetry.tps_status_word = tps_data.status_word;
            board_telemetry.power_enabled = tps_data.enabled;
            /* Report a newly-latched fault once (then clear) instead of
               letting stale bits persist in every telemetry frame. */
            if (tps_data.status_word != 0U &&
                tps_data.status_word != last_reported_tps_status) {
                printf("[TPS] fault: STATUS_WORD=0x%04X READ_VOUT=%u mV IOUT=%lu mA\r\n",
                       (unsigned int)tps_data.status_word,
                       (unsigned int)tps_data.vout_mv,
                       (unsigned long)tps_data.iout_ma);
                tps546d24a_clear_faults(&tps546d24a);
            }
            last_reported_tps_status =
                (tps_data.status_word == 0U) ? 0U : tps_data.status_word;
        } else if (!tps546d24a_probe(&tps546d24a)) {
            tps_detected = 0;
        }
    }

    if (tmp_detected) {
        tmp_valid = tmp1075_read_temperature(&tmp1075, &tmp_temperature);
        if (tmp_valid) {
            board_telemetry.tmp_temperature_centi_c = tmp_temperature;
        } else if (HAL_I2C_IsDeviceReady(&hi2c1,
                   (uint16_t)(tmp1075.address << 1), 1, 20) != HAL_OK) {
            tmp_detected = 0;
            tmp1075.address = 0;
        }
    }

    if (tps_detected) board_telemetry.flags |= TELEMETRY_FLAG_TPS_DETECTED;
    if (tmp_detected) board_telemetry.flags |= TELEMETRY_FLAG_TMP_DETECTED;
    if (tps_valid) board_telemetry.flags |= TELEMETRY_FLAG_TPS_VALID;
    if (tmp_valid) board_telemetry.flags |= TELEMETRY_FLAG_TMP_VALID;
    if (tps_valid) board_telemetry.flags |= TELEMETRY_FLAG_POWER_VALID;
    board_telemetry.tps_address = tps_detected ? tps546d24a.address : 0;
    board_telemetry.tmp_address = tmp_detected ? tmp1075.address : 0;
}

static void send_board_telemetry(void) {
    uint8_t buf[32];
    uint16_t len = protocol_encode_telemetry(&board_telemetry, buf);
    if (len > 0) eth_send(buf, len);
}

static void check_bm1366_results(void) {
    if (!asic_ready) return;

    /* Route every valid 11-byte UART frame: bit 7 set = nonce result,
       otherwise a command/register response. */
    bm1366_result_raw_t raw;
    while (bm1366_read_any_result(&raw, 0) > 0) {
        uint8_t *rp = (uint8_t *)&raw;
        printf("[RAWFRAME] %02X %02X %02X %02X %02X %02X %02X %02X %02X %02X %02X (flag=0x%02X)\r\n",
               rp[0], rp[1], rp[2], rp[3], rp[4], rp[5], rp[6], rp[7], rp[8], rp[9], rp[10], raw.crc_and_flags);

        if (raw.crc_and_flags & 0x80U) {
            /* 结果包解析:
               - parsed.nonce: 保持原始 wire 字节序 (小端 host 值)，上位机以 LE 直接拼入 80B 区块头第 76..79 字节
               - nonce_h: raw.nonce 即为小端主机值，MSB (bit 25..31) 包含 Core ID，bit 17..24 包含 ASIC 地址 */
            bm1366_result_t parsed = {0};
            uint32_t nonce_h = raw.nonce;
            uint16_t ver_h   = ((raw.version_raw & 0xFFU) << 8) | ((raw.version_raw >> 8) & 0xFFU);
            parsed.nonce        = raw.nonce;
            parsed.job_id       = raw.job_id_raw & 0xF8;
            parsed.small_core_id= raw.job_id_raw & 0x07;
            parsed.core_id      = (nonce_h >> 25) & 0x7F;
            uint8_t interval    = bm1366_get_address_interval();
            parsed.asic_nr      = (interval > 0) ? (((nonce_h >> 17) & 0xFF) / interval) : 0;
            {
                uint32_t job_version = job_versions[(parsed.job_id >> 3) & 0x0FU];
                if (job_version == 0) job_version = active_job_version;
                parsed.rolled_version = job_version | ((uint32_t)ver_h << 13);
            }
            printf("[NONCE] job_id=%d nonce=0x%08X (raw=0x%08X) core=%d small=%d asic=%d rolled_ver=0x%08X\r\n",
                   parsed.job_id, nonce_h, parsed.nonce, parsed.core_id, parsed.small_core_id, parsed.asic_nr, parsed.rolled_version);

            uint8_t buf[64];
            uint16_t len = protocol_encode_nonce(&parsed, BOARD_ID, buf);
            if (len > 0) {
                eth_send(buf, len);
                printf("[NET-NONCE] Forwarded %u bytes to Host\r\n", (unsigned int)len);
            }
            continue;
        } else {
            /* 寄存器读取回包解析:
               raw.midstate_num = asic_address (0x00, 0x80, ...)
               raw.job_id_raw   = register_address (0x00, 0x8C, ...)
               raw.nonce        = 32-bit register value */
            uint8_t asic_addr = raw.midstate_num;
            uint8_t reg_addr  = raw.job_id_raw;
            uint32_t val      = __REV(raw.nonce);
            uint8_t interval  = bm1366_get_address_interval();
            uint8_t asic_nr   = (interval > 0) ? (asic_addr / interval) : 0;
            printf("[CHIP-REG] asic=%u (addr=0x%02X) reg=0x%02X val=0x%08lX (%lu)\r\n",
                   (unsigned int)asic_nr, (unsigned int)asic_addr, (unsigned int)reg_addr,
                   (unsigned long)val, (unsigned long)val);
        }
    }
}

static void receive_tcp_data(void) {
    /* Never interpret stale bytes from a previous TCP connection as protocol
       frames. eth_rx_flush() clears the LwIP ring on disconnect; this guards
       the already-buffered application side during the transition loop. */
    if (!eth_is_connected()) {
        net_rx_buffered = 0;
        return;
    }

    int received = eth_recv(net_rx_buf + net_rx_buffered,
                            (uint16_t)(sizeof(net_rx_buf) - net_rx_buffered));
    if (received > 0) net_rx_buffered = (uint16_t)(net_rx_buffered + received);
    if (net_rx_buffered == 0) return;

    /* A single TCP segment may carry several protocol frames back-to-back,
       and they were already ACKed to lwIP inside eth_recv -- so we must walk
       the whole buffer, not just the first frame, or we silently lose the
       rest. The wire format is [4B big-endian total][1B type][payload],
       so the payload begins at offset 5 of each frame. */
    uint16_t off = 0;
    while (off + 4 <= net_rx_buffered) {
        uint16_t frame_len, payload_len;
        uint8_t type = protocol_peek_frame(net_rx_buf + off, net_rx_buffered - off,
                                           &frame_len, &payload_len);
        if (frame_len == 0xFFFFU) {
            printf("[TCP] Invalid frame length; dropping buffered stream\r\n");
            net_rx_buffered = 0;
            return;
        }
        if (type == 0) break;                                  /* incomplete: preserve it */

        const uint8_t *payload = net_rx_buf + off + 5;
        if (type != MSG_LATENCY_PROBE) {
            /* printf("[TCP] type=0x%02X frame=%d payload=%d\r\n", type, frame_len, payload_len); TEMP: quiet */
        }

        switch (type) {
            case MSG_JOB: {
                protocol_job_t job;
                if (protocol_decode_job(payload, payload_len, &job) > 0) {
                    memcpy(&last_job, &job, sizeof(last_job));
                    last_job_valid = 1;
                    active_job_version = job.version;   /* track for nonce version-rolling */
                    job_versions[(job.job_id >> 3) & 0x0FU] = job.version;
                    printf("[JOB] id=%d midstates=%d version=0x%08X nbits=0x%08X ntime=0x%08X nonce_start=0x%08X\r\n",
                           job.job_id, job.num_midstates, job.version,
                           job.nbits, job.ntime, job.starting_nonce);
                    if (BM1366_DISPATCH_JOBS && (asic_ready || BM1366_UART_TEST_WITHOUT_ASIC)) {
                        bm1366_send_job(&job);
                        if (!asic_ready) printf("[UART1-TEST] Job forwarded without ASIC\r\n");
                    }
                    /* else: BM1366_DISPATCH_JOBS=0 -> job parsed/logged above but not forwarded (bring-up) */
                }
                break;
            }
            case MSG_SET_PARAMS: {
                protocol_setparams_t params;
                if (protocol_decode_setparams(payload, payload_len, &params) > 0) {
                    printf("[PARAM] freq=%d MHz voltage=%d mV\r\n",
                           params.freq_mhz, params.voltage_mv);
                    apply_board_frequency(params.freq_mhz);
                    /* Voltage now actually applied (was ignored before).
                       tps546d24a_set_vout_mv enforces the 1000..2000 mV
                       window configured at boot. */
                    if (tps_detected &&
                        !tps546d24a_set_vout_mv(&tps546d24a,
                                                (uint16_t)params.voltage_mv)) {
                        printf("[PARAM] voltage %d mV rejected (range 1000-2000)\r\n",
                               params.voltage_mv);
                    }
                }
                break;
            }

            case MSG_SET_FREQUENCY: {
                protocol_set_frequency_t freq;
                if (protocol_decode_set_frequency(payload, payload_len, &freq) > 0) {
                    apply_board_frequency(freq.frequency_mhz);
                }
                break;
            }
            case MSG_SET_VERSION_MASK: {
                protocol_version_mask_t mask;
                if (protocol_decode_version_mask(payload, payload_len, &mask) > 0) {
                    active_version_mask = mask.version_mask;
                    if (asic_ready) bm1366_set_version_mask(active_version_mask);
                    printf("[MASK] version mask set to 0x%08X\r\n", (unsigned int)active_version_mask);
                }
                break;
            }

            case MSG_SET_POWER: {
                protocol_setpower_t power;
                uint8_t reply[64];
                uint16_t reply_len;
                if (!protocol_decode_setpower(payload, payload_len, &power)) {
                    reply_len = protocol_encode_error(0x20, "invalid power command", reply);
#if TPS546_ENABLED
                } else if (!tps_detected) {
                    reply_len = protocol_encode_error(0x21, "TPS546D24A not detected", reply);
                } else if (!tps546d24a_set_enabled(&tps546d24a, power.enabled)) {
                    reply_len = protocol_encode_error(0x22, "TPS546D24A power command failed", reply);
#endif
                } else {
                    tps_desired_enabled = power.enabled;
                    printf("[POWER] power state -> %s\r\n", power.enabled ? "ON" : "OFF");
                    sample_i2c_telemetry();
                    send_board_telemetry();
                    reply_len = protocol_encode_ack(MSG_SET_POWER, reply);
                }
                if (reply_len > 0) eth_send(reply, reply_len);
                break;
            }
            case MSG_LATENCY_PROBE: {
                protocol_latency_t latency;
                uint8_t reply[16];
                if (protocol_decode_latency(payload, payload_len, &latency)) {
                    uint16_t reply_len = protocol_encode_latency(&latency, reply);
                    if (reply_len > 0) eth_send(reply, reply_len);
                }
                break;
            }
            default:
                printf("[TCP] Unknown type 0x%02X, hex:", type);
                for (uint16_t i = 0; i < (payload_len > 16 ? 16 : payload_len); i++)
                    printf(" %02X", payload[i]);
                printf("\r\n");
                break;
        }

        off += frame_len;
    }

    if (off > 0) {
        net_rx_buffered = (uint16_t)(net_rx_buffered - off);
        if (net_rx_buffered > 0) memmove(net_rx_buf, net_rx_buf + off, net_rx_buffered);
    } else if (net_rx_buffered == sizeof(net_rx_buf)) {
        printf("[TCP] Receive frame exceeds buffer; dropping stream\r\n");
        net_rx_buffered = 0;
    }
}
/* USER CODE END 4 */
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
