TDX33029/BTCMinerControl/SWAP/HostServices/src/dispatch/manager.cpp

#include "manager.h"
#include "../platform/platform.h"
#include "../mine/job.h"
#include <algorithm>
#include <chrono>
#include <climits>
#include <cmath>
#include <iomanip>
#include <iostream>
#include <sstream>

namespace {

uint64_t steady_time_us() {
    return static_cast<uint64_t>(std::chrono::duration_cast<std::chrono::microseconds>(
        std::chrono::steady_clock::now().time_since_epoch()).count());
}

bool send_all(SOCKET socket, const uint8_t* data, size_t size) {
    size_t offset = 0;
    while (offset < size) {
        const int chunk = static_cast<int>(std::min<size_t>(
            size - offset, static_cast<size_t>(INT_MAX)));
        const int sent = ::send(socket,
            reinterpret_cast<const char*>(data + offset), chunk, 0);
        if (sent <= 0) return false;
        offset += static_cast<size_t>(sent);
    }
    return true;
}

std::string event_timestamp() {
    return platform::local_timestamp_ms();
}

std::string board_name(uint64_t board_id) {
    std::ostringstream out;
    out << "Board 0x" << std::hex << std::uppercase << board_id;
    return out.str();
}

std::string hex_word(uint16_t value) {
    std::ostringstream out;
    out << "0x" << std::hex << std::uppercase << std::setfill('0')
        << std::setw(4) << value;
    return out.str();
}

} // namespace

BoardManager::~BoardManager() {
    stop();
}

bool BoardManager::start(uint16_t port) {
    if (m_running || port == 0) return false;
    m_stop = false;

    m_listen_sock = socket(AF_INET, SOCK_STREAM, IPPROTO_TCP);
    if (m_listen_sock == INVALID_SOCKET) {
        std::cerr << "[boards] socket() failed: " << WSAGetLastError() << std::endl;
        return false;
    }

    int reuse = 1;
    setsockopt(m_listen_sock, SOL_SOCKET, SO_REUSEADDR,
               reinterpret_cast<const char*>(&reuse), sizeof(reuse));

    sockaddr_in addr{};
    addr.sin_family = AF_INET;
    addr.sin_addr.s_addr = INADDR_ANY;
    addr.sin_port = htons(port);

    if (bind(m_listen_sock, reinterpret_cast<sockaddr*>(&addr), sizeof(addr))
        == SOCKET_ERROR) {
        const int error = WSAGetLastError();
        std::cerr << "[boards] bind(0.0.0.0:" << port
                  << ") failed: " << error << std::endl;
        if (error == WSAEACCES) {
            std::cerr << "[boards] Access denied. This port may be inside a "
                         "Windows excluded port range; run `netsh interface "
                         "ipv4 show excludedportrange protocol=tcp` to check."
                      << std::endl;
        } else if (error == WSAEADDRINUSE) {
            std::cerr << "[boards] The port is already in use by another process."
                      << std::endl;
        }
        closesocket(m_listen_sock);
        m_listen_sock = INVALID_SOCKET;
        return false;
    }
    if (listen(m_listen_sock, SOMAXCONN) == SOCKET_ERROR) {
        std::cerr << "[boards] listen() failed: " << WSAGetLastError() << std::endl;
        closesocket(m_listen_sock);
        m_listen_sock = INVALID_SOCKET;
        return false;
    }
    platform::set_nonblocking(m_listen_sock, true);

    m_port = port;
    m_running = true;
    m_accept_thread = std::thread(&BoardManager::acceptLoop, this);
    m_detection_thread = std::thread(&BoardManager::detectionLoop, this);
    std::cout << "[boards] Listening on port " << port << std::endl;
    return true;
}

void BoardManager::stop() {
    if (m_stop.exchange(true) && !m_running) return;
    m_running = false;
    m_detection_cv.notify_all();
    if (m_detection_thread.joinable()) m_detection_thread.join();

    if (m_listen_sock != INVALID_SOCKET) {
        closesocket(m_listen_sock);
        m_listen_sock = INVALID_SOCKET;
    }

    // shutdown() wakes the owning receive thread; that thread performs the
    // single closesocket(), avoiding handle-reuse races and double closes.
    {
        std::lock_guard<std::mutex> lock(m_mutex);
        for (auto& board : m_boards) {
            if (board.online && board.info.socket != INVALID_SOCKET) {
                shutdown(board.info.socket, SD_BOTH);
            }
        }
    }

    if (m_accept_thread.joinable()) m_accept_thread.join();

    std::vector<std::thread> receivers;
    {
        std::lock_guard<std::mutex> lock(m_threads_mutex);
        receivers.swap(m_receiver_threads);
    }
    for (auto& receiver : receivers) {
        if (receiver.joinable()) receiver.join();
    }

    std::lock_guard<std::mutex> lock(m_mutex);
    for (auto& board : m_boards) {
        board.online = false;
        board.info.socket = INVALID_SOCKET;
    }
}

void BoardManager::acceptLoop() {
    while (!m_stop) {
        sockaddr_in client_addr{};
        socklen_t addr_len = sizeof(client_addr);
        SOCKET client = accept(m_listen_sock,
            reinterpret_cast<sockaddr*>(&client_addr), &addr_len);
        if (client == INVALID_SOCKET) {
            if (m_stop) break;
            const int error = WSAGetLastError();
            if (error != WSAEINTR && error != WSAENOTSOCK &&
                error != WSAEWOULDBLOCK) {
                std::cerr << "[boards] accept() failed: " << error << std::endl;
            }
            std::this_thread::sleep_for(std::chrono::milliseconds(100));
            continue;
        }

        int no_delay = 1;
        setsockopt(client, IPPROTO_TCP, TCP_NODELAY,
                   reinterpret_cast<const char*>(&no_delay), sizeof(no_delay));

        char ip_str[INET_ADDRSTRLEN]{};
        inet_ntop(AF_INET, &client_addr.sin_addr, ip_str, sizeof(ip_str));

        MessageReader reader;
        std::vector<uint8_t> data;
        const ReceiveResult hello_result = reader.receive(client, data, 5000);
        BoardHello hello{};
        if (hello_result != ReceiveResult::Message || data.empty() ||
            data[0] != static_cast<uint8_t>(MsgType::BoardHello) ||
            !decode_board_hello(data.data() + 1, data.size() - 1, hello)) {
            std::cerr << "[boards] Invalid hello from " << ip_str << std::endl;
            closesocket(client);
            continue;
        }

        BoardInfo info{};
        info.board_id = hello.board_id;
        info.asic_count = hello.asic_count;
        info.firmware_version = hello.fw_version;
        info.status = hello.status;
        info.target_frequency_mhz = hello.target_frequency_mhz;
        info.actual_frequency_mhz = hello.actual_frequency_mhz;
        info.socket = client;
        info.ip_addr = ip_str;
        info.last_heartbeat = platform::tick_ms();

        const uint64_t connection_id = m_next_connection_id.fetch_add(1);
        {
            std::lock_guard<std::mutex> lock(m_mutex);
            auto board_it = std::find_if(m_boards.begin(), m_boards.end(),
                [&](const BoardStats& board) {
                    return board.info.board_id == hello.board_id;
                });

            if (board_it != m_boards.end()) {
                if (board_it->online && board_it->info.socket != INVALID_SOCKET) {
                    shutdown(board_it->info.socket, SD_BOTH);
                }
                *board_it = BoardStats{};
                board_it->info = info;
                board_it->online = true;
                board_it->connected_since = info.last_heartbeat;
                board_it->connection_id = connection_id;
            } else {
                BoardStats stats{};
                stats.info = info;
                stats.online = true;
                stats.connected_since = info.last_heartbeat;
                stats.connection_id = connection_id;
                m_boards.push_back(stats);
            }
            m_hashrate_samples[hello.board_id].clear();
            appendEventLocked(hello.board_id, "INFO",
                board_name(hello.board_id) + " online from " + ip_str);
            if (hello.status != 0) {
                appendEventLocked(hello.board_id, "ERROR",
                    board_name(hello.board_id) + " reports fault status " +
                    std::to_string(hello.status));
            }
        }

        std::cout << "[boards] Board " << std::hex << hello.board_id << std::dec
                  << " connected from " << ip_str << " ("
                  << int(hello.asic_count) << " ASICs)" << std::endl;

        {
            std::lock_guard<std::mutex> lock(m_threads_mutex);
            m_receiver_threads.emplace_back(&BoardManager::recvLoop, this,
                client, info, connection_id, std::move(reader));
        }

        if (onBoardConnected) onBoardConnected(hello.board_id);
    }
}

void BoardManager::recvLoop(SOCKET sock, BoardInfo board,
                            uint64_t connection_id, MessageReader reader) {
    uint64_t last_heartbeat = board.last_heartbeat;
    std::string disconnect_reason = "connection closed";

    while (!m_stop) {
        std::vector<uint8_t> data;
        const ReceiveResult result = reader.receive(sock, data, 1000);
        if (result == ReceiveResult::Timeout) {
            if (platform::tick_ms() - last_heartbeat > 30000) {
                std::cerr << "[boards] Board " << board.board_id
                          << " timed out" << std::endl;
                disconnect_reason = "communication timeout";
                break;
            }
            continue;
        }
        if (result != ReceiveResult::Message) {
            if (result == ReceiveResult::ProtocolError) {
                disconnect_reason = "protocol error";
            } else if (result == ReceiveResult::SocketError) {
                disconnect_reason = "socket error";
            }
            break;
        }

        last_heartbeat = platform::tick_ms();
        {
            std::lock_guard<std::mutex> lock(m_mutex);
            for (auto& current : m_boards) {
                if (current.info.board_id == board.board_id &&
                    current.connection_id == connection_id) {
                    current.info.last_heartbeat = last_heartbeat;
                    break;
                }
            }
        }

        if (data.empty()) continue;
        const MsgType type = static_cast<MsgType>(data[0]);
        const size_t payload_len = data.size() - 1;
        const uint8_t* payload = payload_len ? data.data() + 1 : nullptr;

        if (type == MsgType::NonceResult) {
            NonceResult nonce{};
            nonce.board_id = board.board_id;
            if (decode_nonce_result(payload, payload_len, nonce)) {
                if (onNonceResult) onNonceResult(nonce);
            }
        } else if (type == MsgType::HashrateSample) {
            uint32_t hashrate_mhs = 0;
            if (decode_hashrate_sample(payload, payload_len, hashrate_mhs)) {
                processHashrateSample(board.board_id, hashrate_mhs);
            }
        } else if (type == MsgType::FrequencyStatus) {
            uint16_t target_mhz = 0;
            uint16_t actual_mhz = 0;
            if (decode_frequency_status(payload, payload_len,
                                        target_mhz, actual_mhz)) {
                std::lock_guard<std::mutex> lock(m_mutex);
                for (auto& current : m_boards) {
                    if (current.info.board_id == board.board_id &&
                        current.connection_id == connection_id) {
                        current.info.target_frequency_mhz = target_mhz;
                        current.info.actual_frequency_mhz = actual_mhz;
                        appendEventLocked(board.board_id, "INFO",
                            board_name(board.board_id) + " frequency set to " +
                            std::to_string(actual_mhz) + " MHz (target " +
                            std::to_string(target_mhz) + " MHz)");
                        break;
                    }
                }
            }
        } else if (type == MsgType::AsicRegister) {
            AsicRegister reg{};
            if (decode_asic_register(payload, payload_len, reg) && onAsicRegister) {
                onAsicRegister(board.board_id, reg);
            }
        } else if (type == MsgType::BoardTelemetry) {
            BoardTelemetry telemetry{};
            if (decode_board_telemetry(payload, payload_len, telemetry)) {
                std::lock_guard<std::mutex> lock(m_mutex);
                for (auto& current : m_boards) {
                    if (current.info.board_id == board.board_id &&
                        current.connection_id == connection_id) {
                        const bool first = current.telemetry_updated == 0;
                        const BoardTelemetry previous = current.telemetry;
                        current.telemetry = telemetry;
                        current.telemetry_updated = last_heartbeat;
                        if (first) {
                            if (!telemetry.tpsDetected()) {
                                appendEventLocked(board.board_id, "WARN",
                                    board_name(board.board_id) +
                                    " TPS546D24A not detected");
                            }
                            if (!telemetry.tmp1075Detected()) {
                                appendEventLocked(board.board_id, "WARN",
                                    board_name(board.board_id) +
                                    " TMP1075 not detected");
                            }
                        } else {
                            if (previous.tpsDetected() != telemetry.tpsDetected()) {
                                appendEventLocked(board.board_id,
                                    telemetry.tpsDetected() ? "INFO" : "WARN",
                                    board_name(board.board_id) +
                                    (telemetry.tpsDetected()
                                        ? " TPS546D24A detected"
                                        : " TPS546D24A not detected"));
                            }
                            if (previous.tmp1075Detected() != telemetry.tmp1075Detected()) {
                                appendEventLocked(board.board_id,
                                    telemetry.tmp1075Detected() ? "INFO" : "WARN",
                                    board_name(board.board_id) +
                                    (telemetry.tmp1075Detected()
                                        ? " TMP1075 detected"
                                        : " TMP1075 not detected"));
                            }
                        }
                        if (previous.tps_status_word != telemetry.tps_status_word) {
                            if (telemetry.tps_status_word != 0) {
                                appendEventLocked(board.board_id, "ERROR",
                                    board_name(board.board_id) +
                                    " TPS546D24A status " +
                                    hex_word(telemetry.tps_status_word));
                            } else if (!first && previous.tps_status_word != 0) {
                                appendEventLocked(board.board_id, "INFO",
                                    board_name(board.board_id) +
                                    " TPS546D24A fault cleared");
                            }
                        }
                        if (telemetry.powerStateValid() &&
                            (first || !previous.powerStateValid() ||
                             previous.power_enabled != telemetry.power_enabled)) {
                            appendEventLocked(board.board_id, "INFO",
                                board_name(board.board_id) +
                                (telemetry.powerEnabled()
                                    ? " TPS546D24A power ON"
                                    : " TPS546D24A power OFF"));
                        }
                        break;
                    }
                }
            }
        } else if (type == MsgType::BoardHello) {
            BoardHello heartbeat{};
            if (decode_board_hello(payload, payload_len, heartbeat) &&
                heartbeat.board_id == board.board_id) {
                std::lock_guard<std::mutex> lock(m_mutex);
                for (auto& current : m_boards) {
                    if (current.info.board_id == board.board_id &&
                        current.connection_id == connection_id) {
                        current.info.asic_count = heartbeat.asic_count;
                        if (heartbeat.target_frequency_mhz != 0) {
                            current.info.target_frequency_mhz =
                                heartbeat.target_frequency_mhz;
                        }
                        if (heartbeat.actual_frequency_mhz != 0) {
                            current.info.actual_frequency_mhz =
                                heartbeat.actual_frequency_mhz;
                        }
                        const uint8_t previous_status = current.info.status;
                        current.info.status = heartbeat.status;
                        if (previous_status != heartbeat.status) {
                            appendEventLocked(board.board_id,
                                heartbeat.status == 0 ? "INFO" : "ERROR",
                                board_name(board.board_id) +
                                (heartbeat.status == 0 ? " fault cleared" :
                                 " reports fault status " +
                                 std::to_string(heartbeat.status)));
                        }
                        break;
                    }
                }
            }
        } else if (type == MsgType::LatencyProbe) {
            uint64_t token = 0;
            if (decode_latency_probe(payload, payload_len, token)) {
                const uint64_t completed_us = steady_time_us();
                std::lock_guard<std::mutex> lock(m_mutex);
                for (auto& current : m_boards) {
                    if (current.info.board_id == board.board_id &&
                        current.connection_id == connection_id &&
                        current.latency_pending &&
                        current.latency_token == token &&
                        completed_us >= current.latency_started_us) {
                        current.latency_ms =
                            (completed_us - current.latency_started_us) / 1000.0;
                        current.latency_pending = false;
                        current.latency_valid = true;
                        current.latency_updated = completed_us;
                        break;
                    }
                }
            }
        } else if (type == MsgType::Error && payload_len > 0) {
            std::string detail;
            if (payload_len > 1) {
                detail.assign(reinterpret_cast<const char*>(payload + 1),
                              payload_len - 1);
            }
            std::lock_guard<std::mutex> lock(m_mutex);
            appendEventLocked(board.board_id, "ERROR",
                board_name(board.board_id) + " error " +
                std::to_string(payload[0]) +
                (detail.empty() ? std::string() : ": " + detail));
        }
    }

    // Mark the board offline before releasing the socket handle so a
    // concurrent sendToBoard() can no longer obtain this connection's socket.
    {
        std::lock_guard<std::mutex> lock(m_mutex);
        for (auto& current : m_boards) {
            if (current.info.board_id == board.board_id &&
                current.connection_id == connection_id) {
                current.online = false;
                current.info.socket = INVALID_SOCKET;
                current.latency_pending = false;
                current.latency_valid = false;
                current.info.current_hashrate = 0.0;
                current.hashrate_1m = 0.0;
                current.hashrate_10m = 0.0;
                current.hashrate_updated = 0;
                appendEventLocked(board.board_id, "WARN",
                    board_name(board.board_id) + " offline: " + disconnect_reason);
                break;
            }
        }
        m_hashrate_samples.erase(board.board_id);
    }
    closesocket(sock);
}

void BoardManager::detectionLoop() {
    std::unique_lock<std::mutex> lock(m_detection_mutex);
    while (!m_stop) {
        const auto interval = std::chrono::milliseconds(
            m_detection_interval_ms.load());
        if (m_detection_cv.wait_for(lock, interval) !=
            std::cv_status::timeout) {
            continue;
        }
        lock.unlock();
        testAllBoardLatencies();
        lock.lock();
    }
}

bool BoardManager::setDetectionIntervalMs(uint32_t interval_ms) {
    if (interval_ms < 1000 || interval_ms > 3600000) return false;
    m_detection_interval_ms = interval_ms;
    m_detection_cv.notify_all();
    return true;
}

void BoardManager::appendEventLocked(uint64_t board_id,
                                     const std::string& level,
                                     const std::string& message) {
    BoardEvent event;
    event.timestamp = event_timestamp();
    event.level = level;
    event.board_id = board_id;
    event.message = message;
    m_events.push_back(std::move(event));
    while (m_events.size() > 200) m_events.pop_front();
}

std::vector<BoardEvent> BoardManager::getEvents() const {
    std::lock_guard<std::mutex> lock(m_mutex);
    return std::vector<BoardEvent>(m_events.begin(), m_events.end());
}

bool BoardManager::sendToBoard(uint64_t board_id,
                               const std::vector<uint8_t>& data,
                               bool count_as_job) {
    SOCKET socket = INVALID_SOCKET;
    uint64_t connection_id = 0;
    {
        std::lock_guard<std::mutex> lock(m_mutex);
        for (const auto& board : m_boards) {
            if (board.info.board_id == board_id && board.online) {
                socket = board.info.socket;
                connection_id = board.connection_id;
                break;
            }
        }
    }
    if (socket == INVALID_SOCKET) return false;

    bool sent = false;
    {
        std::lock_guard<std::mutex> send_lock(m_send_mutex);
        sent = send_all(socket, data.data(), data.size());
    }
    if (!sent) return false;

    if (count_as_job) {
        std::lock_guard<std::mutex> lock(m_mutex);
        for (auto& board : m_boards) {
            if (board.info.board_id == board_id && board.online &&
                board.connection_id == connection_id) {
                ++board.jobs_sent;
                board.last_job_time = platform::tick_ms();
                break;
            }
        }
    }
    return true;
}

bool BoardManager::sendJob(uint64_t board_id,
                           const std::vector<uint8_t>& data) {
    return sendToBoard(board_id, data, true);
}

void BoardManager::broadcastJob(const std::vector<uint8_t>& data) {
    const auto boards = getStats();
    for (const auto& board : boards) {
        if (board.online) sendToBoard(board.info.board_id, data, true);
    }
}

bool BoardManager::setBoardParams(uint64_t board_id, uint16_t freq_mhz,
                                  uint16_t voltage_mv) {
    return sendToBoard(board_id, encode_set_params(freq_mhz, voltage_mv), false);
}

bool BoardManager::setBoardVersionMask(uint64_t board_id,
                                       uint32_t version_mask) {
    return sendToBoard(board_id, encode_set_version_mask(version_mask), false);
}

bool BoardManager::setBoardFrequency(uint64_t board_id,
                                     uint16_t frequency_mhz) {
    if (frequency_mhz > 600) return false;
    return sendToBoard(board_id, encode_set_frequency(frequency_mhz), false);
}

bool BoardManager::setBoardPower(uint64_t board_id, bool enabled) {
    return sendToBoard(board_id, encode_set_power(enabled), false);
}

bool BoardManager::testBoardLatency(uint64_t board_id) {
    const uint64_t token = m_next_latency_token.fetch_add(1);
    const uint64_t started_us = steady_time_us();
    {
        std::lock_guard<std::mutex> lock(m_mutex);
        auto board = std::find_if(m_boards.begin(), m_boards.end(),
            [&](const BoardStats& current) {
                return current.info.board_id == board_id && current.online;
            });
        if (board == m_boards.end()) return false;
        if (board->latency_pending && board->latency_started_us != 0 &&
            started_us >= board->latency_started_us &&
            started_us - board->latency_started_us < 2000000ULL) {
            return false;
        }
        board->latency_token = token;
        board->latency_started_us = started_us;
        board->latency_updated = 0;
        board->latency_ms = 0.0;
        board->latency_pending = true;
        board->latency_valid = false;
    }

    if (sendToBoard(board_id, encode_latency_probe(token), false)) return true;

    std::lock_guard<std::mutex> lock(m_mutex);
    for (auto& board : m_boards) {
        if (board.info.board_id == board_id && board.latency_token == token) {
            board.latency_pending = false;
            board.latency_valid = false;
            break;
        }
    }
    return false;
}

size_t BoardManager::testAllBoardLatencies() {
    std::vector<uint64_t> board_ids;
    {
        std::lock_guard<std::mutex> lock(m_mutex);
        board_ids.reserve(m_boards.size());
        for (const auto& board : m_boards) {
            if (board.online) board_ids.push_back(board.info.board_id);
        }
    }

    size_t started = 0;
    for (uint64_t board_id : board_ids) {
        if (testBoardLatency(board_id)) ++started;
    }
    return started;
}

std::vector<BoardStats> BoardManager::getStats() const {
    std::lock_guard<std::mutex> lock(m_mutex);
    return m_boards;
}

void BoardManager::processHashrateSample(uint64_t board_id,
                                            uint32_t hashrate_mhs) {
    const uint64_t now = platform::tick_ms();
    const double ghs = static_cast<double>(hashrate_mhs) / 1000.0;

    std::lock_guard<std::mutex> lock(m_mutex);

    auto& samples = m_hashrate_samples[board_id];
    samples.emplace_back(now, ghs);
    while (!samples.empty() && now - samples.front().first > 600000) {
        samples.pop_front();
    }

    auto average_since = [&](uint64_t window_ms) {
        double sum = 0.0;
        size_t count = 0;
        for (const auto& sample : samples) {
            if (now - sample.first <= window_ms) {
                sum += sample.second;
                ++count;
            }
        }
        return count ? sum / static_cast<double>(count) : 0.0;
    };

    for (auto& board : m_boards) {
        if (board.info.board_id != board_id) continue;
        board.info.current_hashrate = ghs;
        board.hashrate_1m = average_since(60000);
        board.hashrate_10m = average_since(600000);
        board.hashrate_updated = now;
        break;
    }
}

void BoardManager::recordNonce(uint64_t board_id, double difficulty) {
    std::lock_guard<std::mutex> lock(m_mutex);
    for (auto& board : m_boards) {
        if (board.info.board_id != board_id) continue;
        ++board.nonces_returned;
        if (std::isfinite(difficulty) && difficulty > board.best_diff) {
            board.best_diff = difficulty;
        }
        break;
    }
}

void BoardManager::addAcceptedShare(uint64_t board_id) {
    std::lock_guard<std::mutex> lock(m_mutex);
    for (auto& board : m_boards) {
        if (board.info.board_id == board_id) {
            ++board.info.shares_accepted;
            board.last_share_accepted_ms = platform::tick_ms();
            break;
        }
    }
}

void BoardManager::addRejectedShare(uint64_t board_id) {
    std::lock_guard<std::mutex> lock(m_mutex);
    for (auto& board : m_boards) {
        if (board.info.board_id == board_id) {
            ++board.info.shares_rejected;
            break;
        }
    }
}
