TDX33029/BTCMinerControl/SWAP/BTCMinerMS_MultiASIC/Core/Inc/bm1366.h

 #ifndef __BM1366_H
 #define __BM1366_H
 
 #include "main.h"
 #include <stdint.h>

 /* Forward declaration: bm1366_send_job() consumes a decoded stratum job
    (defined in protocol.h, which #includes this header). Only the tag is
    needed here, avoiding a circular include. */
 struct protocol_job_t;

 /* ===== BM1366 常量 ===== */
 #define BM1366_CHIP_ID         0x1366
 #define BM1366_CHIP_ID_RESP_LEN 11
 
 #define BM1366_TYPE_JOB   0x20
 #define BM1366_TYPE_CMD   0x40
 #define BM1366_GROUP_SINGLE 0x00
 #define BM1366_GROUP_ALL    0x10
 
 #define BM1366_CMD_SETADDRESS 0x00
 #define BM1366_CMD_WRITE      0x01
 #define BM1366_CMD_READ       0x02
 #define BM1366_CMD_INACTIVE   0x03
 
 #define BM1366_NONCE_SPACE   0x100000000ULL  /* 2^32 */
 #define BM1366_FREQ_MULT     25.0f    /* was 50 -- matches ESP-Miner FREQ_MULT (ref clk 25MHz) */
 #define BM1366_DEFAULT_FREQ  200.0f
 #define BM1366_DEFAULT_DIFFICULTY 1   /* 默认难度掩码: 1 (每个 2^32 空间稳定产出 Nonce 用于联调) */
 
 /* BM1366 job packets are built on the fly in bm1366_send_job() from a
    protocol_job_t -- there is no fixed on-wire struct because the midstate
    count (and therefore the packet length) varies per job. The previous
    bm1366_job_t omitted the midstates and was layout-incompatible with
    protocol_job_t, so casting between them sent garbage to the ASIC. */
 #pragma pack(push, 1)
 
 /* BM1366 结果包结构 */
 typedef struct {
     uint16_t preamble;
     uint32_t nonce;
     uint8_t  midstate_num;
     uint8_t  job_id_raw;
     uint16_t version_raw;
     uint8_t  crc_and_flags;
 } bm1366_result_raw_t;
 #pragma pack(pop)
 
 /* 解析后的结果 */
 typedef struct {
     uint8_t  job_id;
     uint8_t  asic_nr;
     uint8_t  core_id;
     uint8_t  small_core_id;
     uint32_t nonce;
     uint32_t rolled_version;
 } bm1366_result_t;
 
 typedef struct {
     uint8_t  fb_divider;
     uint8_t  refdiv;
     uint8_t  postdiv1;
     uint8_t  postdiv2;
     float    actual_freq;
 } bm1366_pll_params_t;
 
 /* ===== 公开函数 ===== */
 void bm1366_uart_init(void);
 void bm1366_uart_set_baud(uint32_t baud);
 void bm1366_uart_send(const uint8_t *data, uint16_t len);
 uint16_t bm1366_uart_recv(uint8_t *buf, uint16_t max_len);
 uint16_t bm1366_uart_available(void);
 void bm1366_uart_flush(void);
 void bm1366_uart_isr_handler(void);
 
 void bm1366_send_cmd(uint8_t header, const uint8_t *data, uint8_t len);
 void bm1366_send_job(const struct protocol_job_t *job);
 void bm1366_send_raw(const uint8_t *data, uint8_t len);
 int  bm1366_read_any_result(bm1366_result_raw_t *result, uint32_t timeout_ms);
int  bm1366_read_result(bm1366_result_raw_t *result, uint32_t timeout_ms);
void bm1366_send_hash_counter_read(void);
void bm1366_read_chip_register(uint8_t asic_nr, uint8_t reg);
int  bm1366_init_chips(uint8_t expected_count, float target_freq_mhz);
 uint32_t bm1366_get_active_baud(void);
 float bm1366_set_frequency(float target_freq_mhz);
 uint16_t bm1366_apply_frequency(uint16_t target_freq_mhz);
 uint16_t bm1366_get_target_frequency(void);
 uint16_t bm1366_get_actual_frequency(void);
 void bm1366_frequency_transition(float target_freq_mhz, uint32_t step_delay_ms);
 void bm1366_set_voltage(uint8_t vdo_scale);
 void bm1366_set_version_mask(uint32_t mask);
 void bm1366_set_nonce_space(double nonce_percent, float frequency, uint16_t asic_count, uint16_t cores);
 void bm1366_set_difficulty_mask(uint16_t difficulty);
 void bm1366_read_registers(void);
 int  bm1366_count_chips(uint8_t expected_count, uint16_t timeout_ms);
 uint8_t bm1366_get_address_interval(void);
 uint8_t bm1366_get_chip_count(void);
uint32_t bm1366_get_bad_preamble(void);
uint32_t bm1366_get_bad_crc(void);
uint32_t bm1366_get_rx_total(void);
uint16_t bm1366_get_frame_errors(void);
uint16_t bm1366_get_overruns(void);
 uint8_t  bm1366_crc5(const uint8_t *data, uint8_t len);
 uint16_t bm1366_crc16(const uint8_t *data, uint16_t len);
 bm1366_pll_params_t bm1366_pll_calc(float target_freq_mhz, uint8_t ref_min, uint8_t ref_max);
 
 #endif
