TDX33029/BTCMinerControl/SWAP/HostServices/src/dispatch/manager.h

#pragma once

#include "protocol.h"
#include <atomic>
#include <condition_variable>
#include <deque>
#include <functional>
#include <mutex>
#include <thread>
#include <unordered_map>
#include <utility>
#include <vector>
#include "../platform/platform.h"

struct BoardStats {
    BoardInfo info{};
    uint64_t jobs_sent = 0;
    uint64_t nonces_returned = 0;
    double hashrate_1m = 0.0;
    double hashrate_10m = 0.0;
    double best_diff = 0.0;
    uint64_t hashrate_updated = 0;
    uint64_t last_share_accepted_ms = 0;
    uint64_t last_job_time = 0;
    uint64_t connected_since = 0;
    uint64_t connection_id = 0;
    BoardTelemetry telemetry{};
    uint64_t telemetry_updated = 0;
    uint64_t latency_token = 0;
    uint64_t latency_started_us = 0;
    uint64_t latency_updated = 0;
    double latency_ms = 0.0;
    bool latency_pending = false;
    bool latency_valid = false;
    bool online = false;
};

struct BoardEvent {
    std::string timestamp;
    std::string level;
    uint64_t board_id = 0;
    std::string message;
};

class BoardManager {
public:
    std::function<void(const NonceResult&)> onNonceResult;
    std::function<void(uint64_t, const AsicRegister&)> onAsicRegister;
    std::function<void(uint64_t)> onBoardConnected;

    BoardManager() = default;
    ~BoardManager();

    bool start(uint16_t port);
    void stop();

    bool sendJob(uint64_t board_id, const std::vector<uint8_t>& job_data);
    void broadcastJob(const std::vector<uint8_t>& job_data);
    bool setBoardParams(uint64_t board_id, uint16_t freq_mhz,
                        uint16_t voltage_mv);
    bool setBoardVersionMask(uint64_t board_id, uint32_t version_mask);
    bool setBoardFrequency(uint64_t board_id, uint16_t frequency_mhz);
    bool setBoardPower(uint64_t board_id, bool enabled);
    bool testBoardLatency(uint64_t board_id);
    size_t testAllBoardLatencies();
    bool setDetectionIntervalMs(uint32_t interval_ms);
    uint32_t detectionIntervalMs() const {
        return m_detection_interval_ms.load();
    }

    std::vector<BoardStats> getStats() const;
    std::vector<BoardEvent> getEvents() const;
    void recordNonce(uint64_t board_id, double difficulty);
    void addAcceptedShare(uint64_t board_id);
    void addRejectedShare(uint64_t board_id);

    bool isRunning() const { return m_running; }
    uint16_t port() const { return m_port; }

private:
    void acceptLoop();
    void detectionLoop();
    void recvLoop(SOCKET sock, BoardInfo board, uint64_t connection_id,
                  MessageReader reader);
    bool sendToBoard(uint64_t board_id, const std::vector<uint8_t>& data,
                     bool count_as_job);
    void appendEventLocked(uint64_t board_id, const std::string& level,
                           const std::string& message);
    void processHashrateSample(uint64_t board_id, uint32_t hashrate_mhs);

    SOCKET m_listen_sock = INVALID_SOCKET;
    std::atomic<bool> m_running{false};
    std::atomic<bool> m_stop{false};
    std::atomic<uint64_t> m_next_connection_id{1};
    std::atomic<uint64_t> m_next_latency_token{1};
    uint16_t m_port = 0;
    std::thread m_accept_thread;
    std::thread m_detection_thread;
    std::atomic<uint32_t> m_detection_interval_ms{5000};
    std::mutex m_detection_mutex;
    std::condition_variable m_detection_cv;

    mutable std::mutex m_mutex;
    std::vector<BoardStats> m_boards;
    std::unordered_map<uint64_t,
        std::deque<std::pair<uint64_t, double>>> m_hashrate_samples;
    std::deque<BoardEvent> m_events;

    // WinSock permits concurrent send calls, but byte streams can interleave.
    std::mutex m_send_mutex;
    std::mutex m_threads_mutex;
    std::vector<std::thread> m_receiver_threads;
};
