TDX33029/BTCMinerControl/SWAP/HostServices/src/dispatch/protocol.h

#pragma once
#include <cstdint>
#include <vector>
#include <string>
#include <array>
#include "../platform/platform.h"

// ---------------------------------------------------------------------------
// Binary protocol for PC ↔ STM32 board communication over TCP.
//
// Frame format (big-endian):
//   [Length:4B] [Type:1B] [Payload:N bytes]
//
// Message types:
//   0x01 PC→Board: Job
//   0x02 Board→PC: Nonce result
//   0x03 Board→PC: ASIC register
//   0x04 Board→PC: Register/Heartbeat
//   0x05 PC→Board: Set frequency/voltage
//   0x06 PC→Board: ACK
//   0x07 Board→PC: Power/temperature telemetry
//   0x08 PC→Board: Set ASIC power
//   0x09 Both: Latency probe/echo
//   0x0A PC→Board: Set BM1366 version-rolling mask
//   0x0B Board→PC: Measured hashrate sample (MH/s)
//   0x0C PC→Board: Set ASIC frequency (MHz)
//   0x0D Board→PC: ASIC frequency status
//   0xFF Both: NACK/Error
// ---------------------------------------------------------------------------

// Forward declare
struct MinerJob;
struct NonceResult;

// Message type constants
enum class MsgType : uint8_t {
    Job          = 0x01,
    NonceResult  = 0x02,
    AsicRegister = 0x03,
    BoardHello   = 0x04,
    SetParams    = 0x05,
    Ack          = 0x06,
    BoardTelemetry = 0x07,
    SetPower      = 0x08,
    LatencyProbe  = 0x09,
    SetVersionMask = 0x0A,
    HashrateSample = 0x0B,
    SetFrequency  = 0x0C,
    FrequencyStatus = 0x0D,
    Error        = 0xFF,
};

// Board registration info
struct BoardInfo {
    uint64_t    board_id;
    uint8_t     asic_count;
    uint16_t    firmware_version;
    uint8_t     status;          // 0=ok, 1=warning, 2=error
    uint16_t    target_frequency_mhz;
    uint16_t    actual_frequency_mhz;
    SOCKET      socket;
    std::string ip_addr;
    uint64_t    last_heartbeat;
    uint64_t    shares_accepted;
    uint64_t    shares_rejected;
    double      current_hashrate; // GH/s
};

// Board register/heartbeat from board
struct BoardHello {
    uint64_t board_id;
    uint8_t  asic_count;
    uint16_t fw_version;
    uint8_t  status;
    uint16_t target_frequency_mhz;
    uint16_t actual_frequency_mhz;
};

// ASIC register read from board
struct AsicRegister {
    uint8_t asic_nr;
    uint8_t register_type;
    uint32_t value;
};

struct BoardTelemetry {
    uint8_t flags = 0;
    uint8_t tps_address = 0;
    uint8_t tmp1075_address = 0;
    uint8_t power_enabled = 0;
    uint16_t vout_mv = 0;
    uint32_t iout_ma = 0;
    uint32_t power_mw = 0;
    int16_t tmp1075_temperature_centi_c = 0;
    int16_t tps_temperature_centi_c = 0;
    uint16_t tps_status_word = 0;

    bool tpsDetected() const { return (flags & 0x01U) != 0; }
    bool tmp1075Detected() const { return (flags & 0x02U) != 0; }
    bool tpsValid() const { return (flags & 0x04U) != 0; }
    bool tmp1075Valid() const { return (flags & 0x08U) != 0; }
    bool powerStateValid() const { return (flags & 0x10U) != 0; }
    bool powerEnabled() const { return powerStateValid() && power_enabled != 0; }
};

// Encode a job into the binary wire format.
// Returns the complete framed message ready to send.
std::vector<uint8_t> encode_job(const MinerJob& job);

// Decode a nonce result from the binary wire format.
// Returns true on success.
bool decode_nonce_result(const uint8_t* data, size_t len, NonceResult& out);

// Decode a board hello message.
bool decode_board_hello(const uint8_t* data, size_t len, BoardHello& out);

// Decode an ASIC register message.
bool decode_asic_register(const uint8_t* data, size_t len, AsicRegister& out);

// Decode a measured hashrate sample (megahash/s fixed point).
bool decode_hashrate_sample(const uint8_t* data, size_t len, uint32_t& mhs);

// Encode a frequency-only adjustment command (MHz).
std::vector<uint8_t> encode_set_frequency(uint16_t frequency_mhz);

// Decode the board's applied/actual frequency status.
bool decode_frequency_status(const uint8_t* data, size_t len,
                             uint16_t& target_mhz, uint16_t& actual_mhz);

// Decode board power/temperature telemetry (20-byte payload).
bool decode_board_telemetry(const uint8_t* data, size_t len,
                            BoardTelemetry& out);

// Encode a frequency/voltage setting command.
std::vector<uint8_t> encode_set_params(uint16_t freq_mhz, uint16_t voltage_mv);

// Encode the BIP-310 version-rolling mask for the BM1366 chip.
std::vector<uint8_t> encode_set_version_mask(uint32_t version_mask);

// Enable or disable the TPS546D24A output on one board.
std::vector<uint8_t> encode_set_power(bool enabled);

// Echoed by the board so the host can measure TCP round-trip latency.
std::vector<uint8_t> encode_latency_probe(uint64_t token);
bool decode_latency_probe(const uint8_t* data, size_t len, uint64_t& token);

// Encode an ACK message.
std::vector<uint8_t> encode_ack(uint8_t ack_type);

// Encode an error message.
std::vector<uint8_t> encode_error(uint8_t code, const std::string& msg);

enum class ReceiveResult {
    Message,
    Timeout,
    Closed,
    SocketError,
    ProtocolError,
};

// Stateful TCP frame reader. Partial length fields and payloads remain in the
// buffer across receive timeouts, and coalesced frames are returned one by one.
class MessageReader {
public:
    ReceiveResult receive(SOCKET sock, std::vector<uint8_t>& message,
                          int timeout_ms = 500);
    void clear() { m_buffer.clear(); }

private:
    static constexpr uint32_t kMaxMessageLength = 4096;
    std::vector<uint8_t> m_buffer;
};
