TDX33029/BTCMinerControl/(commit log)

2026-07-10 第一版本提交
2026-07-11 add more
    [21-0164B_L622-1_MXM.step, 2R5TPE220MAFB.step, 3225-oscillator.step, 470531000.stp, 54-00164.STEP, 74437358010.stp, 7770-ScrewTerminal.step, Bitaxe_Heatsink.step]
2026-07-11 fix fatal error
    [partitions.csv]
2026-07-17 PCBLayout完成
    [21-0164B_L622-1_MXM.step, 2R5TPE220MAFB.step, 3225-oscillator.step, 470531000.stp, 74437358010.stp, 7770-ScrewTerminal.step, CSD17577Q5A.stp, CX3225SB16000H0FLJCC.STEP]
2026-07-17 未经验证的测试版本，可能存在风险
2026-07-24 feat: LwIP integration, DP83848KSQ fix, main loop while(1) fix
    - Integrate LwIP 2.x with NO_SYS=1 for bare-metal TCP/IP stack
    - Add eth_netif.c: LwIP netif driver using existing DMA descriptors
    - Add sys_arch.c: bare-metal sys_now() implementation
    - Add lwipopts.h: minimal LwIP configuration for TCP client
    - Fix critical missing while(1) loop in main loop body
    - Add eth_poll() to service LwIP timers and PHY link status
    - Implement eth_connect/send/recv using LwIP raw TCP API
    - Add TCP receive ring buffer for protocol message assembly
    - Replace deprecated MX_GPIO_Init_Ext with CubeMX-compatible init
    - Fix PHY ID check to accept DP83848KSQ (0x2000:0x5C90)
    - Fix SMI register field corruption (P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
    [BTCMinerMS.ioc, bm1366.c, bm1366.h, debug_serial.c]
2026-07-24 fix: add sys_arch_protect, udp.c to LwIP group, set LWIP_UDP=1
    [lwipopts.h, sys_arch.c]
2026-07-24 fix: LWIP_UDP=0 with stubs in sys_arch.c, remove uvprojx dependency
    [lwipopts.h, sys_arch.c]
2026-07-24 fix: set netif link UP in eth_init so TCP SYN is not dropped by etharp_output
    [eth_drv.c]
2026-07-24 fix: PC_IP to 26.8.1.11, add eth_netif.h include, subnet back to 255.255.255.0
    [main.c]
2026-07-24 fix: PC_IP3=11, #endif, eth_netif.h decl, lwipopts.h HAL include
    [eth_netif.h, lwipopts.h, main.c]
2026-07-24 add DMA status register debug to diagnose rx=0 tx=0
2026-07-24 fix: DMA soft reset before ETH_DMA_Init to clear HAL_ETH_Init bus error state
2026-07-24 fix: ETH_MAC_Init after ethernetif_dma_init so DMA soft reset doesn't clear MACCR
    [eth_drv.c]
2026-07-24 fix: clear DMASR sticky status bits after DMA soft reset
2026-07-24 debug: print descriptor and buffer addresses to diagnose FBE
2026-07-24 add DMASR after-clear verification print
2026-07-25 设备同步
2026-07-26 测试通过备份
2026-07-28 废弃的旧版测试文件
2026-08-05 网络完备
    [QFN-44-1EP_8x8mm_P0.65mm_EP6.6x6.6mm.step]
2026-08-16 全链路测试通过
2026-08-30 Update README with network communication details
    Added details about network communication and device management.
2026-09-18 测试固件提交
2026-09-26 docs: add English README and bilingual language switcher
    - Add language switch links at the top of README.md and README_EN.md
    - Provide complete English translation in README_EN.md
    - Preserve all original technical specifications, diagrams, and licenses
