TDX33029/BTCMinerControl/(notices)

Notices in the files:
Miner/BM1397-master/BM1397-master/cad/QFN-44-1EP_8x8mm_P0.65mm_EP6.6x6.6mm.step:
Copyright (C) 2017, kicad StepUp
This program is free software: you can redistribute it and/or modify
it under the terms of the GNU General Public License as published by
the Free Software Foundation, either version 3 of the License, or
any later version.
itself might be covered by the GNU General Public License.
PCB/Original/ultraHex-master/ultraHex-master/_restore_backup_2026-07-17T15-32-36-407/3d/FTSH-105-01-F-DV-K.stp:
author */ ('License CC BY-ND 4.0'),
README.md:
License: Non-Commercial
